1847123212/RK3588_hdk/README.md

# RK3588_hdk
RK3588_hdk quad A76 &amp; quad A53
