1847123212/RK3588_hdk/RK3588/01_Official Release/04_Product Line Branch_NVR/04_Demo Reference Design/RK_NVR_DEMO1_RK3588_LP4XD200P232SD8_V21_20211228_final_lint阻抗叠层.xls

Sheet: 1.6通孔
8层通孔1.6+/-0.16mm |  |  |  |  | Impedance | 40 ohm | 50 ohm | 80 ohm | 85 ohm | 90 ohm | 100 ohm
Layer | Mother Board | Typical layer thickness (mil) | Dielectric Constant | DF | Reference Layer | Design W(mil)
 | Solder Mask | 1.10
L1 | 1/3oz+plating | 1.20 |  |  | L1->L2 | 5 | 3.4 | 4->4 | 3.7->4.3 | 3.3->4.7 | 3->8
 | Prepreg (106) | 2.10 | 4.00 | 0.019 | L1->L3 |  | 22
L2 | copper | 1.20
 | Core | 10.00 | 4.2 | 0.015
L3 | copper | 1.20
 | Prepreg (1080 ) | 2.70 | 4.00 | 0.019
L4 | copper | 1.20 |  |  | L4->L3/L5 | 5.5 | 3.5 | 3.8->4.2 | 3.5->4.5 | 3.1->4.9 | 3->8
 | Core | 22.00 | 4.2 | 0.015
L5 | copper | 1.20
 | Prepreg (1080 ) | 2.70 | 4.00 | 0.019
L6 | copper | 1.20 |  |  | L6->L5/L7 | 5 | 3.2 | 3.8->4.2 | 3.4->4.6 | 3.0->5.0 | 3->10
 | Core | 10.00 | 4.2 | 0.015
L7 | copper | 1.20
 | Prepreg (106) | 2.10 | 4.00 | 0.019
L8 | 1/3oz+plating | 1.20 |  |  | L8->L7 | 5 | 3.4 | 4->4 | 3.7->4.3 | 3.3->4.7 | 3->8
 | Solder Mask | 1.10
 |  | 63.40
 |  | 1.61

Sheet: 阻抗计算
单端L1 /L8 40 Ohm | 单端L1 /L8 50 Ohm | L1 /L8 80 Ohm | L1 /L8 85 Ohm | L1 /L8 90 Ohm | L1 /L8 100 Ohm
单端L4 40 Ohm | 单端L4 50 Ohm | L4 80 Ohm | L4 85 Ohm | L4 90 Ohm | L4 100 Ohm
单端L6 40 Ohm | 单端L6 50 Ohm | L6 80 Ohm | L6 85 Ohm | L6 90 Ohm | L6 100 Ohm
 | 单端L1 50 Ohm
