1847123212/RK3588_hdk/RK3588/01_Official Release/02_DDR Template/02_H1R0_V10_20211230/RK3588_Template_LP4XD200P232SD8_41R0X41R0_2133MHz_H1R0_V10_20211230阻抗叠层.xls

Sheet: 1.0通孔
8层通孔1.0+/-0.1mm |  |  |  |  | Impedance | 40 ohm | 50 ohm | 80 ohm | 85 ohm | 90 ohm | 100 ohm
Layer | Mother Board | Typical layer thickness (mil) | Dielectric Constant | DF | Reference Layer | Design W(mil)
 | Solder Mask | 1.10
L1 | 1/3oz+plating | 1.20 |  |  | L1->L2 | 5 | 3.4 | 4->4 | 3.7->4.3 | 3.3->4.7 | 3->8
 | Prepreg (106) | 2.10 | 4.00 | 0.019 | L1->L3 |  | 13
L2 | copper | 1.20
 | Core | 5.00 | 4.2 | 0.015
L3 | copper | 1.20
 | Prepreg (2116 ) | 3.50 | 4.00 | 0.019
L4 | copper | 1.20 |  |  | L4->L3/L5 | 5.5 | 3.8 | 4.1->3.9 | 3.7->4.3 | 3.4->4.6 | 3.2->7.8
 | Core | 8.00 | 4.2 | 0.015
L5 | copper | 1.20
 | Prepreg (2116 ) | 3.50 | 4.00 | 0.019
L6 | copper | 1.20 |  |  | L6->L5/L7 | 5 | 3 | 3.9->4.1 | 3.5->4.5 | 3.2->4.8 | 3->10
 | Core | 5.00 | 4.2 | 0.015
L7 | copper | 1.20
 | Prepreg (106) | 2.10 | 4.00 | 0.019
L8 | 1/3oz+plating | 1.20 |  |  | L8->L7 | 5 | 3.4 | 4->4 | 3.7->4.3 | 3.3->4.7 | 3->8
 | Solder Mask | 1.10
 |  | 41.00
 |  | 1.04

Sheet: 阻抗计算
单端L1 /L8 40 Ohm | 单端L1 /L8 50 Ohm |  | L1 /L8 80 Ohm | L1 /L8 85 Ohm | L1 /L8 90 Ohm | L1 /L8 100 Ohm
单端L4 40 Ohm | 单端L4 50 Ohm |  | L4 80 Ohm | L4 85 Ohm | L4 90 Ohm | L4 100 Ohm
单端L6 40 Ohm | 单端L6 50 Ohm |  | L6 80 Ohm | L6 85 Ohm | L6 90 Ohm | L6 100 Ohm
 | 单端L1 50 Ohm | 参考第三层
