1847123212/RK3588_hdk/RK3588/01_Official Release/03_Product Line Branch_AIoT/03_Reference Design/01_RK3588_AIoT_REF_SCH/RK3588_AIOT_REF_SCH_V10_20211228.pdf

# Reference Schematics For RK3588

# RK3588_AIOT_REF_SCH_V10

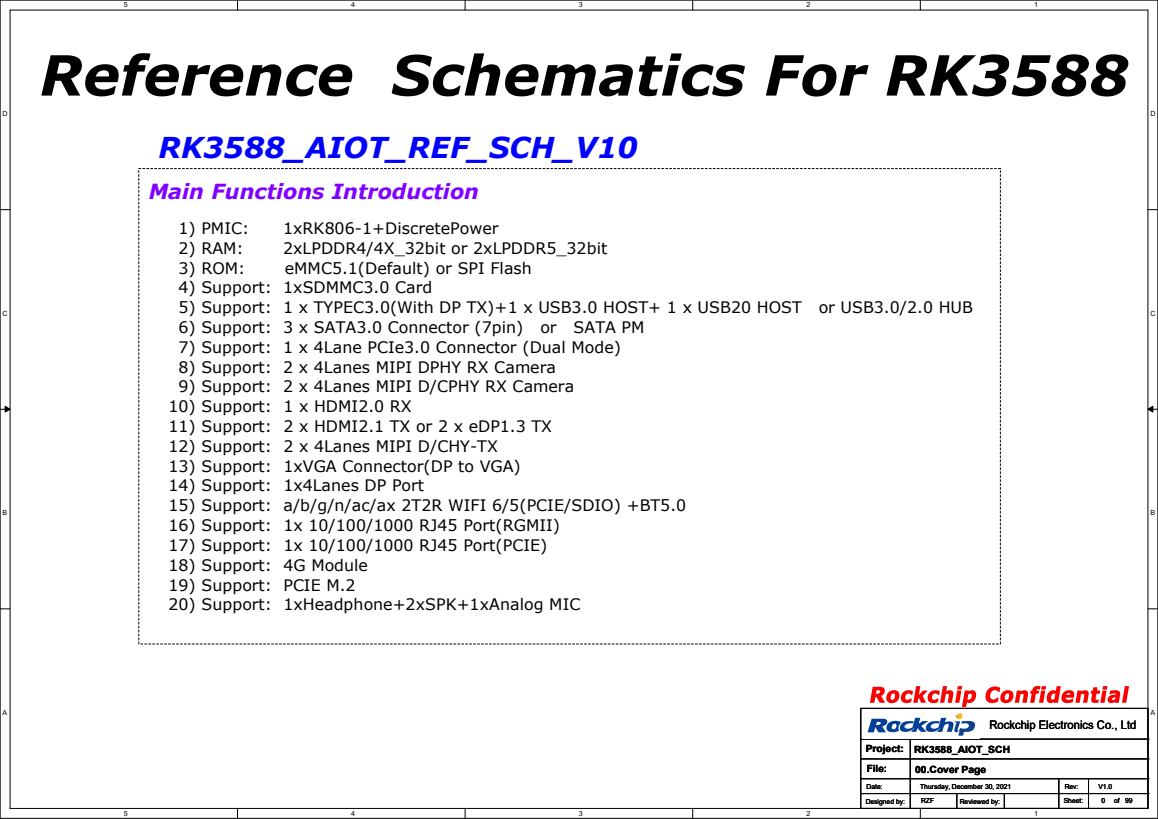
[picture p1: page 1]
1) PMIC:; 1xRK806-1+DiscretePower; 2) RAM:; 2xLPDDR4/4X_32bit or 2xLPDDR5_32bit; 3) ROM:; eMMC5.1(Default) or SPI Flash; Project:; File: Date:; Rockchip Electronics Co., Ltd; Designed by:; Rev: Reviewed by:; Sheet:; of Thursday, December 30, 2021; 00.Cover Page; RK3588_AIOT_SCH; RZF; 99 V1.0 Project:

Main Functions Introduction

4) Support: 1xSDMMC3.0 Card
5) Support: 1 x TYPEC3.0(With DP TX)+1 x USB3.0 HOST+ 1 x USB20 HOST or USB3.0/2.0 HUB
6) Support: 3 x SATA3.0 Connector (7pin) or SATA PM
7) Support: 1 x 4Lane PCIe3.0 Connector (Dual Mode)
8) Support: 2 x 4Lanes MIPI DPHY RX Camera
9) Support: 2 x 4Lanes MIPI D/CPHY RX Camera
10) Support: 1 x HDMI2.0 RX
11) Support: 2 x HDMI2.1 TX or 2 x eDP1.3 TX
12) Support: 2 x 4Lanes MIPI D/CHY-TX
13) Support: 1xVGA Connector(DP to VGA)
14) Support: 1x4Lanes DP Port
15) Support: a/b/g/n/ac/ax 2T2R WIFI 6/5(PCIE/SDIO) +BT5.0
16) Support: 1x 10/100/1000 RJ45 Port(RGMII)
17) Support: 1x 10/100/1000 RJ45 Port(PCIE)
18) Support: 4G Module
19) Support: PCIE M.2
20) Support: 1xHeadphone+2xSPK+1xAnalog MIC

# Table of Content

# Page 2

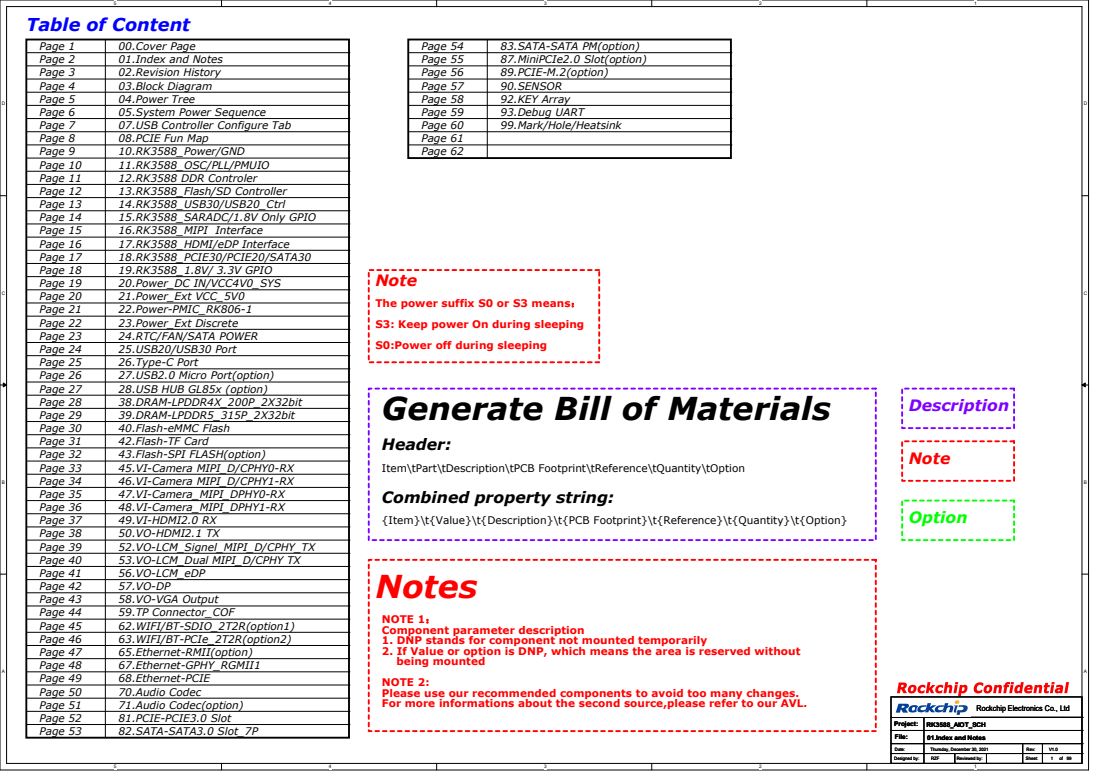
[picture p2: page 2]
Header:; Page 3 Page 4 Page 5 Page 6 Page 7 Page 8 Page 9 Page 10 Page 11 Page 12 Page 13 Page 14 Page 15 Page 16 Page 17 Page 18 Page 19 Page 20 Page 21 Page 22 Page 23 Page 24 Page 25 Page 26 Page 27 Page 28 Page 29 Page 30 Page 31 Page 32 Page 33 Page 34 Page 35 Page 36 Page 37 Page 38; Page 1; Page 39 Page 40 Page 41 Page 42 Page 43 Page 44; Note; Option; Description; Page 45 Page 46 Page 47 Page 48; Page 50 Page 51 Page 52 Page 53; Page 54; Page 56 Page 57 Page 58; Page 55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

00.Cover Page
01.Index and Notes
02.Revision History
03.Block Diagram
04.Power Tree
05.System Power Sequence
07.USB Controller Configure Tab
08.PCIE Fun Map
10.RK3588_Power/GND
11.RK3588_OSC/PLL/PMUIO
12.RK3588 DDR Controler
13.RK3588_Flash/SD Controller
14.RK3588_USB30/USB20_Ctrl
15.RK3588_SARADC/1.8V Only GPIO
16.RK3588_MIPI Interface
17.RK3588_HDMI/eDP Interface
18.RK3588_PCIE30/PCIE20/SATA30
19.RK3588_1.8V/ 3.3V GPIO
20.Power_DC IN/VCC4V0_SYS
21.Power_Ext VCC_5V0
22.Power-PMIC_RK806-1
23.Power_Ext Discrete
24.RTC/FAN/SATA POWER
25.USB20/USB30 Port
26.Type-C Port
27.USB2.0 Micro Port(option)
28.USB HUB GL85x (option)
38.DRAM-LPDDR4X_200P_2X32bit
39.DRAM-LPDDR5_315P_2X32bit
40.Flash-eMMC Flash
42.Flash-TF Card
43.Flash-SPI FLASH(option)
45.VI-Camera MIPI_D/CPHY0-RX
46.VI-Camera MIPI_D/CPHY1-RX
47.VI-Camera_MIPI_DPHY0-RX
48.VI-Camera_MIPI_DPHY1-RX
49.VI-HDMI2.0 RX
50.VO-HDMI2.1 TX
52.VO-LCM_Signel_MIPI_D/CPHY_TX
53.VO-LCM_Dual MIPI_D/CPHY TX
56.VO-LCM_eDP
58.VO-VGA Output
59.TP Connector_COF
62.WIFI/BT-SDIO_2T2R(option1)
63.WIFI/BT-PCIe_2T2R(option2)
65.Ethernet-RMII(option)
67.Ethernet-GPHY_RGMII1
68.Ethernet-PCIE
70.Audio Codec
71.Audio Codec(option)
81.PCIE-PCIE3.0 Slot
82.SATA-SATA3.0 Slot_7P

83.SATA-SATA PM(option)
87.MiniPCIe2.0 Slot(option)
89.PCIE-M.2(option)
90.SENSOR
92.KEY Array
93.Debug UART
99.Mark/Hole/Heatsink

The power suffix S0 or S3 means：
S3: Keep power On during sleeping
S0:Power off during sleeping
Generate Bill of Materials

Item\tPart\tDescription\tPCB Footprint\tReference\tQuantity\tOption
Combined property string:

{Item}\t{Value}\t{Description}\t{PCB Footprint}\t{Reference}\t{Quantity}\t{Option}
Notes

NOTE 1：
Component parameter description
1. DNP stands for component not mounted temporarily
2. If Value or option is DNP, which means the area is reserved without
being mounted
NOTE 2:
Please use our recommended components to avoid too many changes.
For more informations about the second source,please refer to our AVL.

01.Index and Notes RK3588_AIOT_SCH

# Revision History

# Version

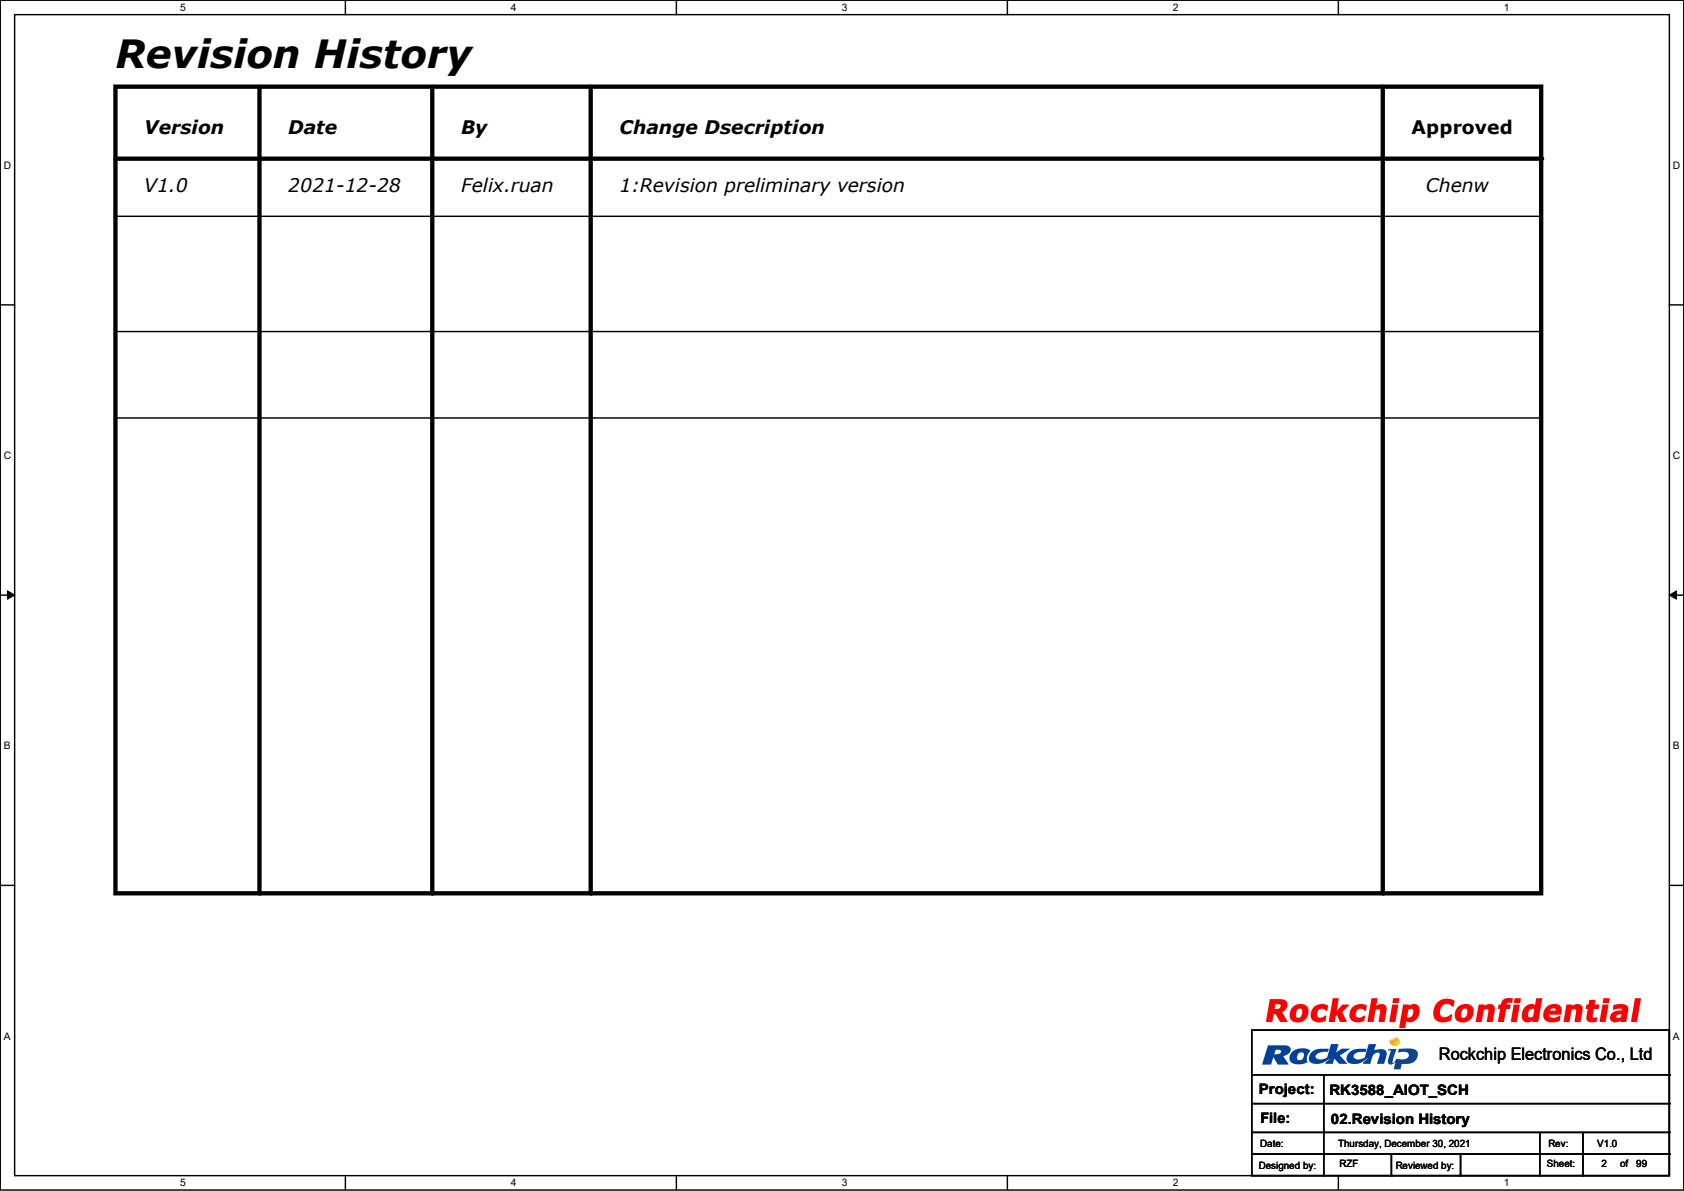
[picture p3: page 3]
Date; Change Dsecription; Approved; Felix.ruan; Chenw 1:Revision preliminary version; Project:; File: Date:; Rockchip Electronics Co., Ltd; 02.Revision History; RK3588_AIOT_SCH; RZF; 99 V1.0 Project:

# VGA Port USB2.0_HOST

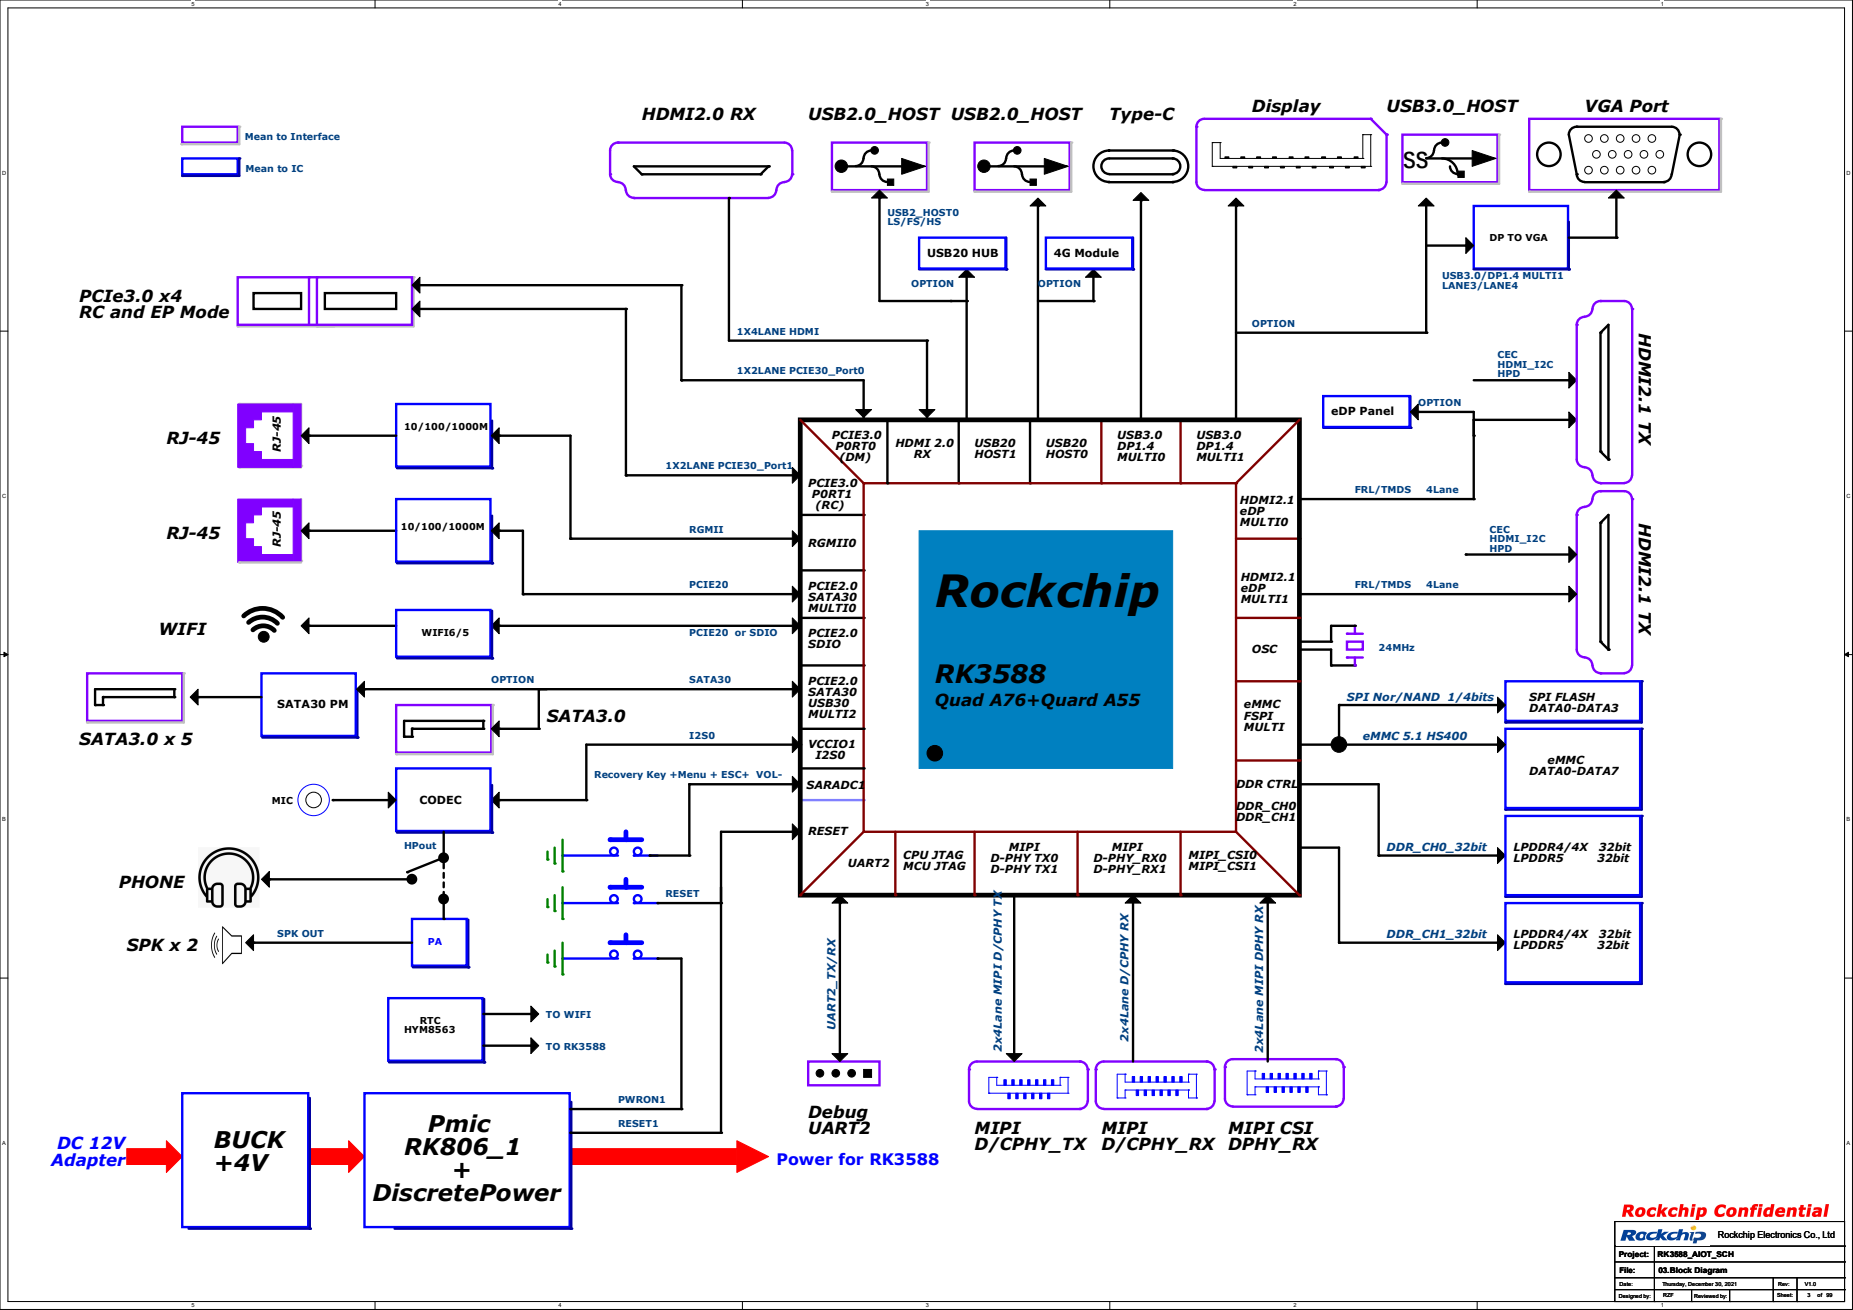
[picture p4: page 4]
RESET; Pmic RK806_1 + DiscretePower; Power for RK3588; SATA3.0 x 5; Rockchip; Quad A76+Quard A55; HDMI2.1 eDP MULTI0; USB20 HOST0; OSC; VCCIO1 I2S0; SARADC1; UART2; DDR CTRL; DDR_CH0 DDR_CH1; 24MHz; DC 12V Adapter; Recovery Key +Menu + ESC+ VOL-; 2x4Lane MIPI DPHY RX; HDMI2.1 eDP MULTI1; CEC HDMI_I2C; HPD; HDMI2.1 TX; eMMC FSPI; MULTI; HDMI2.1 TX CEC; HDMI_I2C HPD; USB3.0 DP1.4 MULTI0; USB3.0 DP1.4 MULTI1; USB3.0_HOST; USB3.0/DP1.4 MULTI1 LANE3/LANE4; FRL/TMDS; 4Lane; DDR_CH0_32bit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

Mean to Interface

Mean to IC

USB2_HOST0

DP TO VGA

PCIe3.0 x4
RC and EP Mode

SPI Nor/NAND 1/4bits

# Power Tree

# 3000mA or

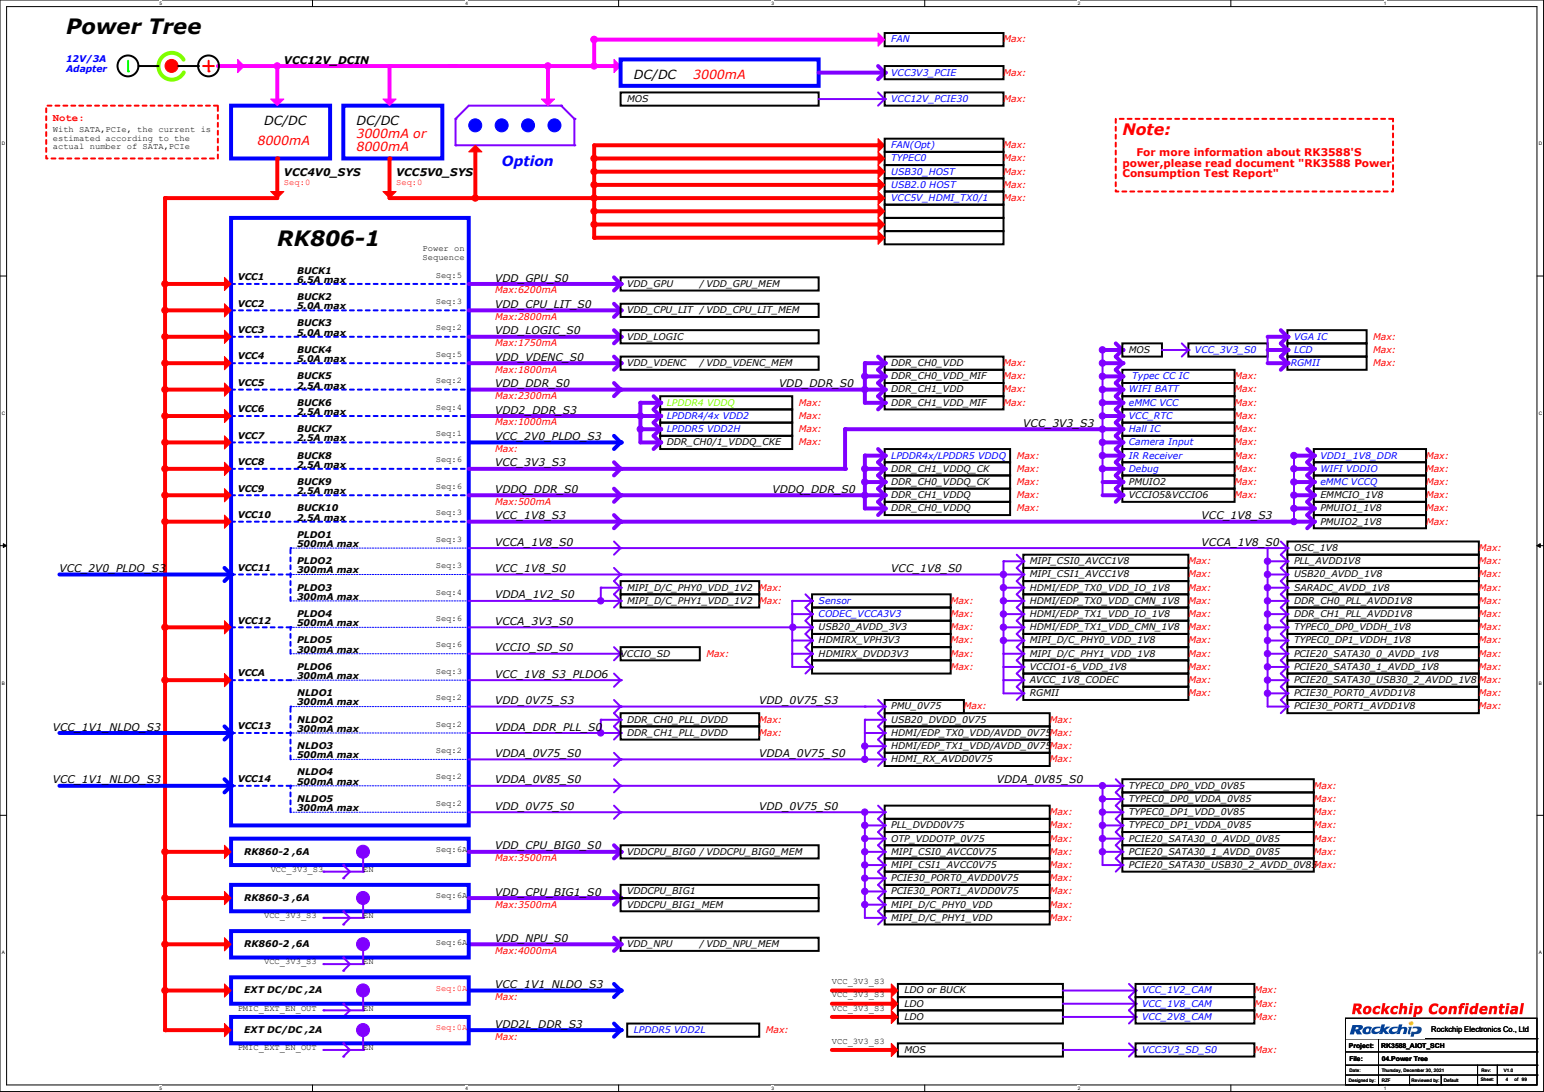
[picture p5: page 5]
12V/3A Adapter; VCC12V_DCIN; Seq:0; Option; USB2.0 HOST; VCC5V_HDMI_TX0/1; Max:; USB30_HOST; TYPEC0; VCC5V0_SYS; actual number of SATA,PCIe; VCC4V0_SYS; FAN(Opt); DDR_CH0_VDD_MIF; DDR_CH0_VDD; DDR_CH1_VDD_MIF; DDR_CH1_VDD; VCC_3V3_S3; Max: Max: Max: Max:; DDR_CH0/1_VDDQ_CKE; Power on Sequence; Seq:3; Seq:5; LPDDR4/4x VDD2; LPDDR4 VDDQ Seq:2; VCC1; BUCK3 5.0A max; BUCK4 5.0A max; BUCK1 6.5A max; VCC2; BUCK2; 5.0A max; VCC3; VCC4; Seq:4; Seq:2; Seq:1; VCC5; BUCK7 2.5A max; BUCK8; 2.5A max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

Note: With SATA,PCIe, the current is

DC/DC Seq:0

estimated according to the

For more information about RK3588'S
power,please read document "RK3588 Power
Consumption Test Report"

Typec CC IC
WIFI BATT
eMMC VCC
VCC_RTC
Hall IC
Camera Input
IR Receiver
Debug
PMUIO2

LDO or BUCK

# Power Sequence

Power Supply | PMIC Channel | Supply Limit | Power Name | Time Slot | Default Voltage | Default ON/OFF | Sleep ON/OFF | Peak Current | Sleep Current

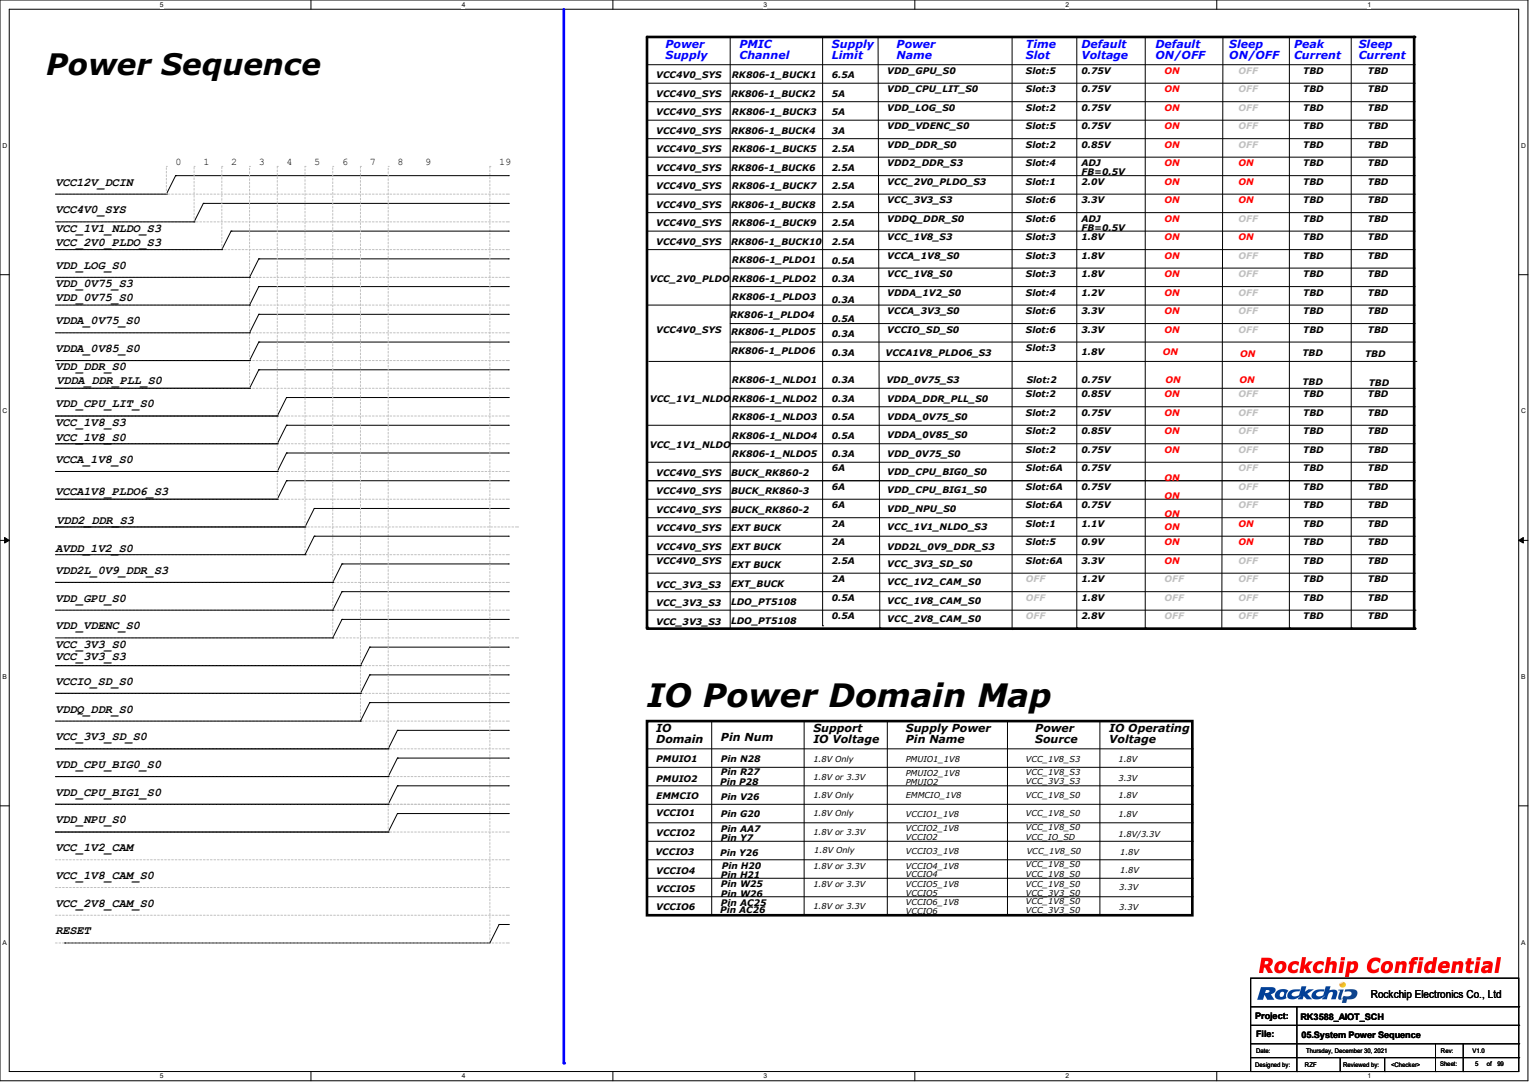
[picture p6: page 6]
VDDA_0V75_S0; VDD_DDR_S0; TBD TBD; TBD; RK806-1_BUCK5; RK806-1_NLDO3; VCC4V0_SYS; OFF; IO Domain; Supply Power; Pin Num; Pin Name; PMUIO1; IO Operating Voltage; Power Source; Support IO Voltage; Pin N28; PMUIO1_1V8; VCC_1V8_S3; PMUIO2; EMMCIO; VCCIO1; VCCIO2; VCCIO4; VCCIO5; VCCIO6; PMUIO2_1V8 PMUIO2 EMMCIO_1V8; VCCIO1_1V8 VCCIO2_1V8 VCCIO2; VCCIO4_1V8 VCCIO4 VCCIO5_1V8 VCCIO5; VCCIO6_1V8; VCC_1V8_S3 VCC_3V3_S3 VCC_1V8_S0; VCC_1V8_S0 VCC_1V8_S0; Pin P28; Pin R27; Pin V26; Pin Y7; Pin AA7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

VCC4V0_SYS | RK806-1_BUCK1 | 6.5A | VDD_GPU_S0 | Slot:5 | 0.75V | ON | OFF | TBD | TBD
VCC4V0_SYS | RK806-1_BUCK2 | 5A | VDD_CPU_LIT_S0 | Slot:3 | 0.75V | ON | OFF | TBD | TBD
VCC4V0_SYS | RK806-1_BUCK3 | 5A | VDD_LOG_S0 | Slot:2 | 0.75V | ON | OFF | TBD | TBD
VCC4V0_SYS | RK806-1_BUCK4 | 3A | VDD_VDENC_S0 | Slot:5 | 0.75V | ON | OFF | | TBD

VCC4V0_SYS | RK806-1_BUCK6 | 2.5A | VDD2_DDR_S3 | Slot:4 | ADJ FB=0.5V | ON | ON | TBD | TBD
VCC4V0_SYS | RK806-1_BUCK7 | 2.5A | VCC_2V0_PLDO_S3 | Slot:1 | 2.0V | ON | ON | TBD | TBD
VCC4V0_SYS | RK806-1_BUCK8 | 2.5A | VCC_3V3_S3 | Slot:6 | 3.3V | ON | ON | | TBD
VCC4V0_SYS | RK806-1_BUCK9 | 2.5A | VDDQ_DDR_S0 | Slot:6 | ADJ FB=0.5V | ON | OFF | | TBD
VCC4V0_SYS | RK806-1_BUCK10 | 2.5A | VCC_1V8_S3 | Slot:3 | 1.8V | ON | ON | TBD | TBD
VCC_2V0_PLDO | RK806-1_PLDO1 | 0.5A | VCCA_1V8_S0 | Slot:3 | 1.8V | ON | OFF | | TBD

RK806-1_PLDO2 | 0.3A | VCC_1V8_S0 | Slot:3 | 1.8V | ON | OFF | | TBD
RK806-1_PLDO3 | 0.3A | VDDA_1V2_S0 | Slot:4 | 1.2V | ON | OFF | TBD | TBD

VCC4V0_SYS | RK806-1_PLDO4 | 0.5A | VCCA_3V3_S0 | Slot:6 | 3.3V | ON | OFF | TBD | TBD

RK806-1_PLDO5 | 0.3A | VCCIO_SD_S0 | Slot:6 | 3.3V | ON | OFF | TBD | TBD
RK806-1_PLDO6 | 0.3A | VCCA1V8_PLDO6_S3 | Slot:3 | 1.8V | ON | ON | TBD | TBD

VCC_1V1_NLDO | RK806-1_NLDO1 | 0.3A | VDD_0V75_S3 | Slot:2 | 0.75V | ON | ON | TBD | TBD

RK806-1_NLDO2 | 0.3A | VDDA_DDR_PLL_S0 | Slot:2 | 0.85V | ON | OFF | TBD | TBD

VCC_1V1_NLDO | RK806-1_NLDO4 | 0.5A | VDDA_0V85_S0 | Slot:2 | 0.85V | ON | OFF | TBD | TBD

RK806-1_NLDO5 | 0.3A | VDD_0V75_S0 | Slot:2 | 0.75V | ON | OFF | TBD | TBD

VCC4V0_SYS | BUCK_RK860-2 | 6A | VDD_CPU_BIG0_S0 | Slot:6A | 0.75V | ON | OFF | TBD | TBD
VCC4V0_SYS | BUCK_RK860-3 | 6A | VDD_CPU_BIG1_S0 | Slot:6A | 0.75V | ON | OFF | TBD | TBD
VCC4V0_SYS | BUCK_RK860-2 | 6A | VDD_NPU_S0 | Slot:6A | 0.75V | ON | OFF | TBD | TBD
VCC4V0_SYS | EXT BUCK | 2A | VCC_1V1_NLDO_S3 | Slot:1 | 1.1V | ON | ON | TBD | TBD
EXT BUCK | 2A VCC4V0_SYS | VDD2L_0V9_DDR_S3 | Slot:5 | 0.9V | ON | ON | TBD | TBD
2.5A | VCC_3V3_SD_S0 | Slot:6A | 3.3V EXT BUCK VCC4V0_SYS | ON | OFF | TBD | TBD
VCC_3V3_S3 | EXT_BUCK | 2A | VCC_1V2_CAM_S0 | OFF | 1.2V | OFF | OFF | TBD | TBD
VCC_3V3_S3 | LDO_PT5108 | 0.5A | VCC_1V8_CAM_S0 | OFF | 1.8V | OFF | OFF | TBD | TBD
VCC_3V3_S3 | LDO_PT5108 | 0.5A | VCC_2V8_CAM_S0 | OFF | 2.8V | OFF | OFF | TBD | TBD

IO Power Domain Map

RK3588_AIOT_SCH
05.System Power Sequence

USB Controller Configure Table | Controller

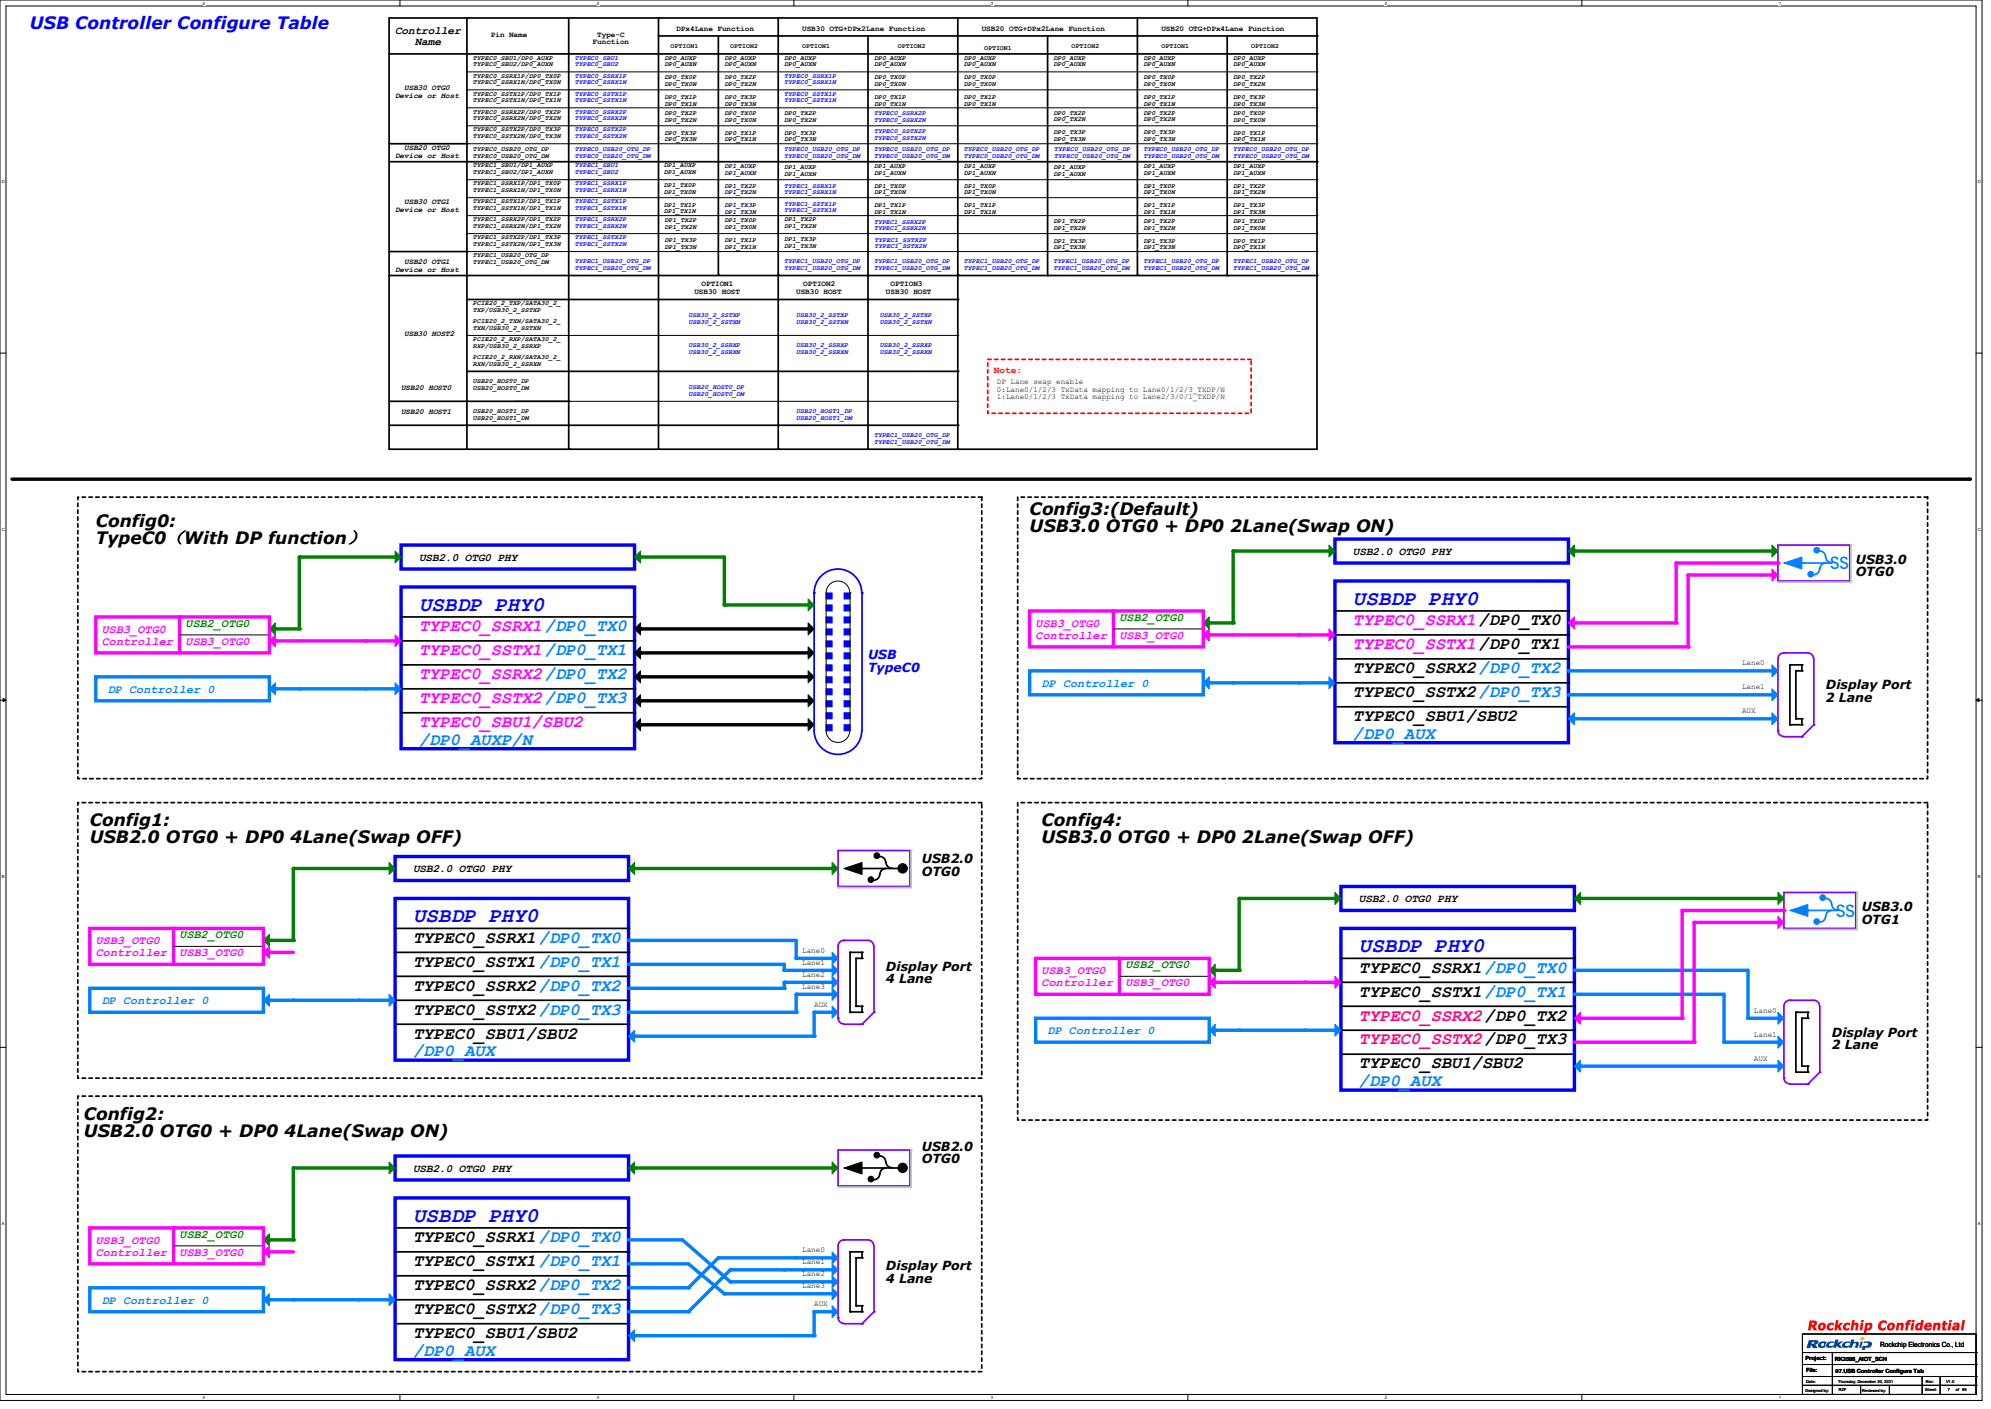
[picture p7: page 7]
Name; Type-C Function; USB30 OTG+DPx2Lane Function; DPx4Lane Function; Pin Name; USB30 HOST2; USB20 HOST0; USB20 HOST1; USB20_HOST0_DP USB20_HOST0_DM; USB20_HOST1_DP USB20_HOST1_DM; DP0_AUXP DP0_AUXN; OPTION1; OPTION2; USB20 OTG+DPx2Lane Function; TYPEC0_USB20_OTG_DP TYPEC0_USB20_OTG_DM; TYPEC0_SBU1/DP0_AUXP TYPEC0_SBU2/DP0_AUXN; TYPEC0_SSRX1P/DP0_TX0P TYPEC0_SSRX1N/DP0_TX0N; TYPEC0_SSTX1P/DP0_TX1P TYPEC0_SSTX1N/DP0_TX1N; TYPEC0_SSRX2P/DP0_TX2P TYPEC0_SSRX2N/DP0_TX2N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

USB30 OTG0
Device or Host

USB20 OTG0

USB30 OTG1

USB20 OTG1

PCIE20_2_TXP/SATA30_2_ TXP/USB30_2_SSTXP PCIE20_2_TXN/SATA30_2_ TXN/USB30_2_SSTXN | USB30_2_SSTXP USB30_2_SSTXN | USB30_2_SSTXP USB30_2_SSTXN | USB30_2_SSTXP USB30_2_SSTXN

PCIE20_2_RXP/SATA30_2_ RXP/USB30_2_SSRXP PCIE20_2_RXN/SATA30_2_ RXN/USB30_2_SSRXN | USB30_2_SSRXP USB30_2_SSRXN | USB30_2_SSRXP USB30_2_SSRXN | USB30_2_SSRXP USB30_2_SSRXN

Note: DP Lane swap enable

0:Lane0/1/2/3 TxData mapping to Lane0/1/2/3_TXDP/N
1:Lane0/1/2/3 TxData mapping to Lane2/3/0/1_TXDP/N

Config0:
TypeC0（With DP function）

07.USB Controller Configure Tab RK3588_AIOT_SCH

PCIe/SATA Connecter Diagram | PCIe Controller Configure Table Controller

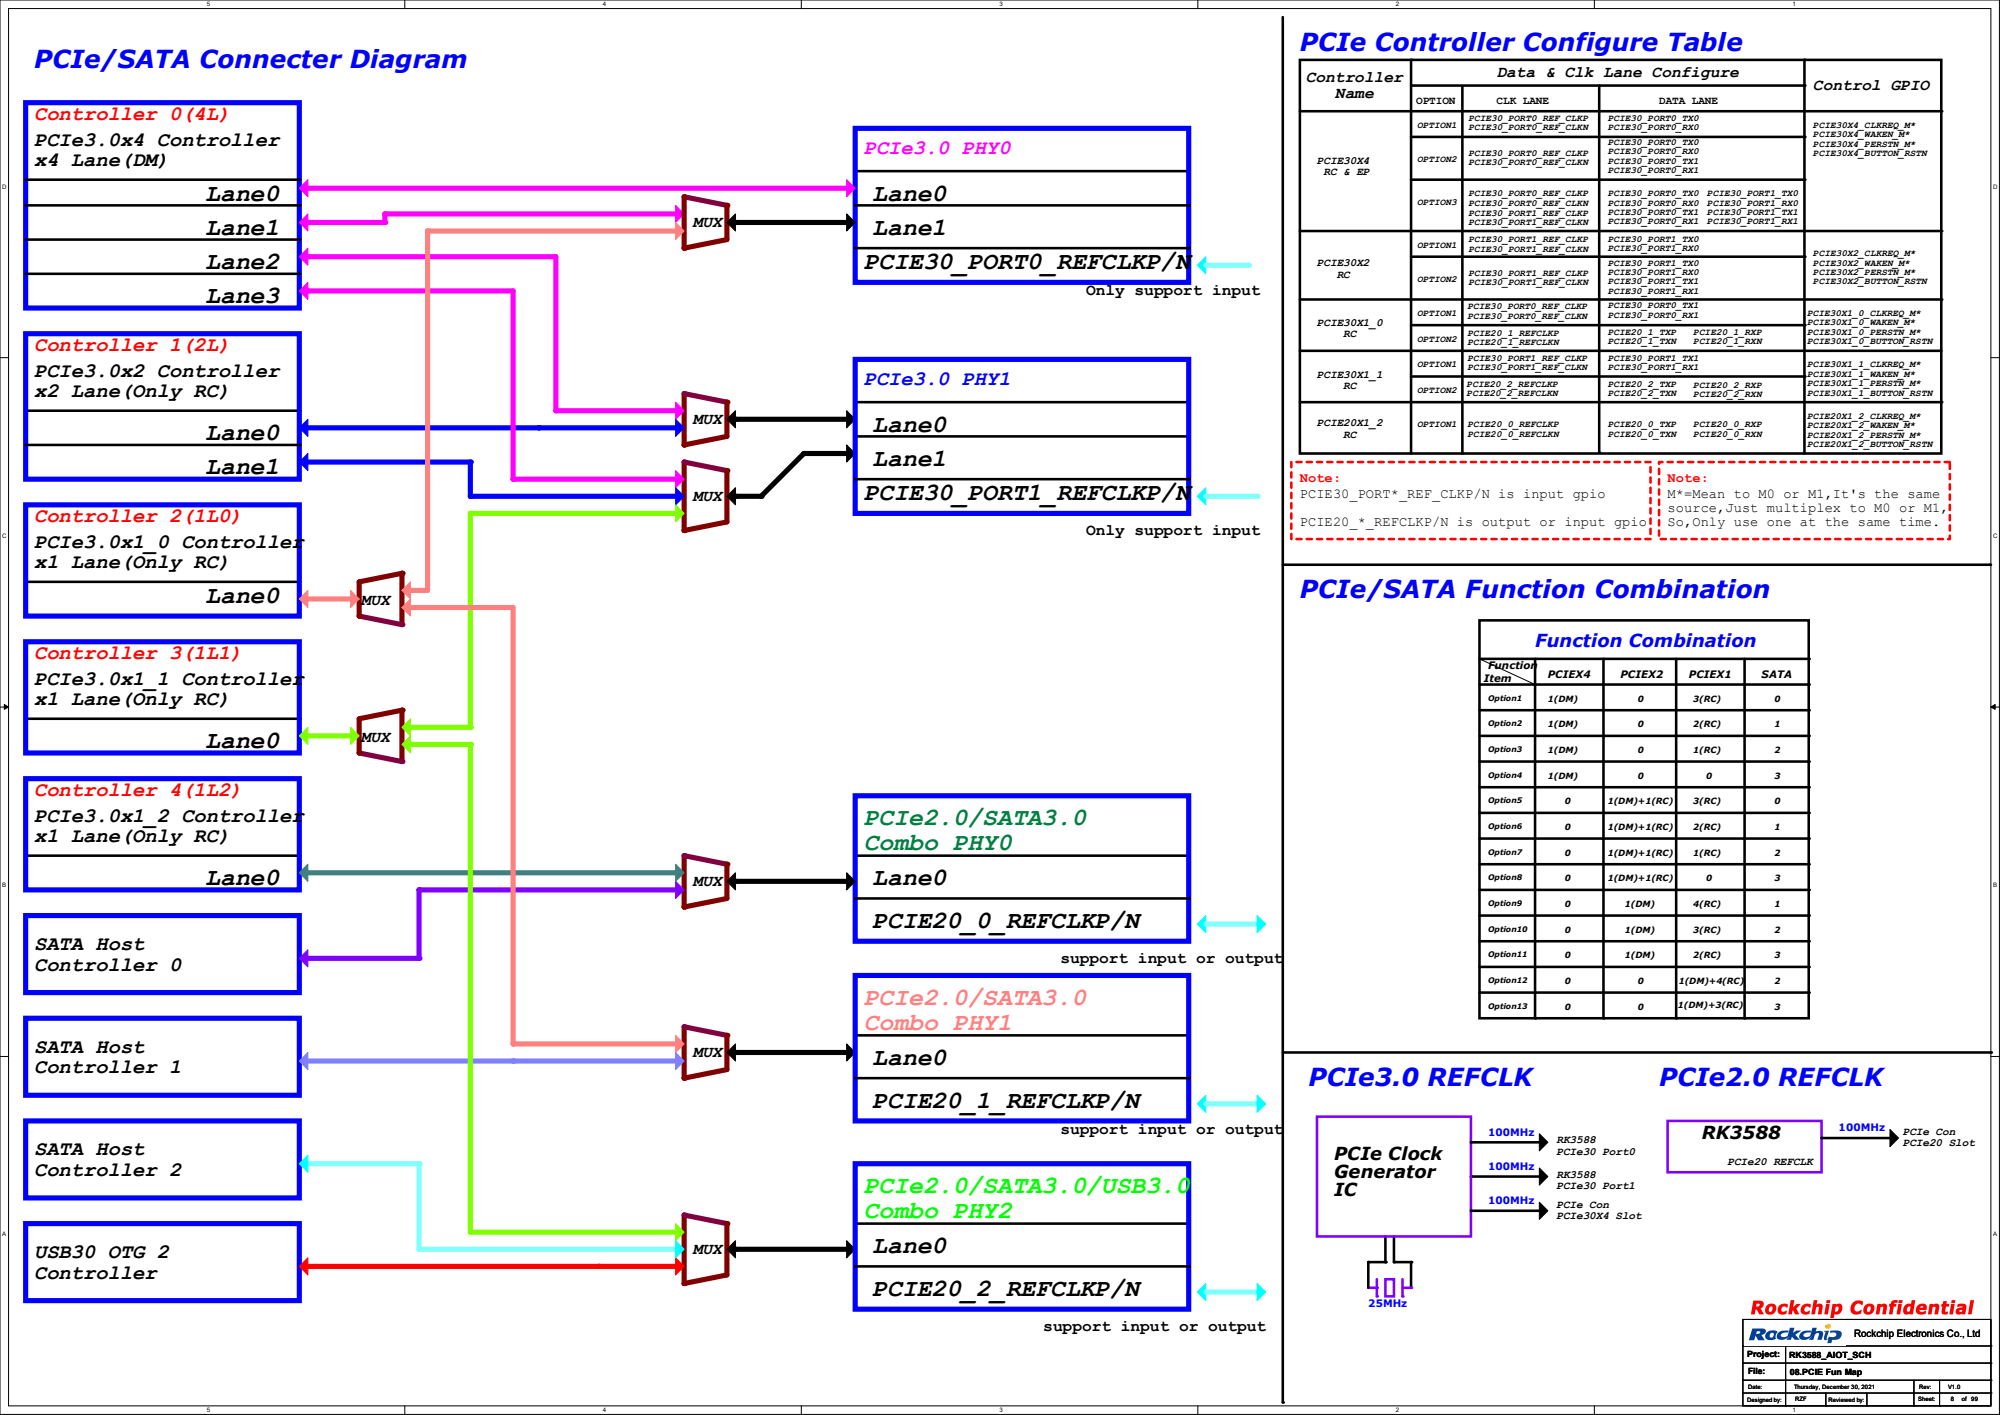
[picture p8: page 8]
PCIe2.0 REFCLK; 100MHz; PCIe Con; PCIe20 Slot RK3588; Function Combination; Option1; Item; Function; PCIEX4; PCIEX2; PCIEX1; SATA; Option2; Option3; Option4; Option5; Option6; Option7; Option8; Option9; Option10; Option11; Option12; Option13; PCIE30X4 RC & EP; PCIE30_PORT0_RX0; PCIE30X4_CLKREQ_M*; PCIE30X4_WAKEN_M* PCIE30X4_PERSTN_M* PCIE30X4_BUTTON_RSTN; PCIE30X2 RC; Name; Control GPIO; PCIE30X2_CLKREQ_M* PCIE30X2_WAKEN_M* PCIE30X2_PERSTN_M* PCIE30X2_BUTTON_RSTN; PCIE30X1_0 RC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

Data & Clk Lane Configure

OPTION OPTION1 | CLK LANE PCIE30_PORT0_REF_CLKP PCIE30_PORT0_REF_CLKN | DATA LANE PCIE30_PORT0_TX0

OPTION2 | PCIE30_PORT0_REF_CLKP PCIE30_PORT0_REF_CLKN | PCIE30_PORT0_TX0 PCIE30_PORT0_RX0 PCIE30_PORT0_TX1 PCIE30_PORT0_RX1

OPTION3 OPTION1 | PCIE30_PORT0_REF_CLKP PCIE30_PORT0_REF_CLKN PCIE30_PORT1_REF_CLKP PCIE30_PORT1_REF_CLKN PCIE30_PORT1_REF_CLKP PCIE30_PORT1_REF_CLKN | PCIE30_PORT0_TX0 PCIE30_PORT1_TX0 PCIE30_PORT0_RX0 PCIE30_PORT1_RX0 PCIE30_PORT0_TX1 PCIE30_PORT1_TX1 PCIE30_PORT0_RX1 PCIE30_PORT1_RX1 PCIE30_PORT1_TX0 PCIE30_PORT1_RX0

OPTION2 OPTION1 | PCIE30_PORT1_REF_CLKP PCIE30_PORT1_REF_CLKN PCIE30_PORT0_REF_CLKP PCIE30_PORT0_REF_CLKN | PCIE30_PORT1_TX0 PCIE30_PORT1_RX0 PCIE30_PORT1_TX1 PCIE30_PORT1_RX1 PCIE30_PORT0_TX1 PCIE30_PORT0_RX1

Only support input

OPTION2 OPTION1 | PCIE20_1_REFCLKP PCIE20_1_REFCLKN PCIE30_PORT1_REF_CLKP PCIE30_PORT1_REF_CLKN | PCIE20_1_TXP PCIE20_1_RXP PCIE20_1_TXN PCIE20_1_RXN PCIE30_PORT1_TX1 PCIE30_PORT1_RX1

Controller 1(2L)
PCIe3.0x2 Controller
x2 Lane(Only RC)

Note:
PCIE30_PORT*_REF_CLKP/N is input gpio
PCIE20_*_REFCLKP/N is output or input gpio

M*=Mean to M0 or M1,It's the same
source,Just multiplex to M0 or M1,
So,Only use one at the same time.

Controller 2(1L0)
PCIe3.0x1_0 Controller
x1 Lane(Only RC)

PCIe/SATA Function Combination

Controller 3(1L1)
PCIe3.0x1_1 Controller

Controller 4(1L2)
PCIe3.0x1_2 Controller

support input or output

08.PCIE Fun Map RK3588_AIOT_SCH

# RK3588_V(POWER)

## LOGIC

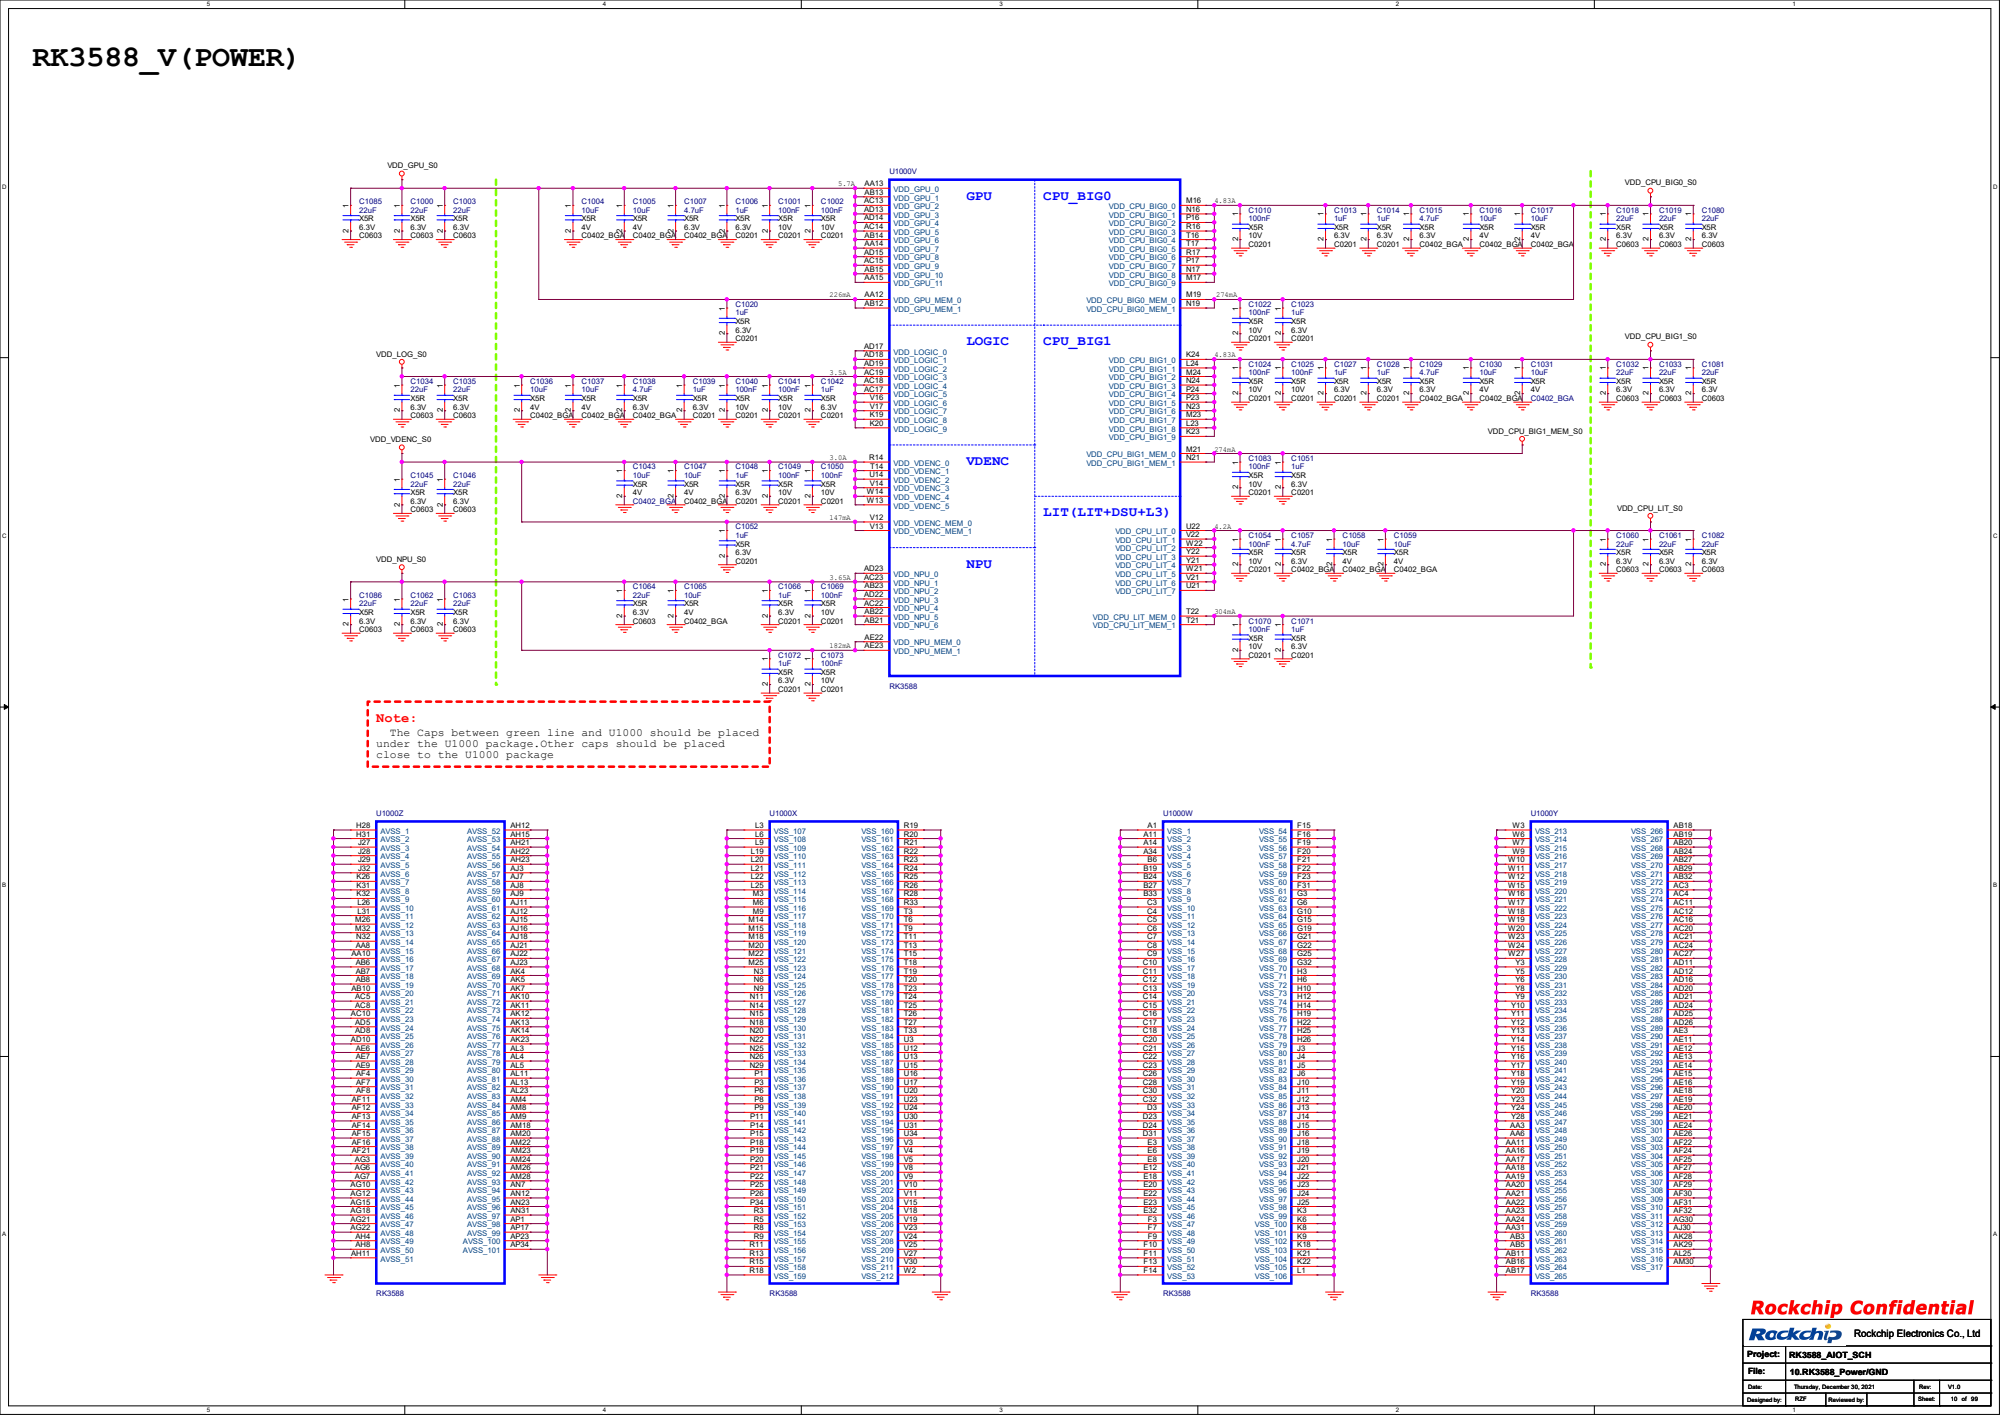
[picture p9: page 9]

close to the U1000 package VDD_NPU_S0 VDD_VDENC_S0

Note: The Caps between green line and U1000 should be placed

under the U1000 package.Other caps should be placed

# RK3588_E(OSC/PLL/PMUIO1/2)

## Adjusted the load capacitance

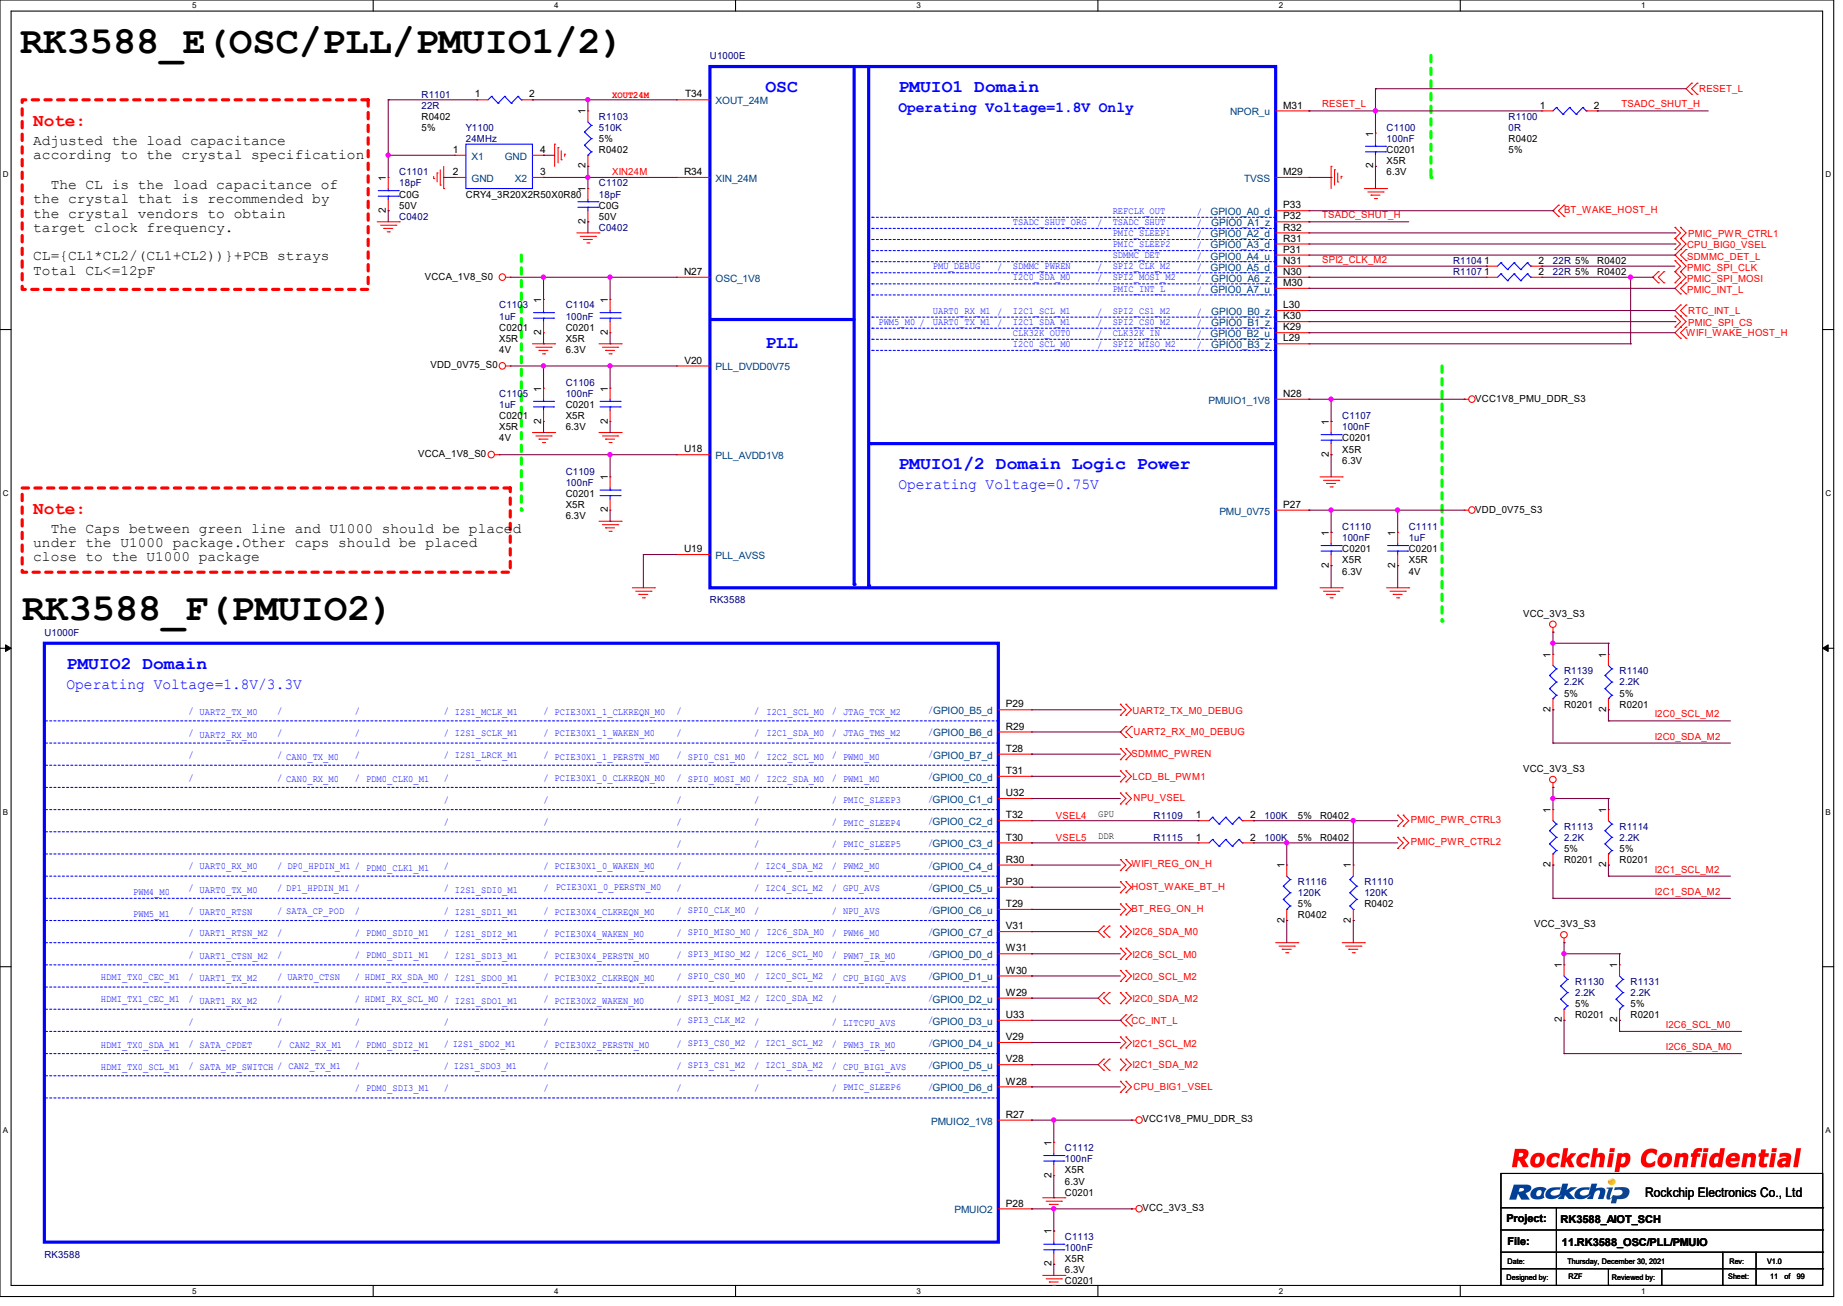
[picture p10: page 10]

according to the crystal specification
The CL is the load capacitance of
the crystal that is recommended by
the crystal vendors to obtain
target clock frequency.
CL={CL1*CL2/(CL1+CL2))}+PCB strays
Total CL<=12pF

Note:
The Caps between green line and U1000 should be placed
under the U1000 package.Other caps should be placed
close to the U1000 package

DDR_CH0_DQ0_A U1 DDR_CH0_DQ7_A U2 DDR_CH0_DQS0N_A U4 DDR_CH0_DQS0P_A U5 DDR_CH0_DQ6_A V1 DDR_CH0_DQ5_A V2 DDR_CH0_WCK0N_A V6 DDR_CH0_WCK0P_A V7 DDR_CH0_DQ4_A W1 DDR_CH0_WCK1P_A W4 DDR_CH0_WCK1N_A W5 DDR_CH0_ZQ_A W8

# DDR_CH0_DQ2_B J1 DDR_CH0_DQ1_B J2 DDR_CH0_DQS0N_B J7 DDR_CH0_DQS0P_B J8 DDR_CH0_A4_B K1

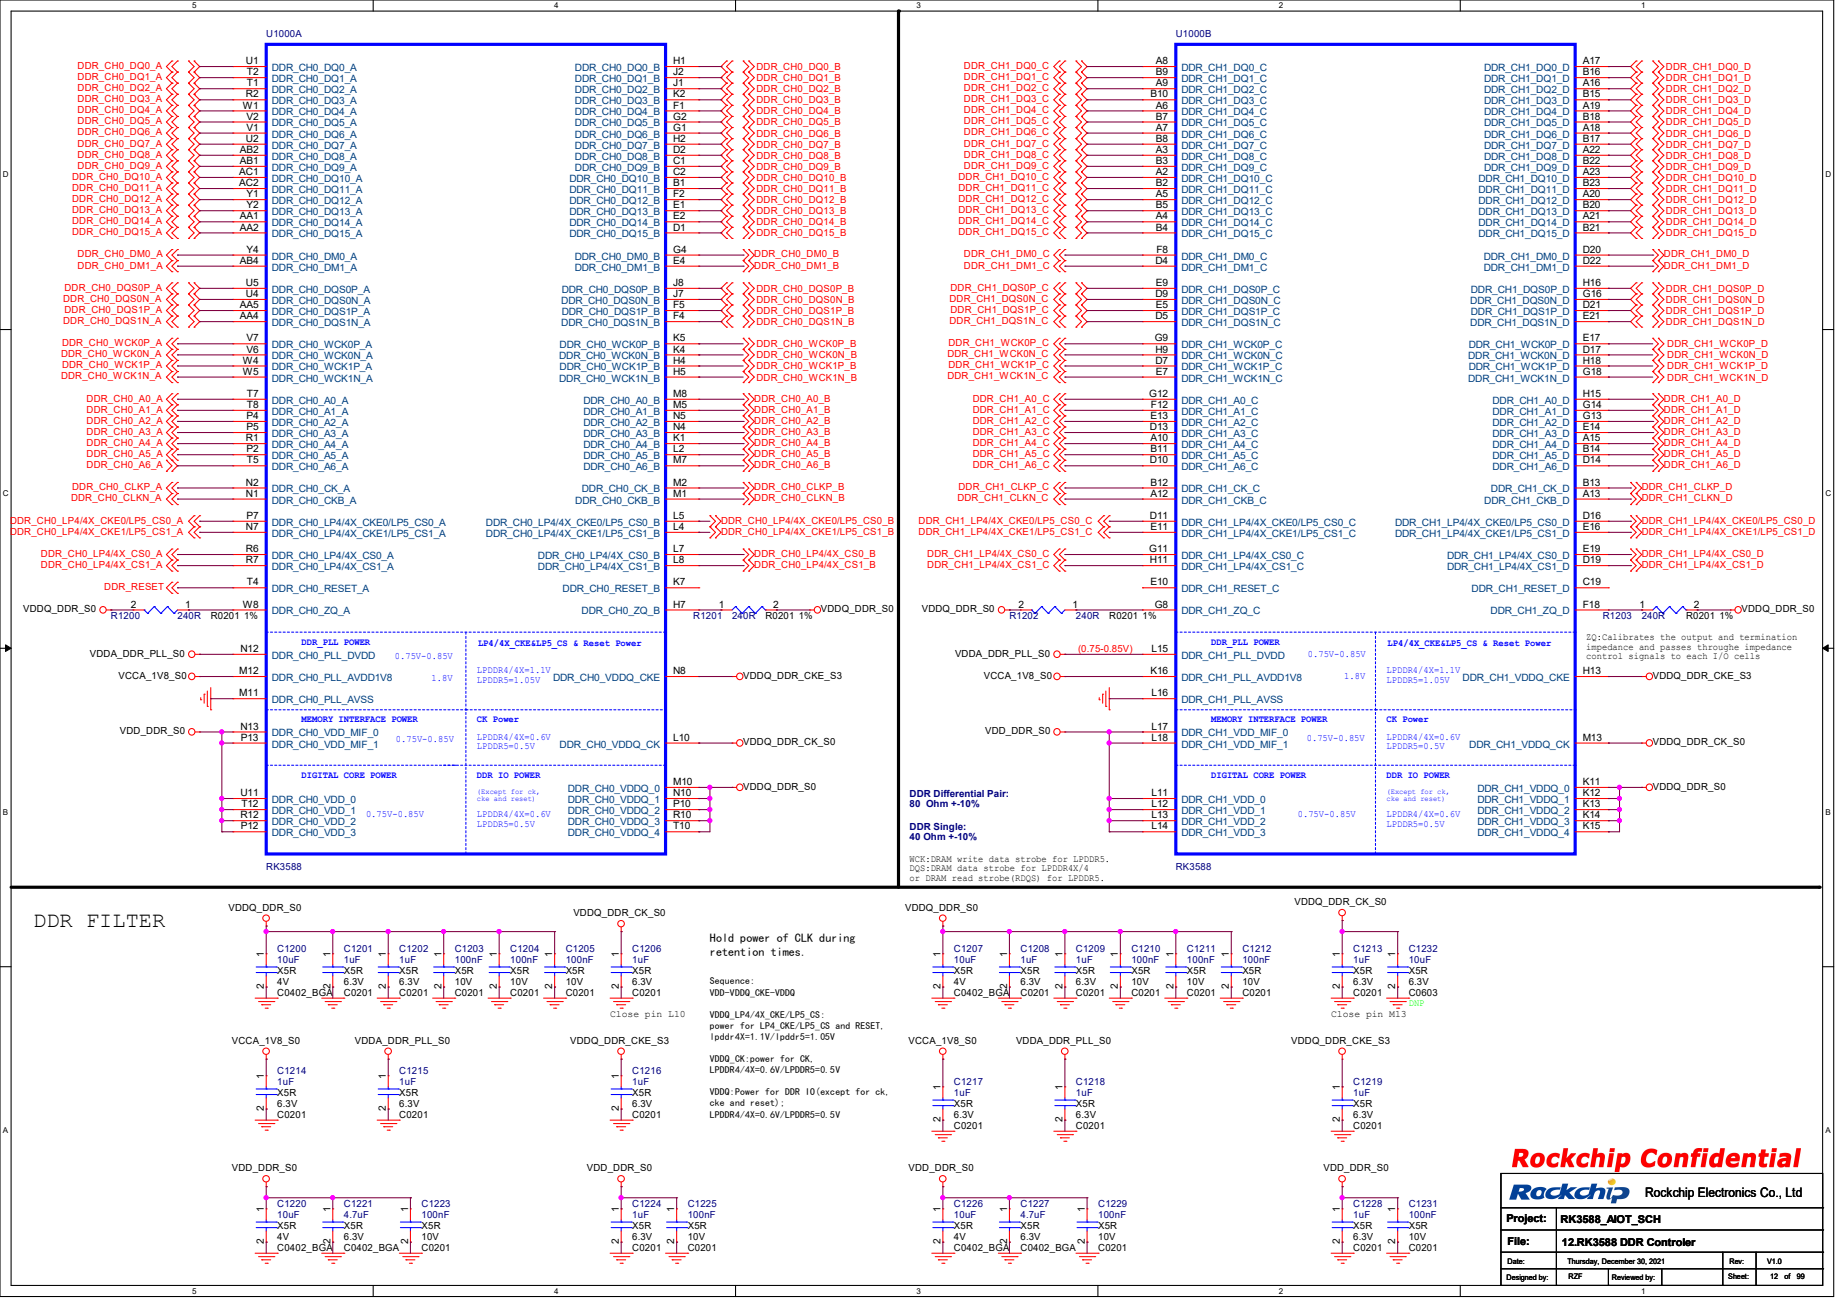
[picture p11: page 11]

ZQ:Calibrates the output and termination
impedance and passes throughe impedance
control signals to each I/O cells

DQS:DRAM data strobe for LPDDR4X/4
or DRAM read strobe(RDQS) for LPDDR5.

Hold power of CLK during
retention times.

power for LP4_CKE/LP5_CS and RESET,
lpddr4X=1.1V/lpddr5=1.05V

VDDQ:Power for DDR IO(except for ck,
cke and reset);
LPDDR4/4X=0.6V/LPDDR5=0.5V

# RK3588_C(EMMCIO Domain)

# Option:SPI Flash

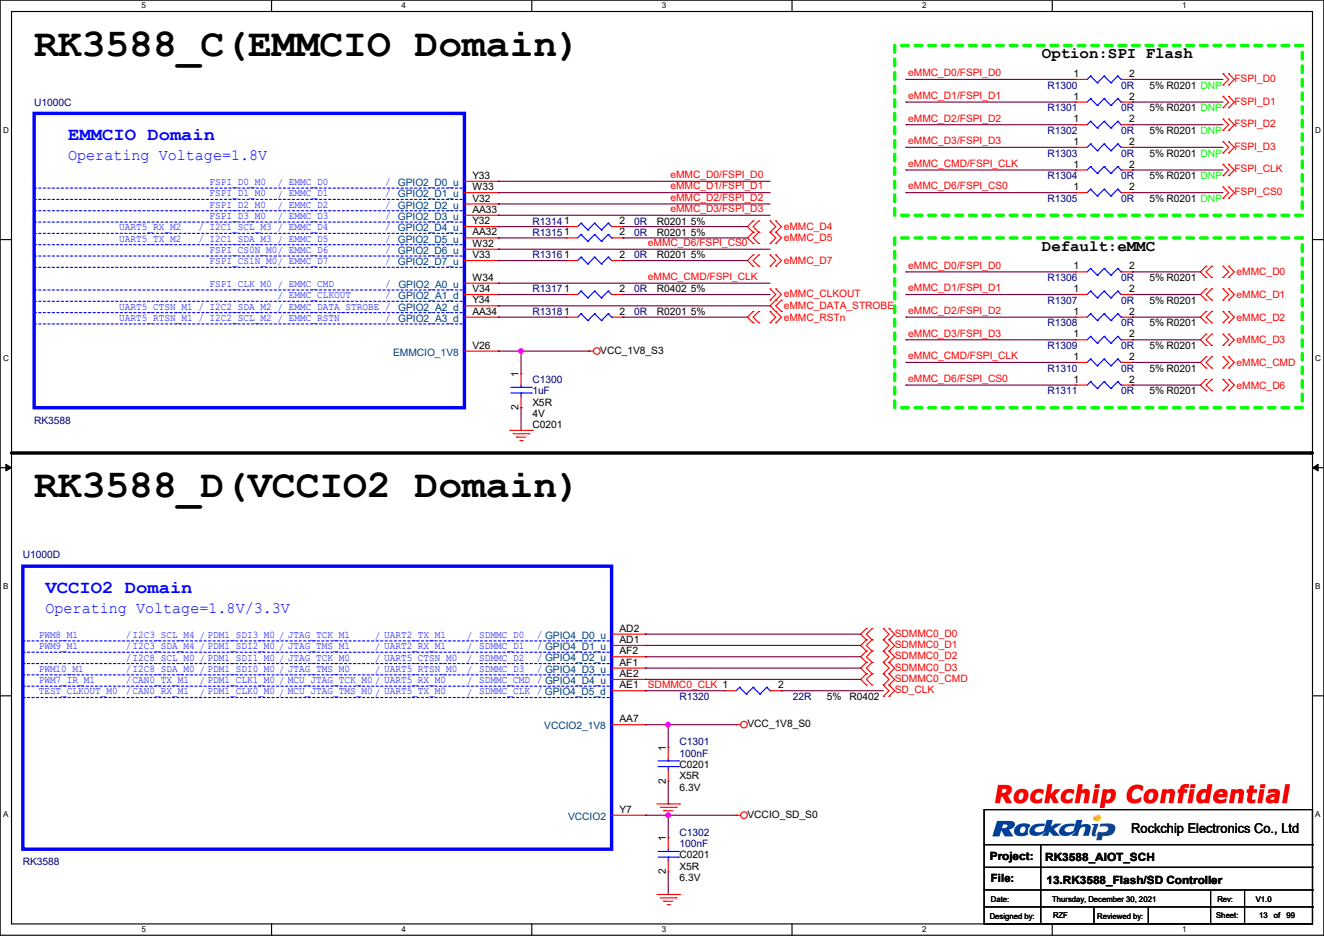
[picture p12: page 12]

RK3588_M(TYPEC/DP) | RK3588_L(USB2.0 HOST/OTG)

## =1.8V For Typec

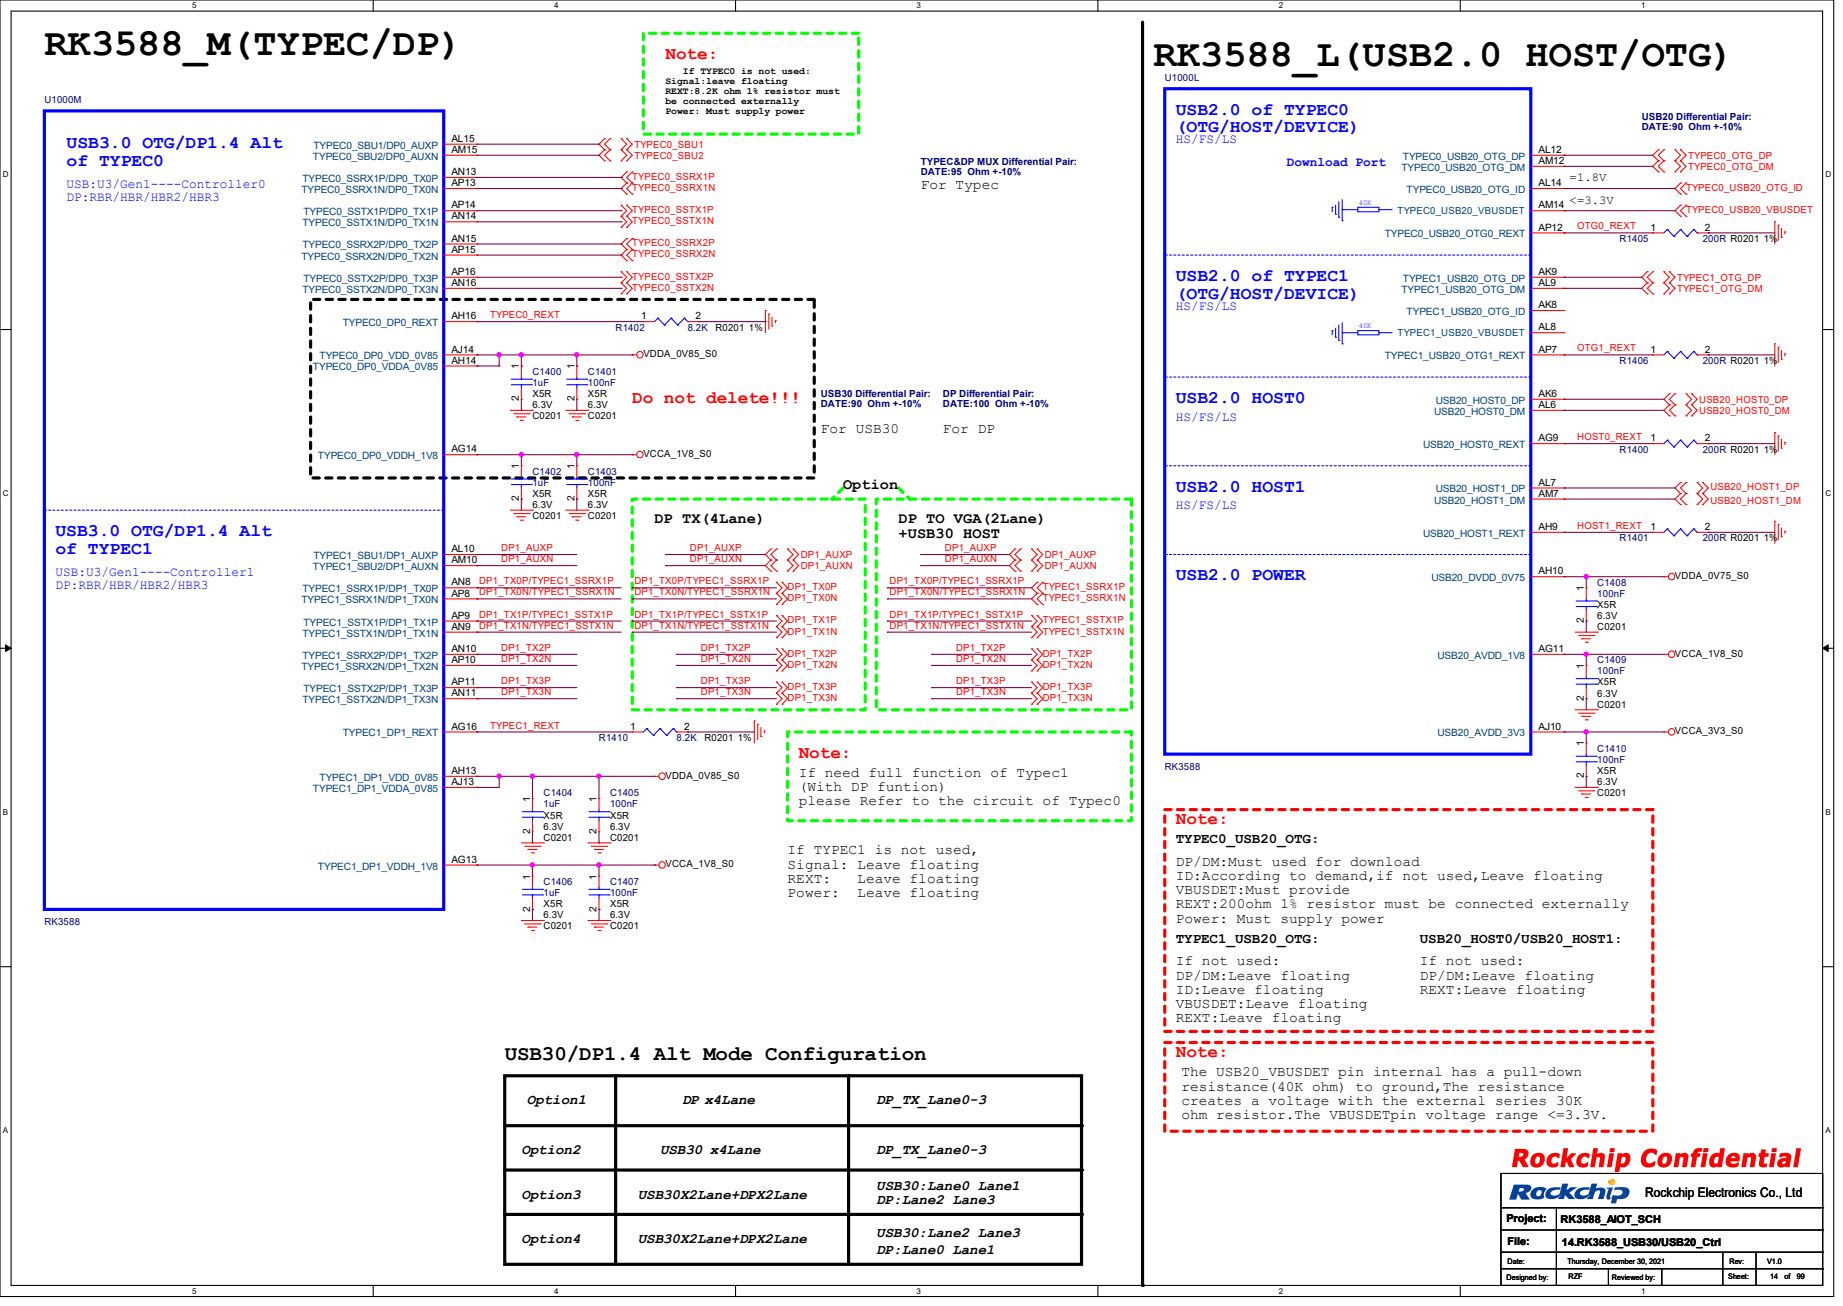
[picture p13: page 13]

If TYPEC0 is not used:
Signal:leave floating
REXT:8.2K ohm 1% resistor must
be connected externally
Power: Must supply power

TYPEC&DP MUX Differential Pair:
DATE:95 Ohm +-10%

DP Differential Pair:
DATE:100 Ohm +-10% For DP

Note:
If need full function of Typec1
(With DP funtion)
please Refer to the circuit of Typec0

TYPEC0_USB20_OTG:
DP/DM:Must used for download
ID:According to demand,if not used,Leave floating
VBUSDET:Must provide
REXT:200ohm 1% resistor must be connected externally
TYPEC1_USB20_OTG: If not used:

If TYPEC1 is not used,
Signal: Leave floating
Power: Leave floating

DP/DM:Leave floating
ID:Leave floating
VBUSDET:Leave floating
REXT:Leave floating
The USB20_VBUSDET pin internal has a pull-down
resistance(40K ohm) to ground,The resistance
creates a voltage with the external series 30K
ohm resistor.The VBUSDETpin voltage range <=3.3V.

RK3588_G(VCCIO1 Domain) | RK3588_U(SARADC/OTP)

## Must floating

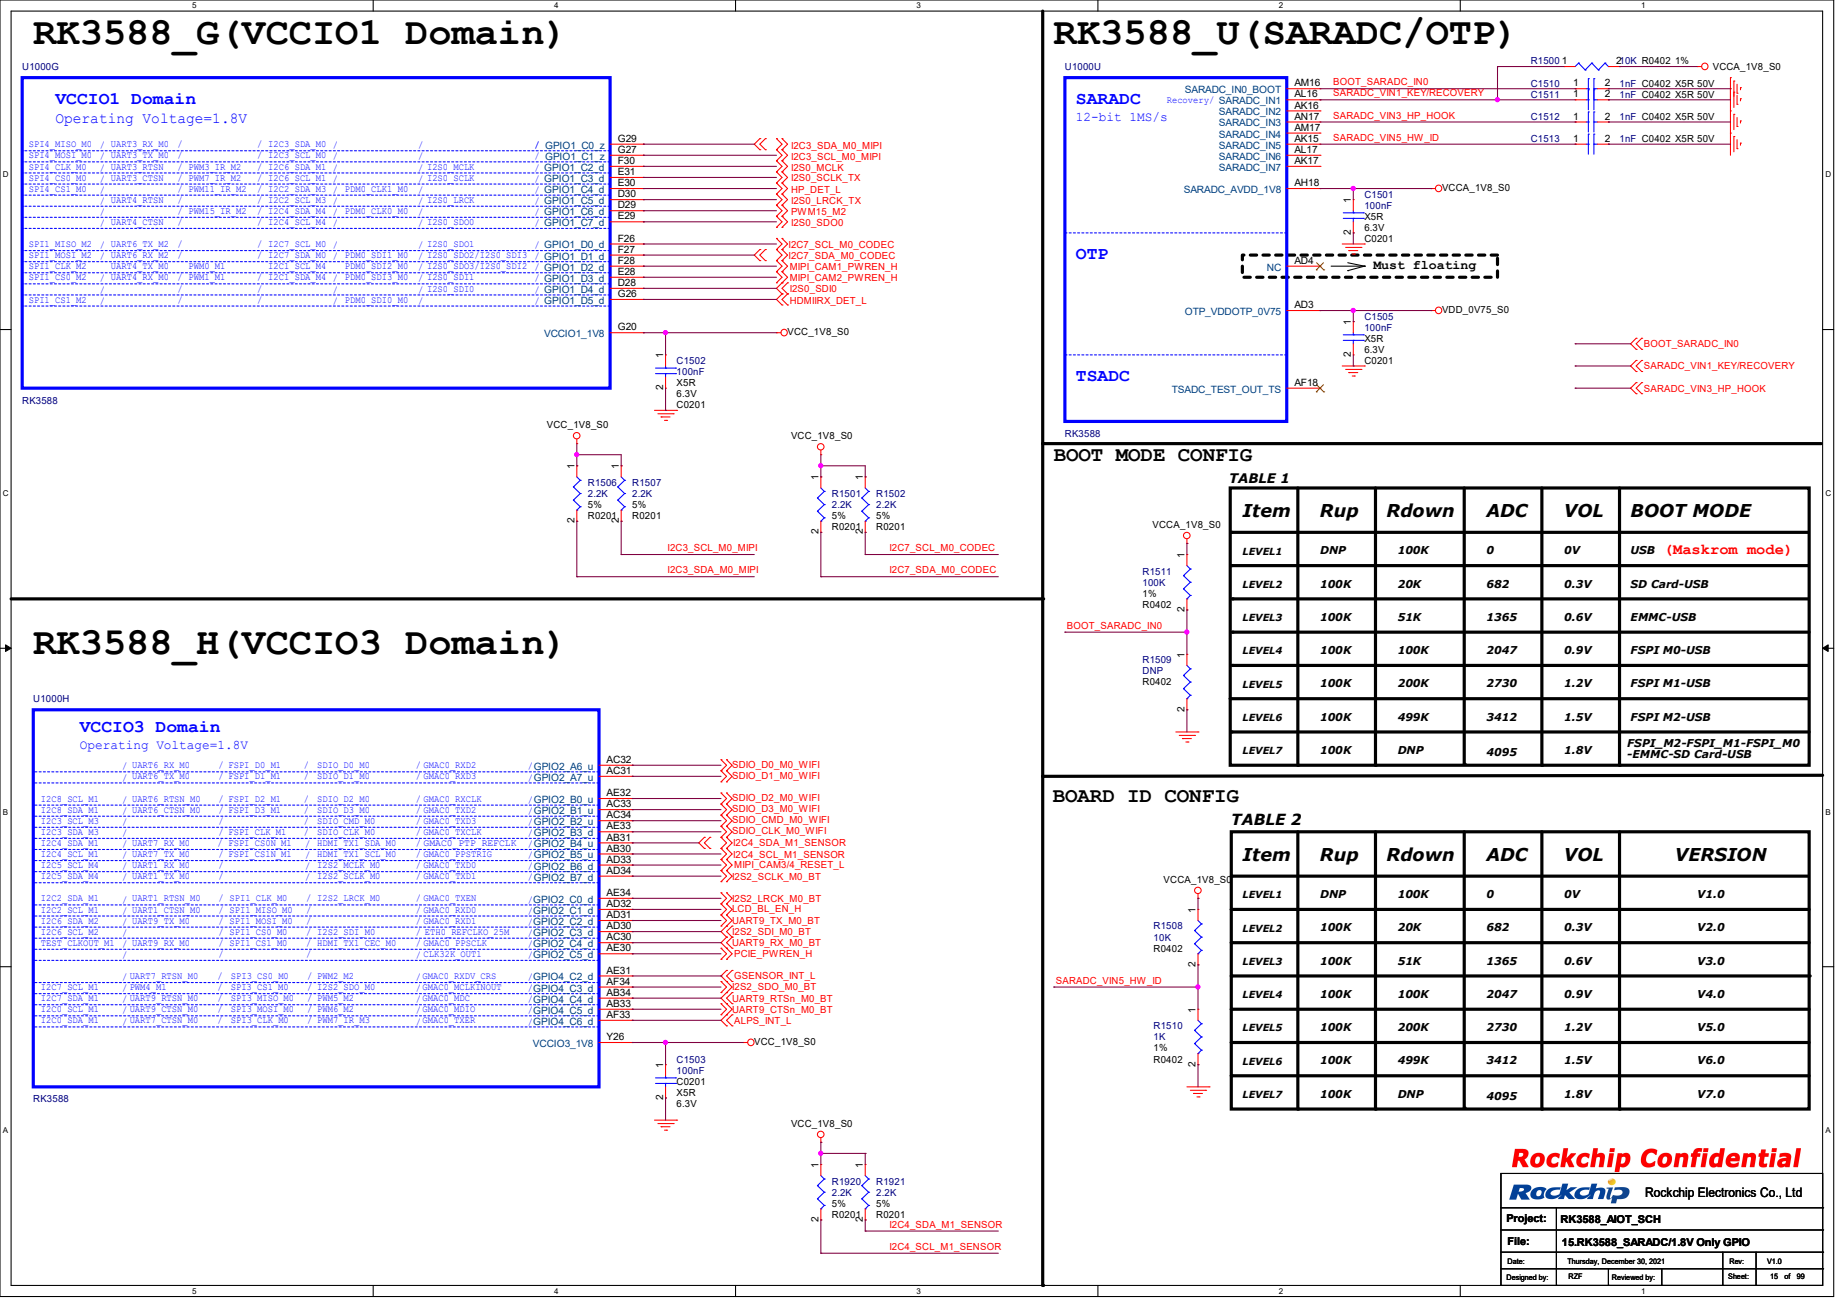
[picture p14: page 14]

FSPI_M2-FSPI_M1-FSPI_M0
-EMMC-SD Card-USB

# RK3588_Q/R(MIPI_D/C_PHY0/1)

## TX and RX port must

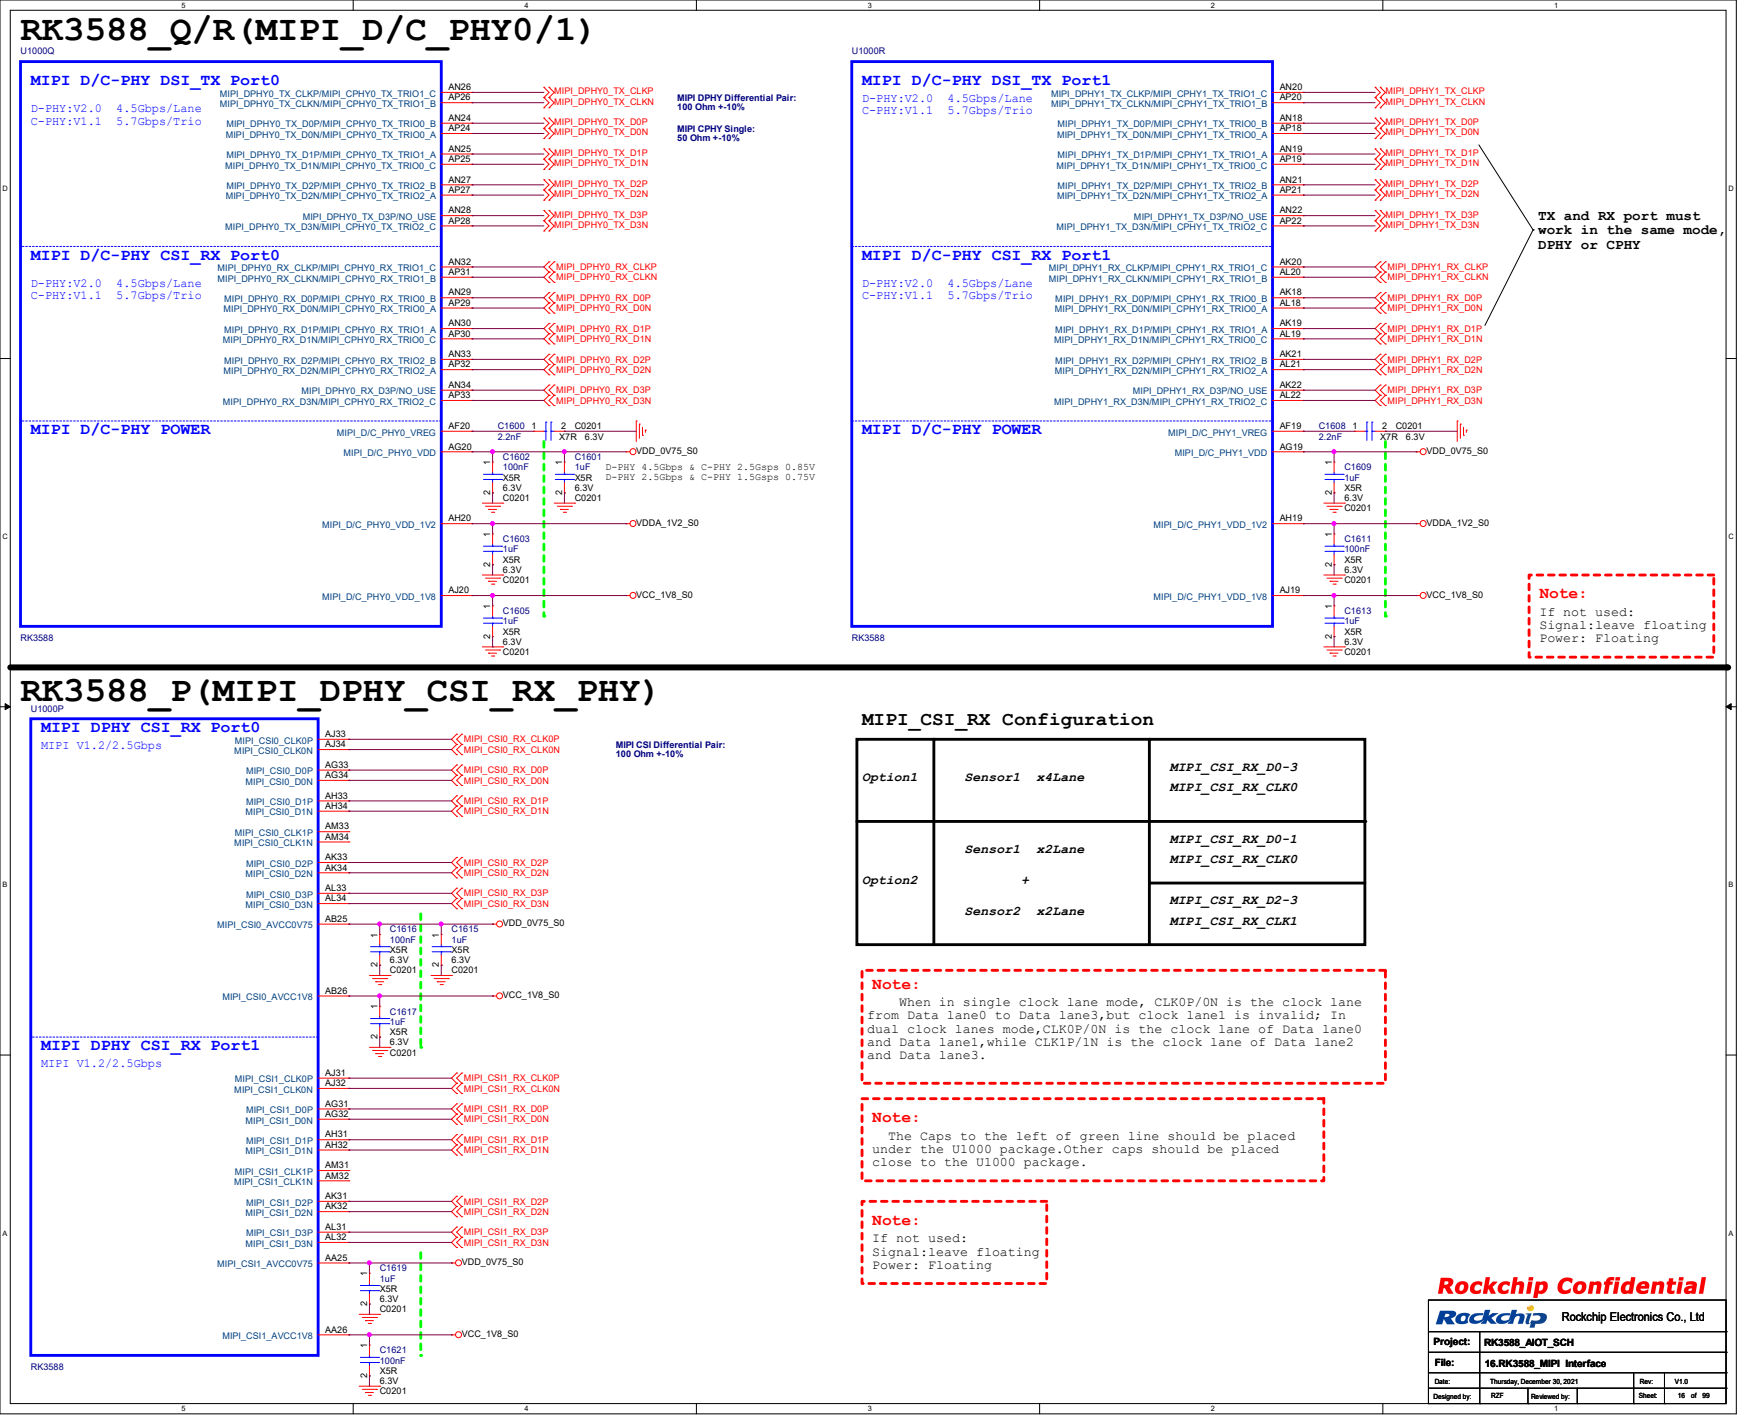
[picture p15: page 15]

MIPI DPHY Differential Pair:
100 Ohm +-10%

work in the same mode,

MIPI CSI Differential Pair:

Note:
When in single clock lane mode, CLK0P/0N is the clock lane
from Data lane0 to Data lane3,but clock lane1 is invalid; In
dual clock lanes mode,CLK0P/0N is the clock lane of Data lane0
and Data lane1,while CLK1P/1N is the clock lane of Data lane2
and Data lane3.

The Caps to the left of green line should be placed
under the U1000 package.Other caps should be placed
close to the U1000 package.

RK3588_S(HDMI2.1 TX) | RK3588_T(HDMI20 RX)

# HDMI20_RX

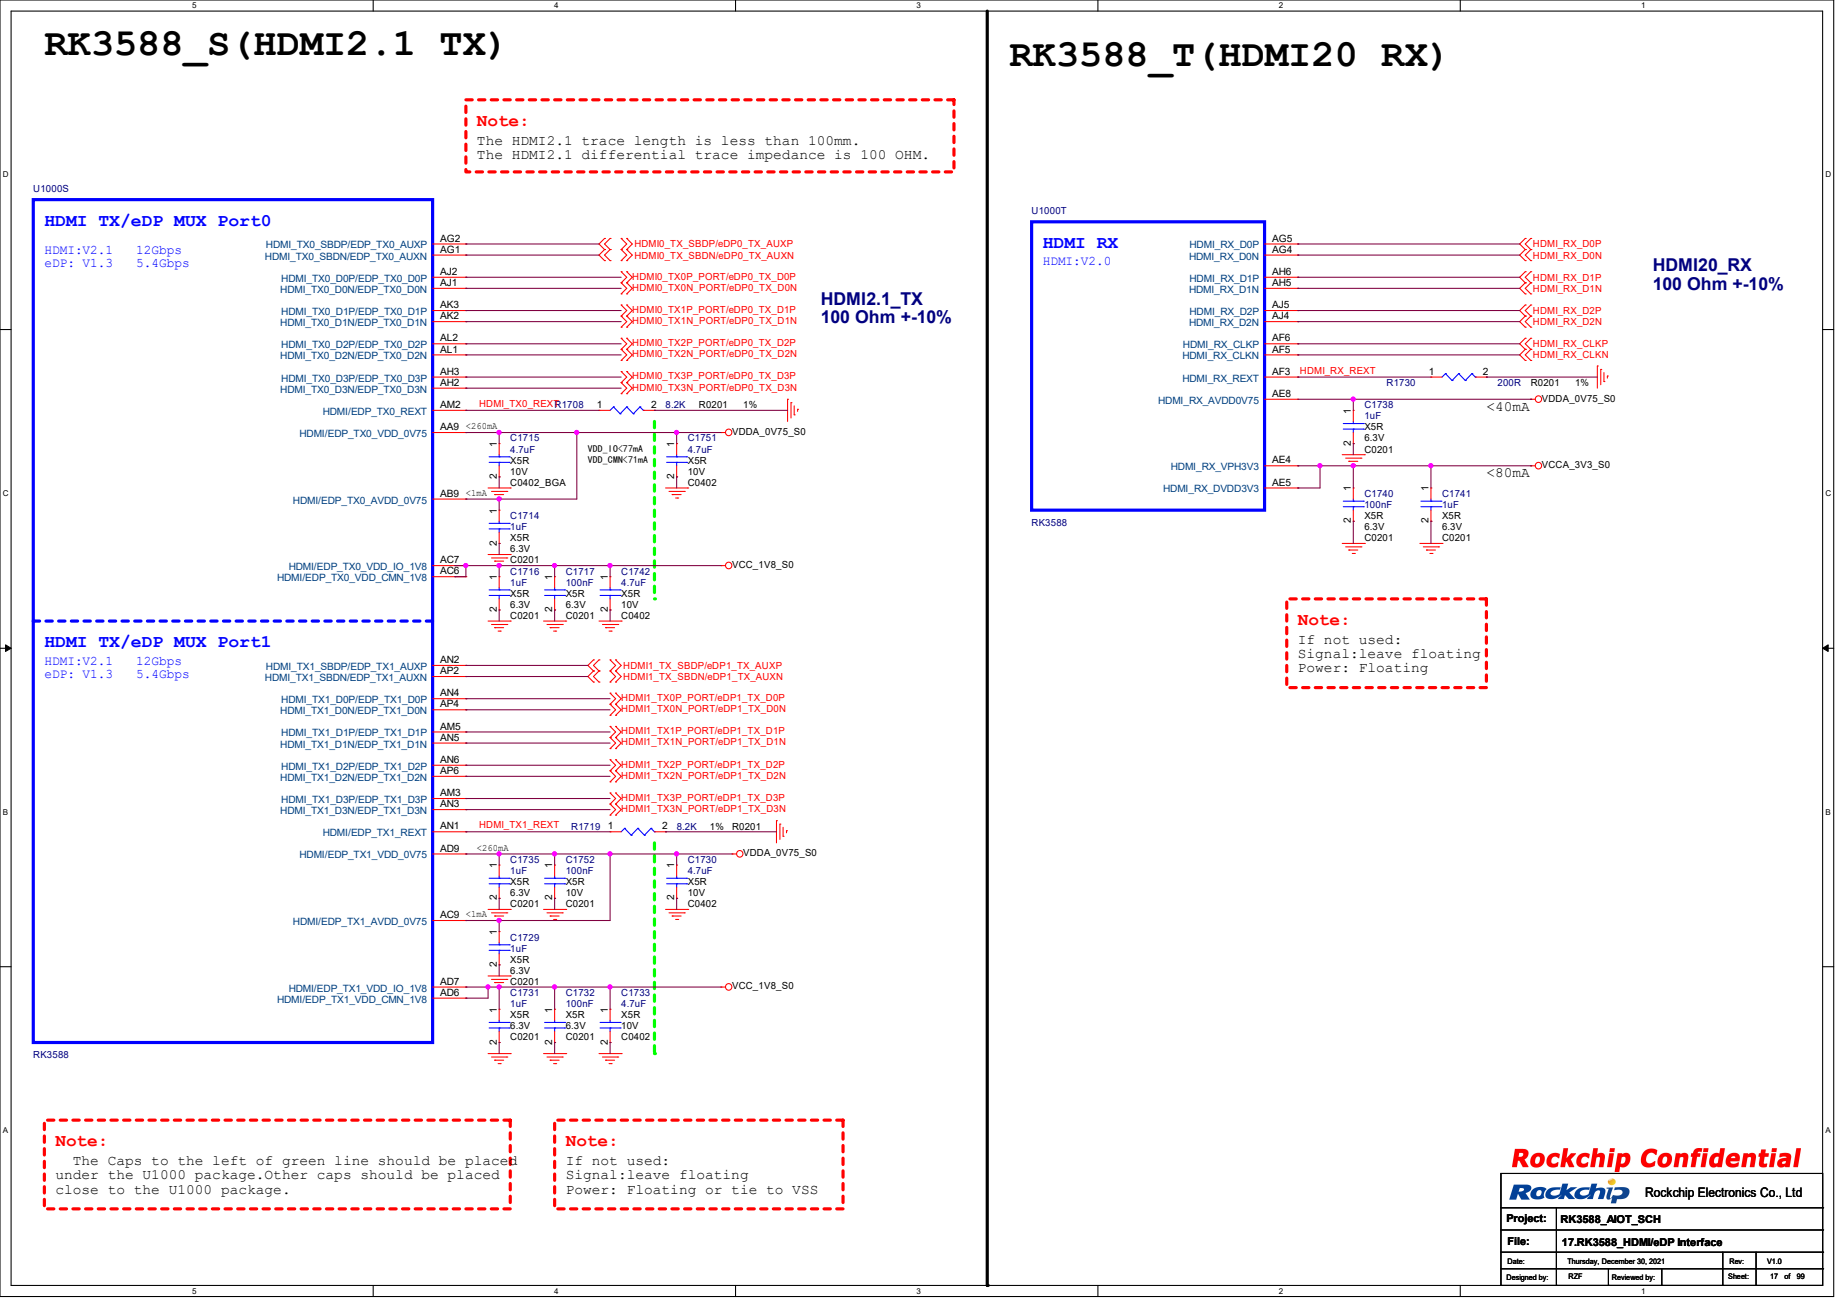
[picture p16: page 16]

The HDMI2.1 trace length is less than 100mm.
The HDMI2.1 differential trace impedance is 100 OHM.

HDMI TX/eDP MUX Port0

HDMI TX/eDP MUX Port1

Note:
The Caps to the left of green line should be placed
under the U1000 package.Other caps should be placed
close to the U1000 package.

If not used:
Signal:leave floating
Power: Floating or tie to VSS

# RK3588_N(PCIE20)

# RK3588_O(PCIE30)

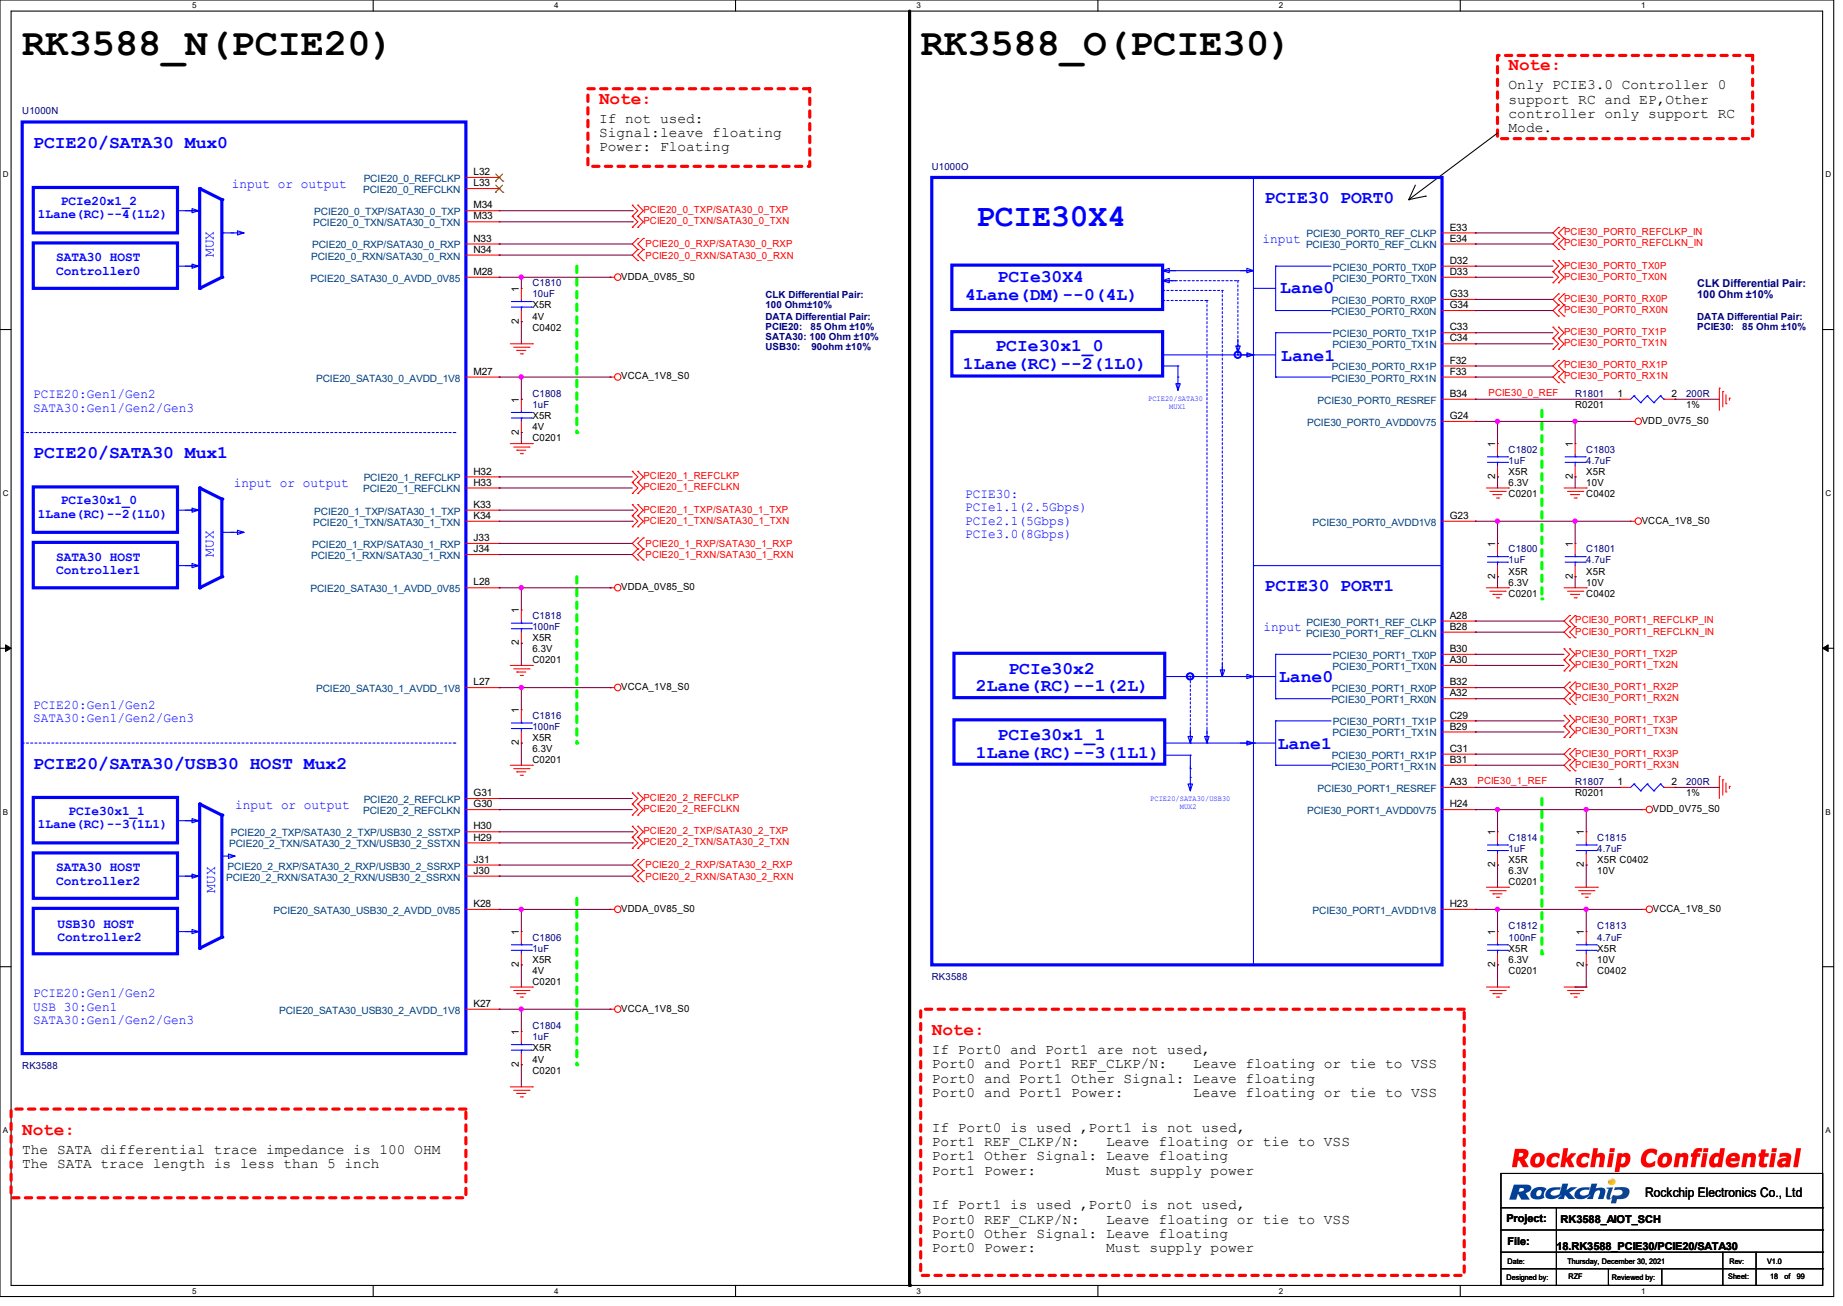
[picture p17: page 17]

Note:
Only PCIE3.0 Controller 0
support RC and EP,Other
controller only support RC
Mode.
PCIE30_PORT0_RESREF B34 PCIE30_PORT1_TX1P C29 PCIE30_PORT1_RX1P C31

If Port0 and Port1 are not used,
Port0 and Port1 Other Signal: Leave floating

The SATA differential trace impedance is 100 OHM
The SATA trace length is less than 5 inch

If Port0 is used ,Port1 is not used,
Port1 Other Signal: Leave floating

If Port1 is used ,Port0 is not used,
Port0 Other Signal: Leave floating

RK3588_J(VCCIO5 Domain) | RK3588_K(VCCIO6 Domain)
GMAC1_TXD0 GMAC1_TXD1 GMAC1_RXD2 GMAC1_RXD3 GMAC1_RXCLK GMAC1_TXCLK GMAC1_TXD2 GMAC1_TXD3 ETH1_REFCLKO_25M

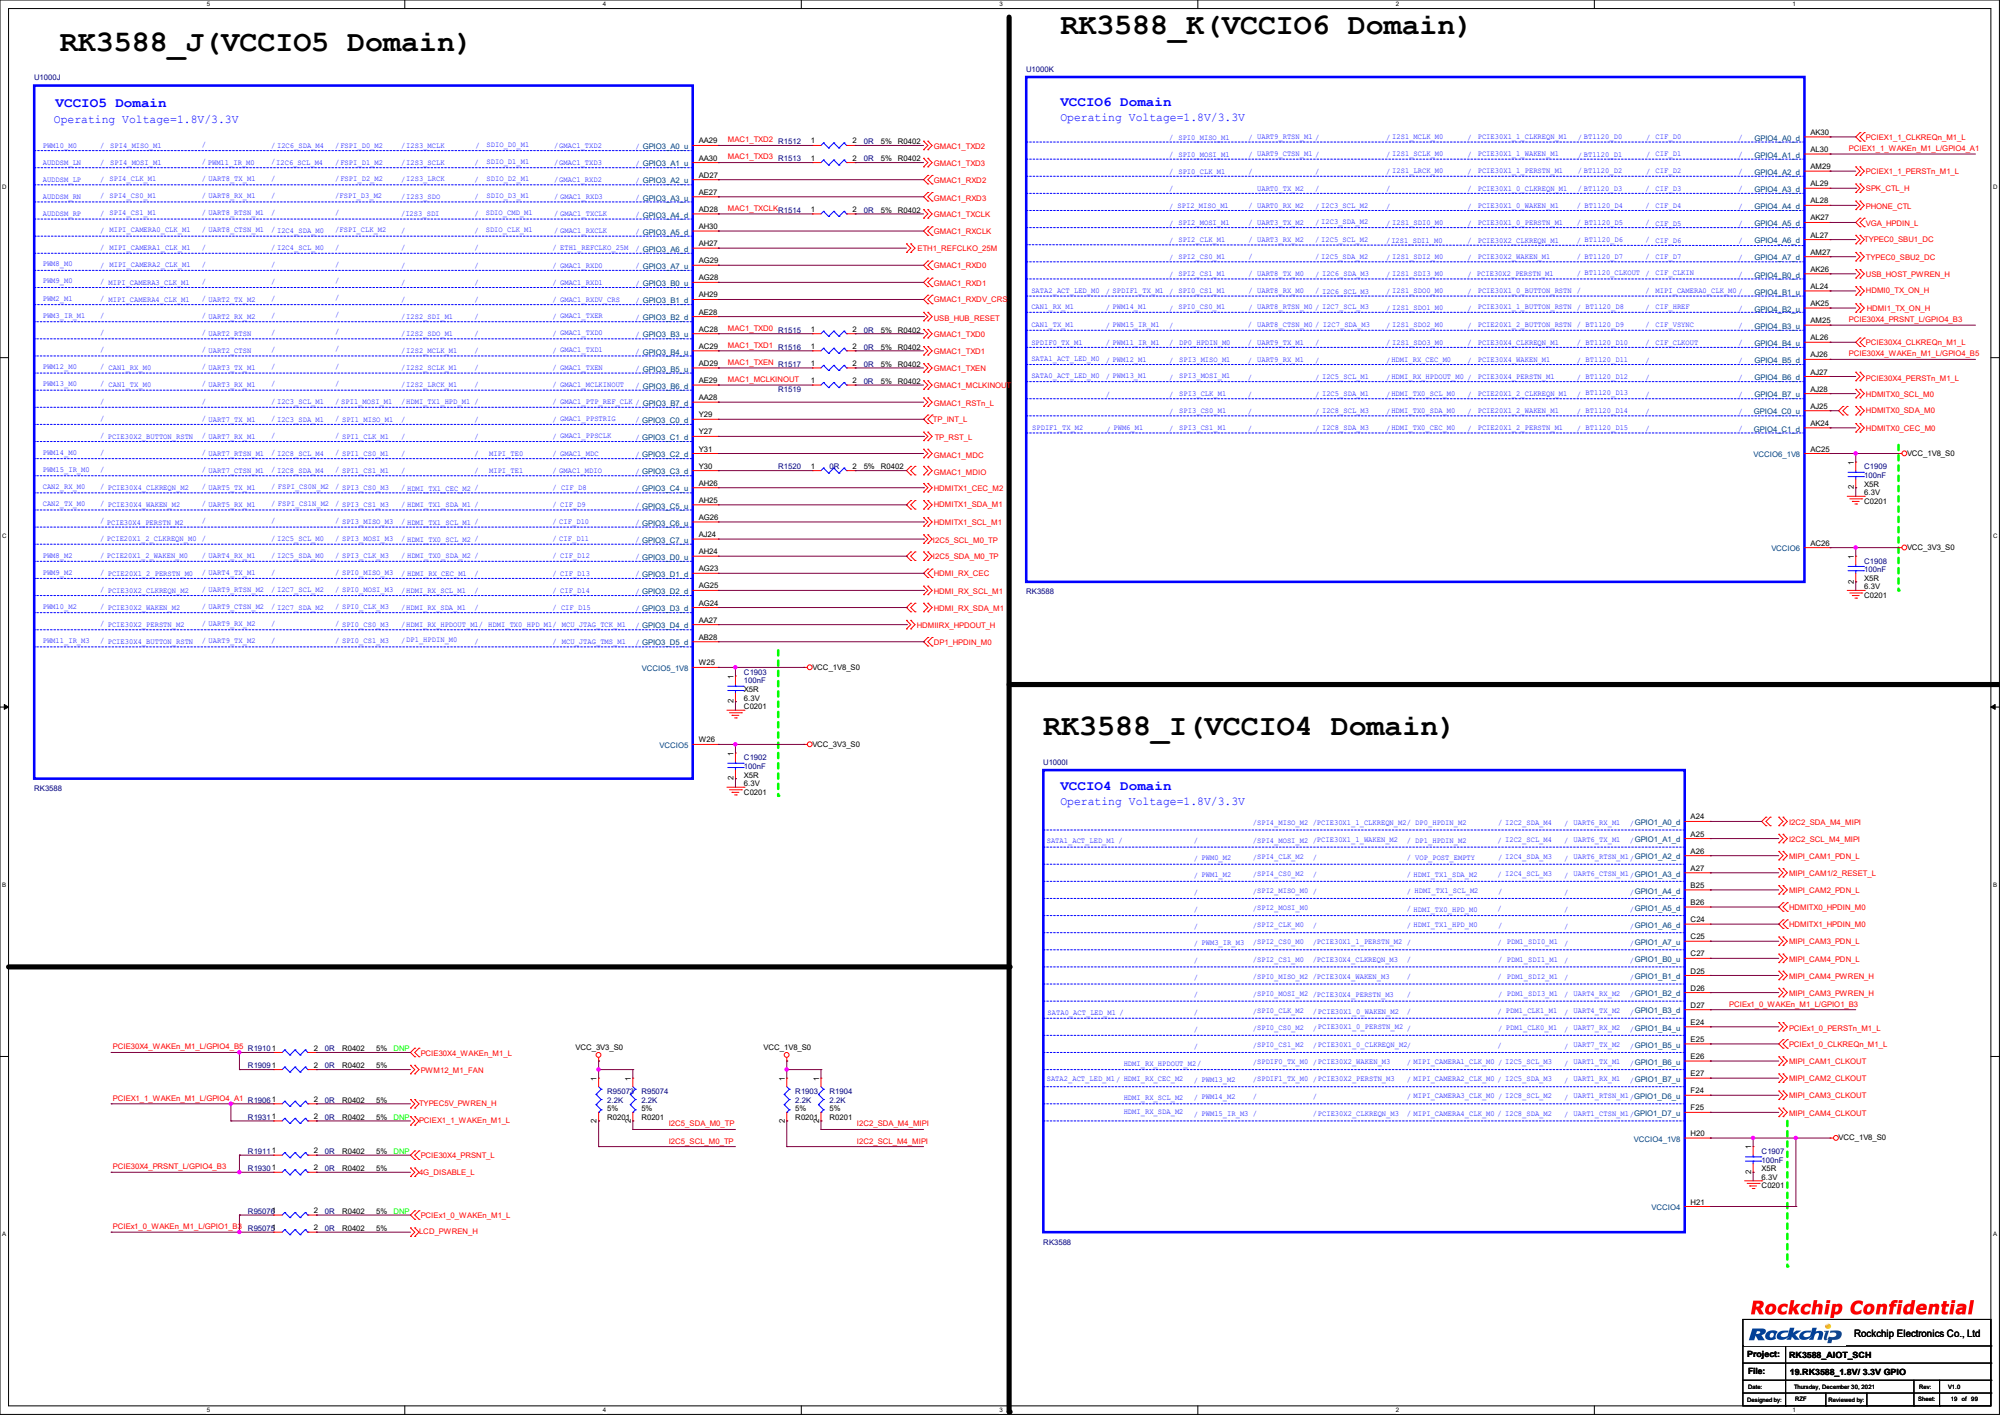
[picture p18: page 18]

# 12V DCIN

## VCC12VDC

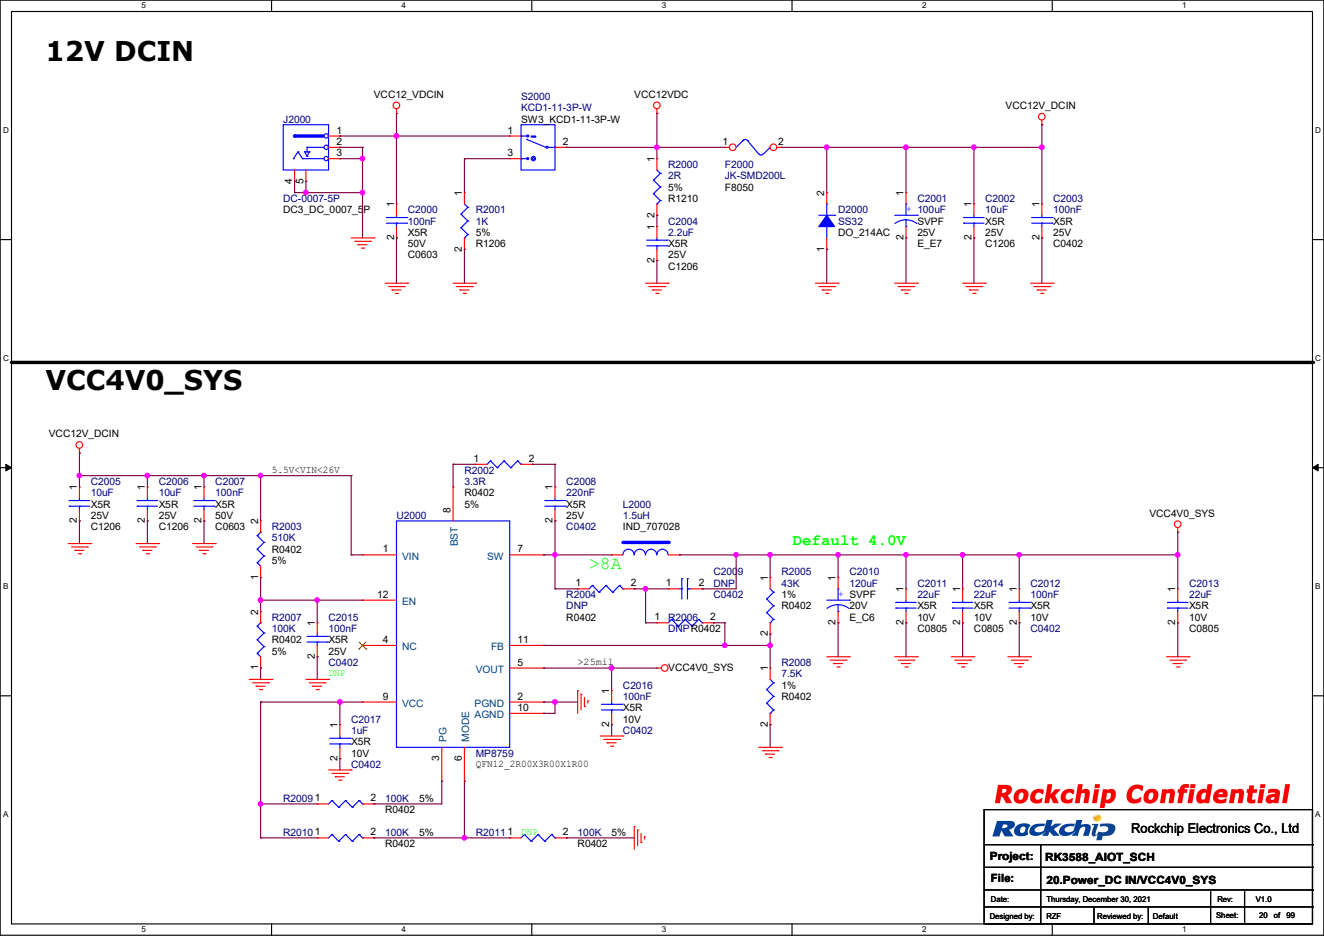
[picture p19: page 19]

# Default 5.2V

# VCC5V0_SYS

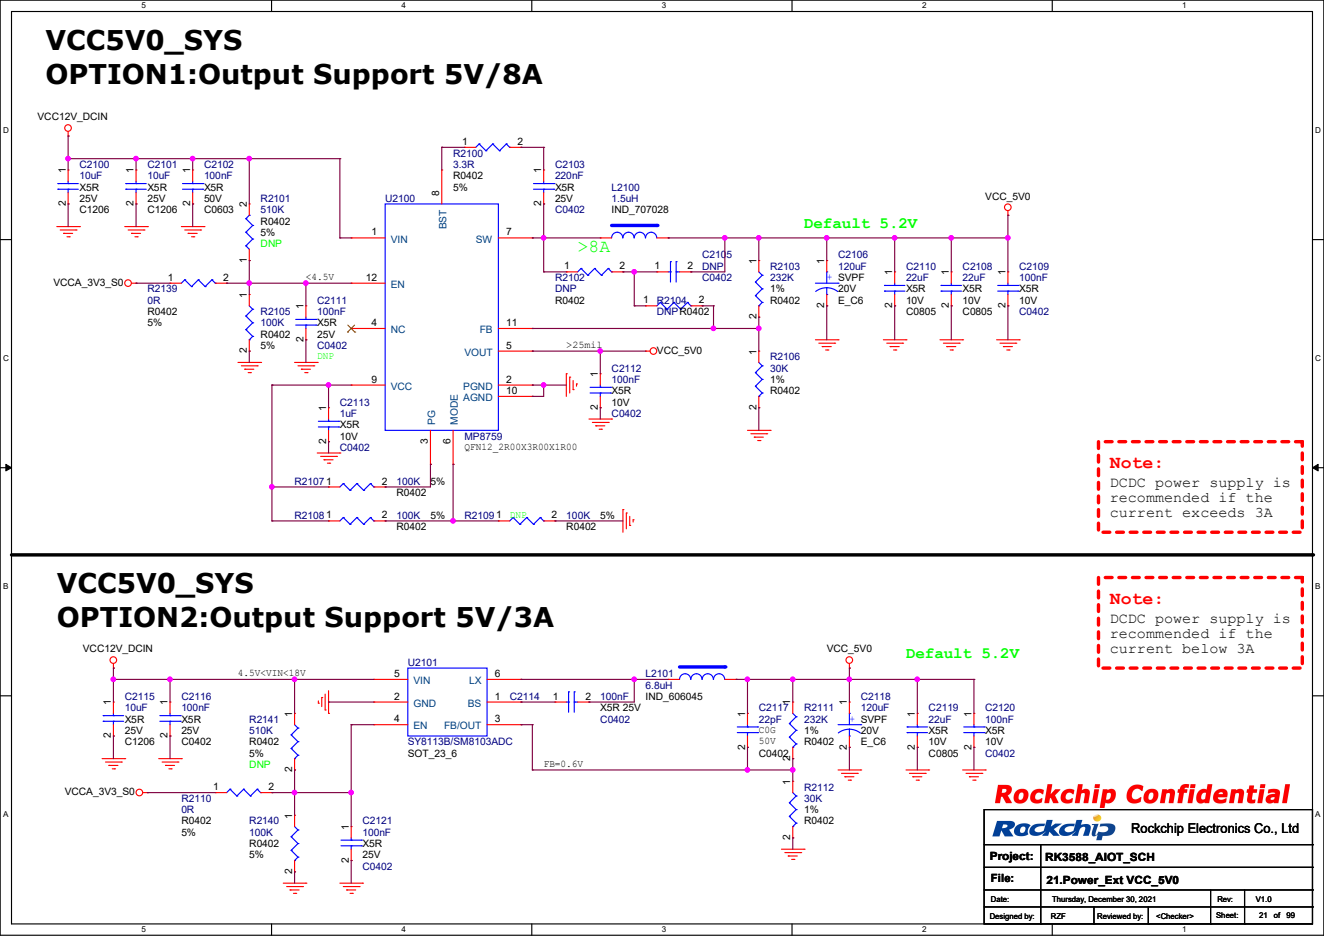
[picture p20: page 20]

Note:
DCDC power supply is
recommended if the
current exceeds 3A

current below 3A

# PMIC RK806-1 BUCK

# Low frequency:0.85V-->0.75V ¹⁰⁰R RK3588

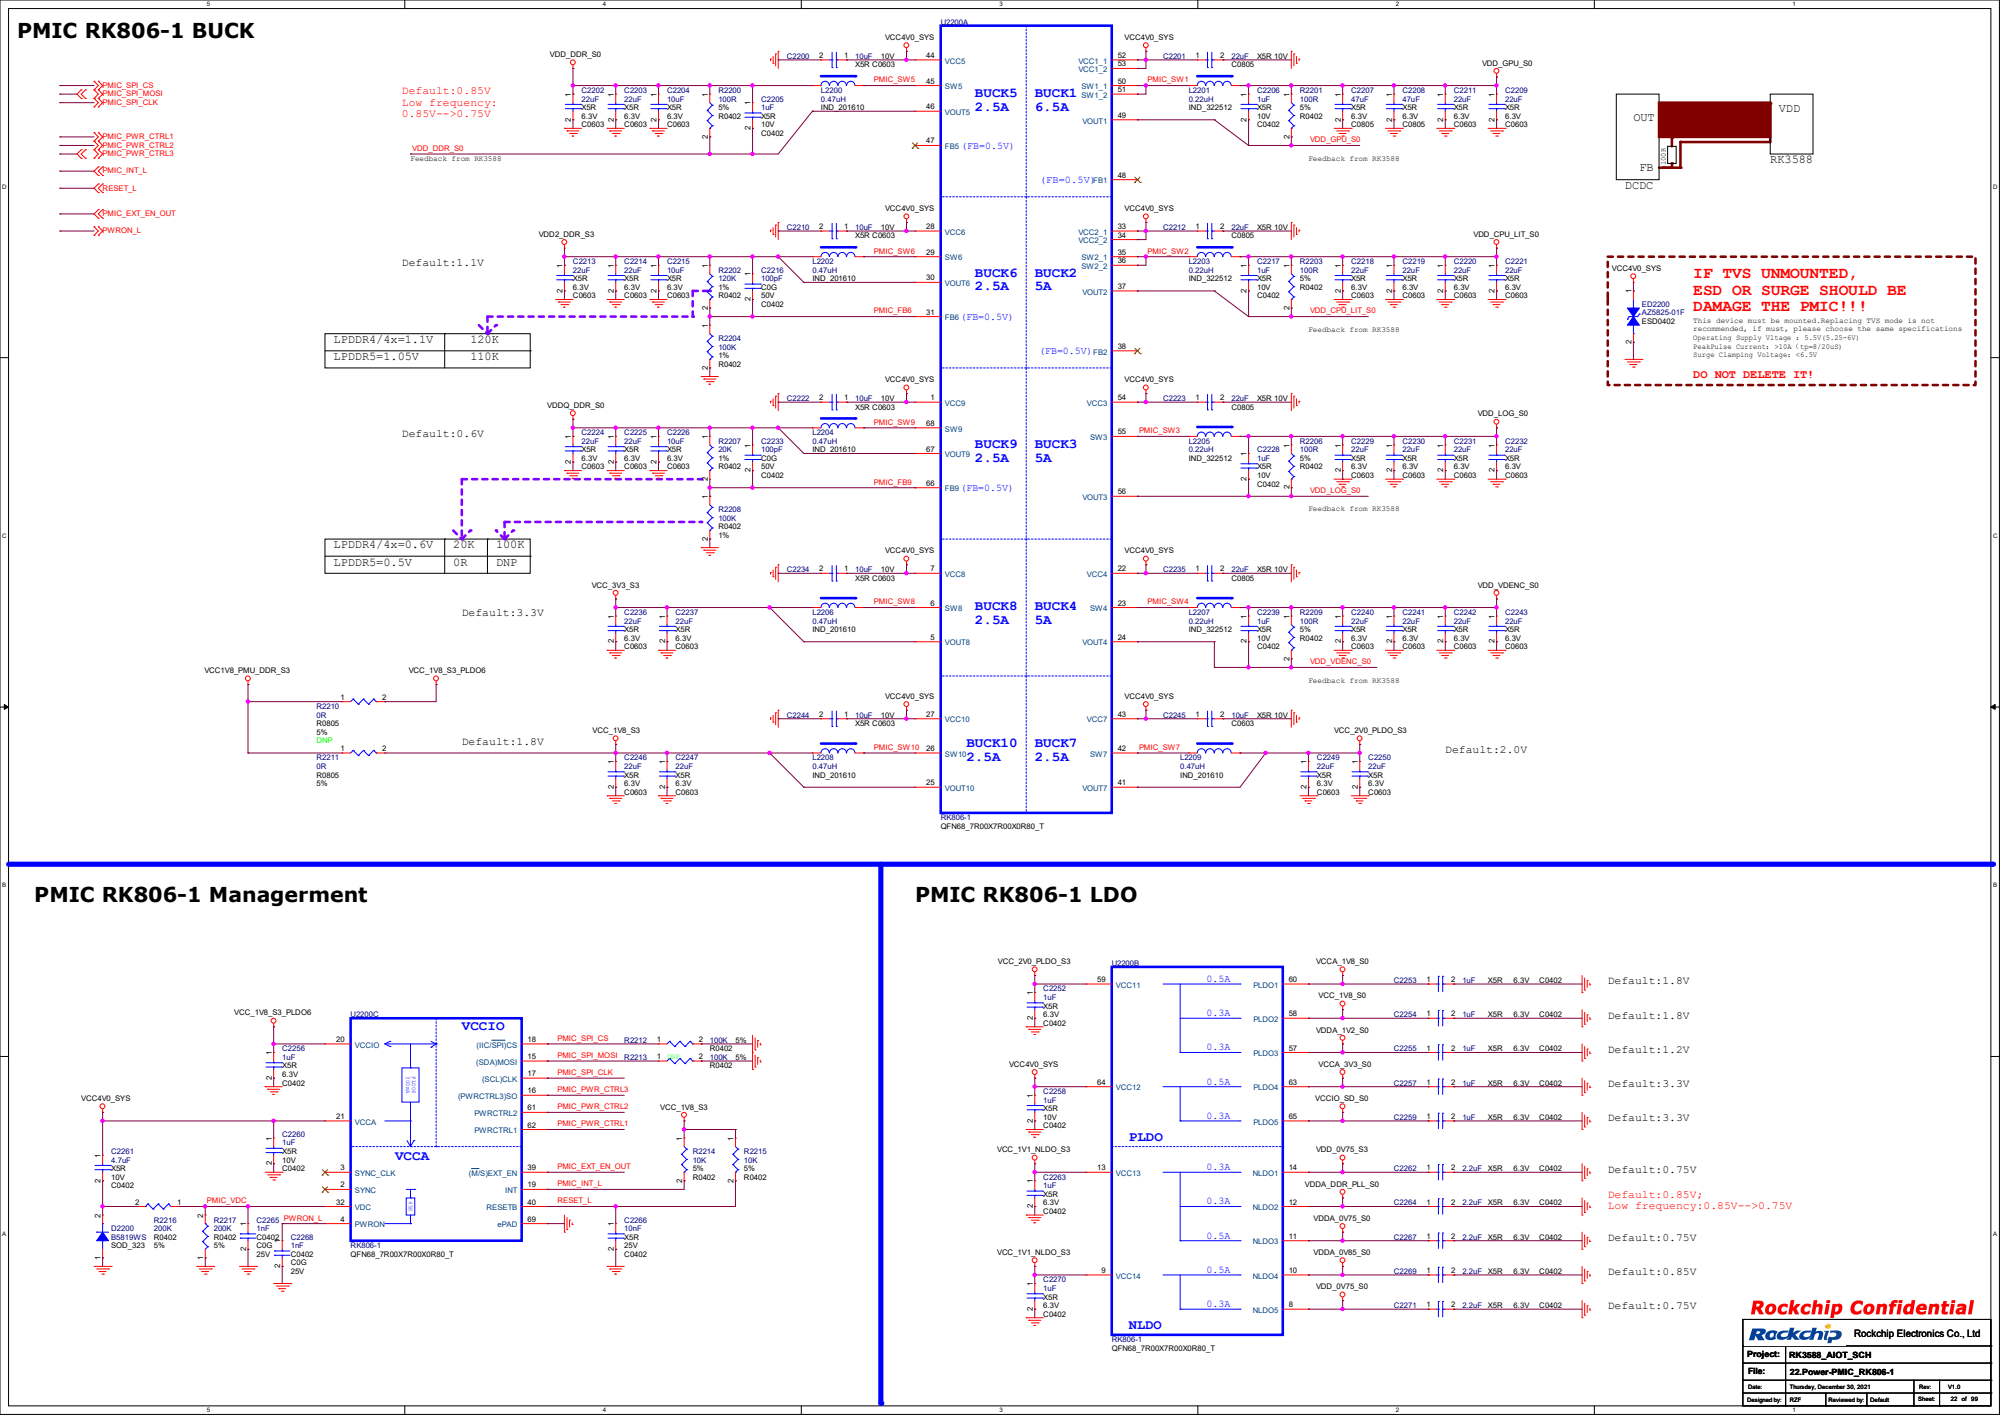
[picture p21: page 21]

IF TVS UNMOUNTED,
ESD OR SURGE SHOULD BE
DAMAGE THE PMIC!!!

This device must be mounted.Replacing TVS mode is not
recommended, if must, please choose the same specifications

DO NOT DELETE IT! VCC_3V3_S3

## Feedback from RK3588

VDD_CPU_BIG1 100R | RK3588

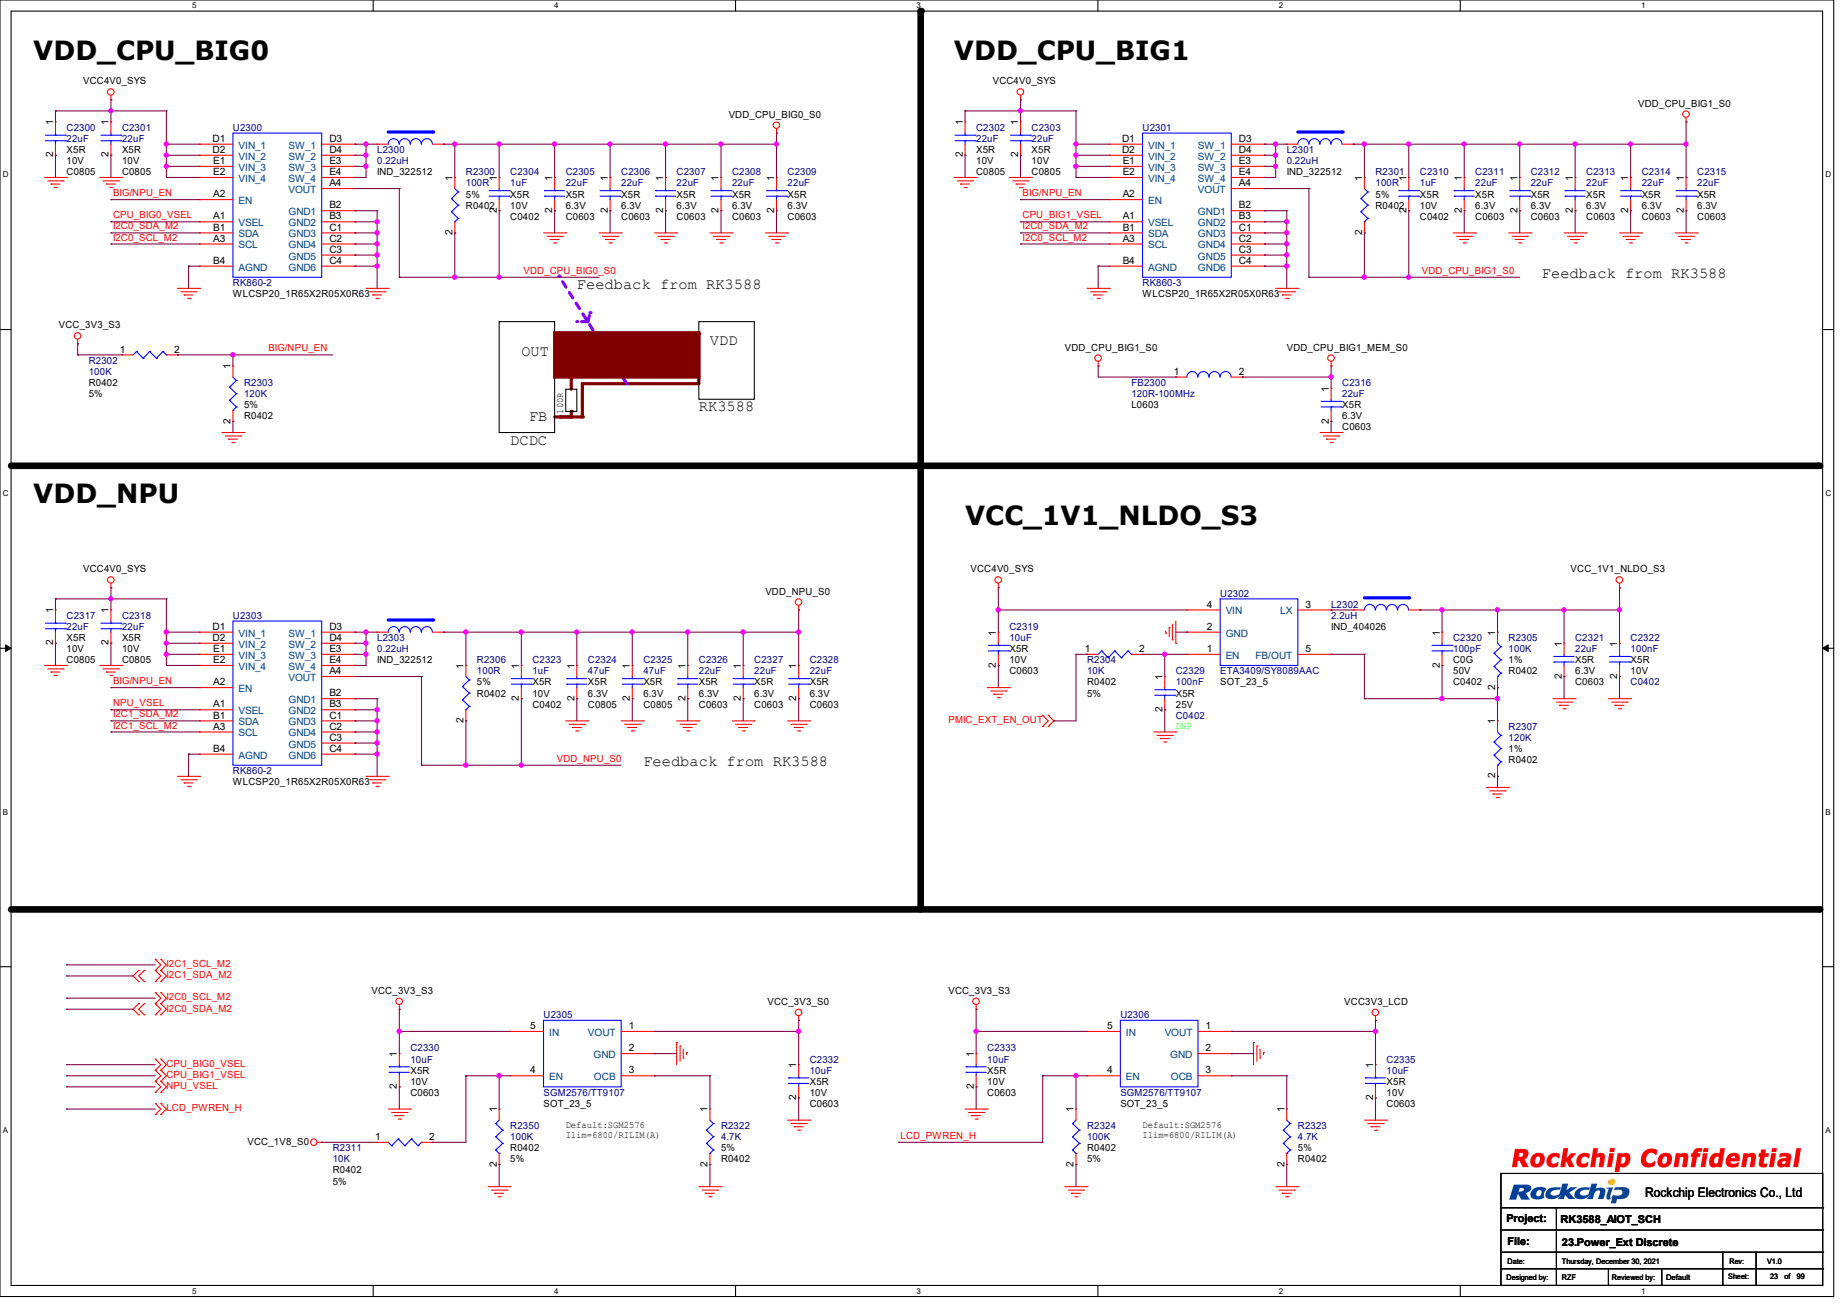
[picture p22: page 22]

1 2 U2300 RK860-2 WLCSP20_1R65X2R05X0R63 VIN_1 D1 VIN_2 D2 VIN_3 E1 VIN_4 E2 SW_1 D3 SW_2 D4 SW_3 E3 SW_4 E4 GND1 B2 GND2 B3 GND3 C1 GND4 C2 GND5 C3 GND6 C4 VSEL A1 EN A2 SDA B1 AGND B4 SCL A3 VOUT A4

U2305 SGM2576/TT9107 SOT_23_5 OCB 3 GND 2 VOUT 1 EN 4

U2306 SGM2576/TT9107 SOT_23_5 OCB 3 GND 2 VOUT 1 EN 4

# RTC IC

## VCC_RTC

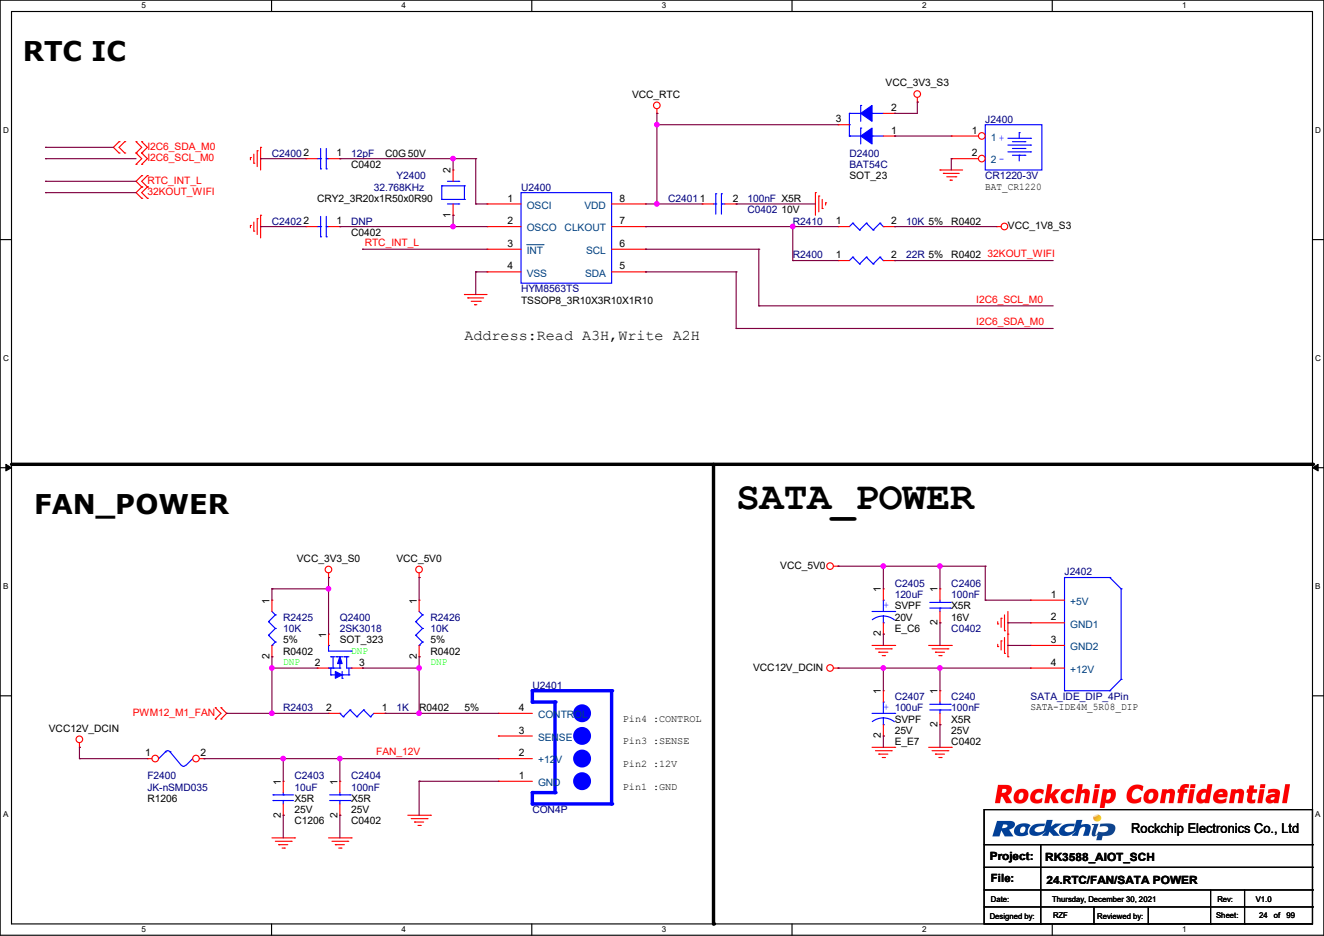
[picture p23: page 23]

RK3588_AIOT_SCH
24.RTC/FAN/SATA POWER

# USB2.0 HOST PORT

# VCC5V0_USB20_HOST VCC5V0_USB20_HOST

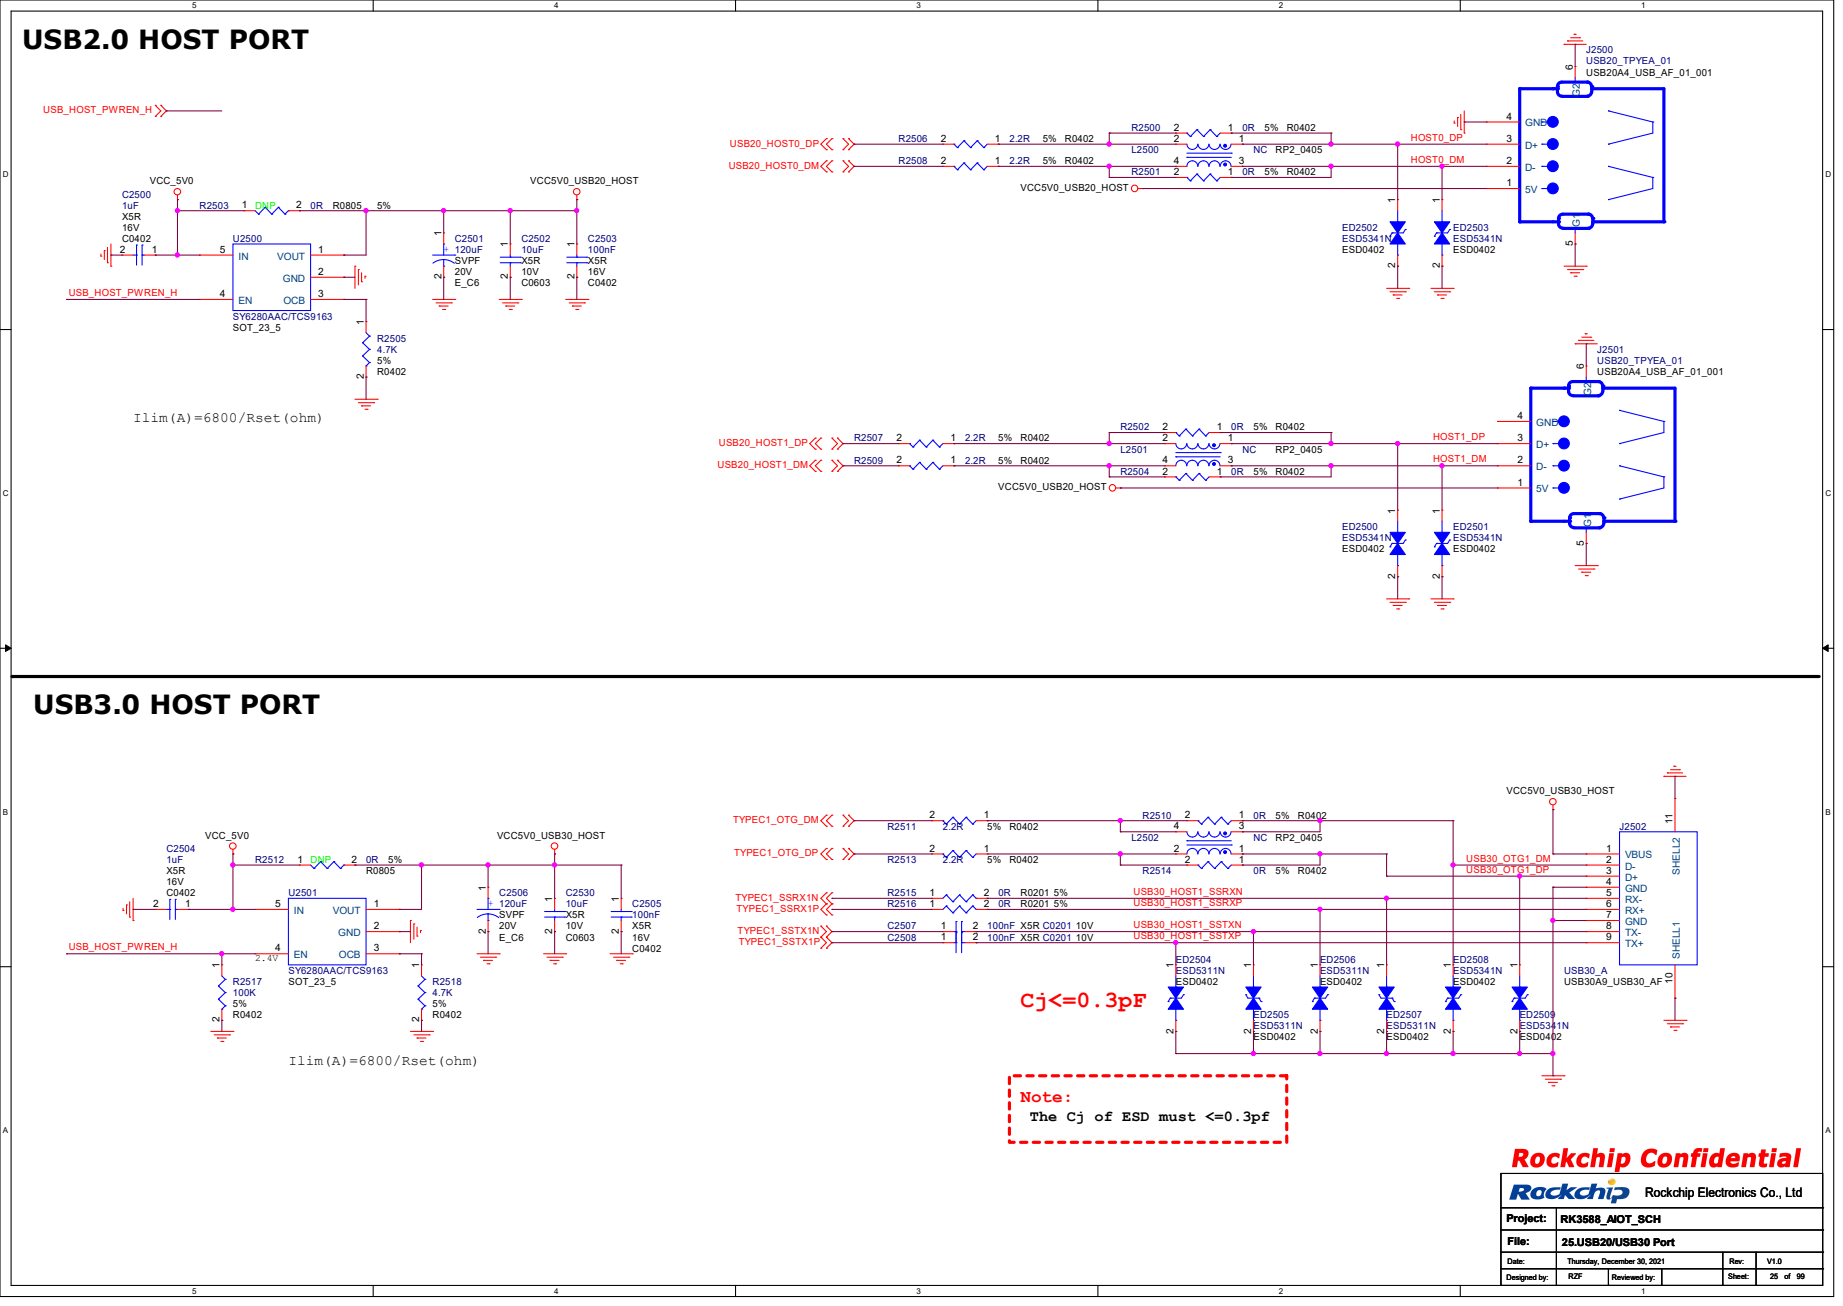
[picture p24: page 24]

U2500 SY6280AAC/TCS9163 SOT_23_5 OCB 3 GND 2 VOUT 1 EN 4

2 1 U2501 SY6280AAC/TCS9163 SOT_23_5 OCB 3 GND 2 VOUT 1 EN 4

Note:
The Cj of ESD must <=0.3pf

# Type-C PORT

## VBUS5V0_TYPEC

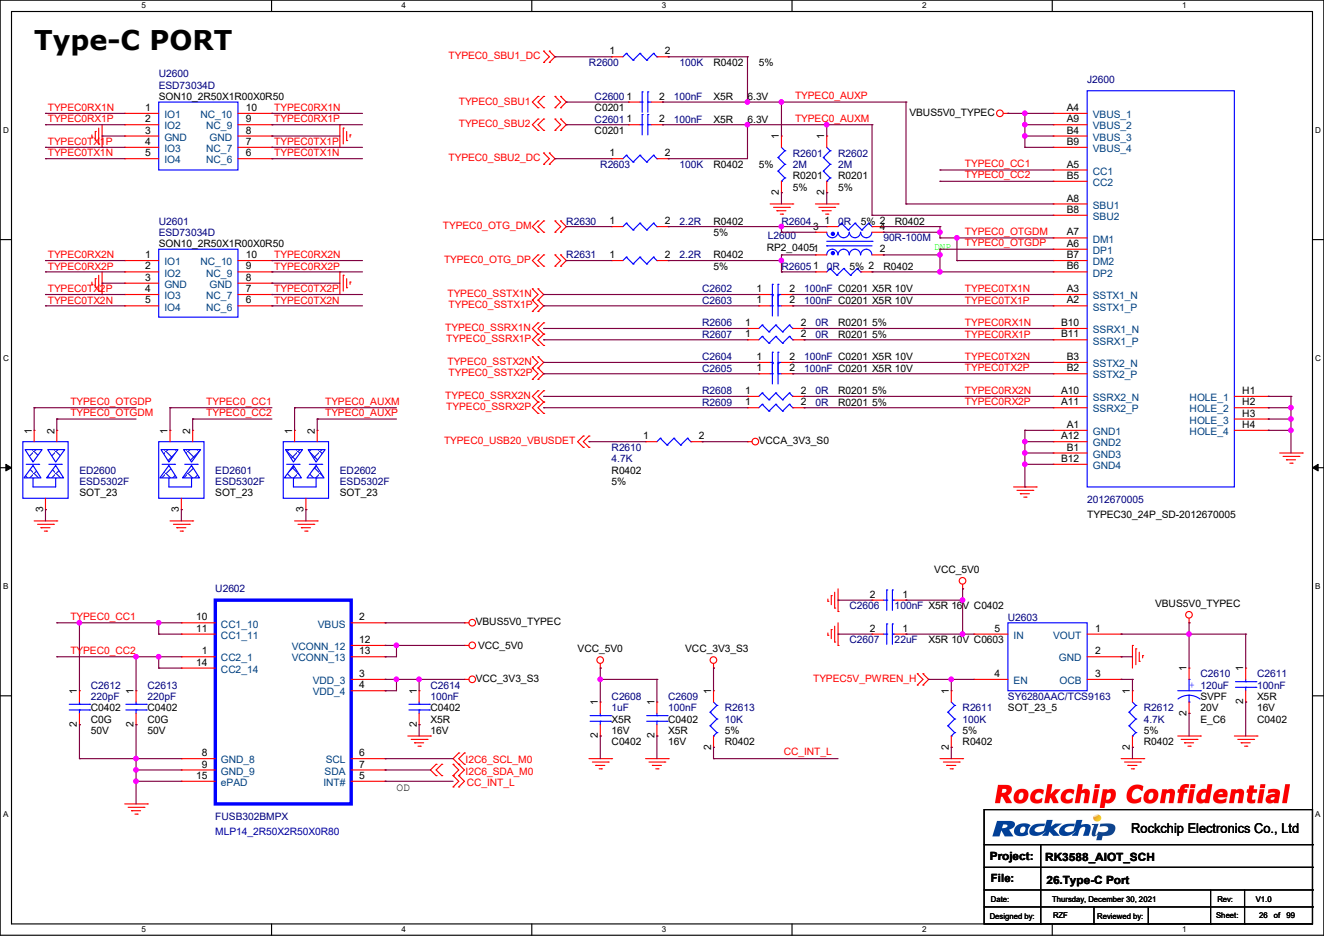
[picture p25: page 25]

USB2.0 Micro Port | USB Detection

## VBUS5V0_USB20OTG

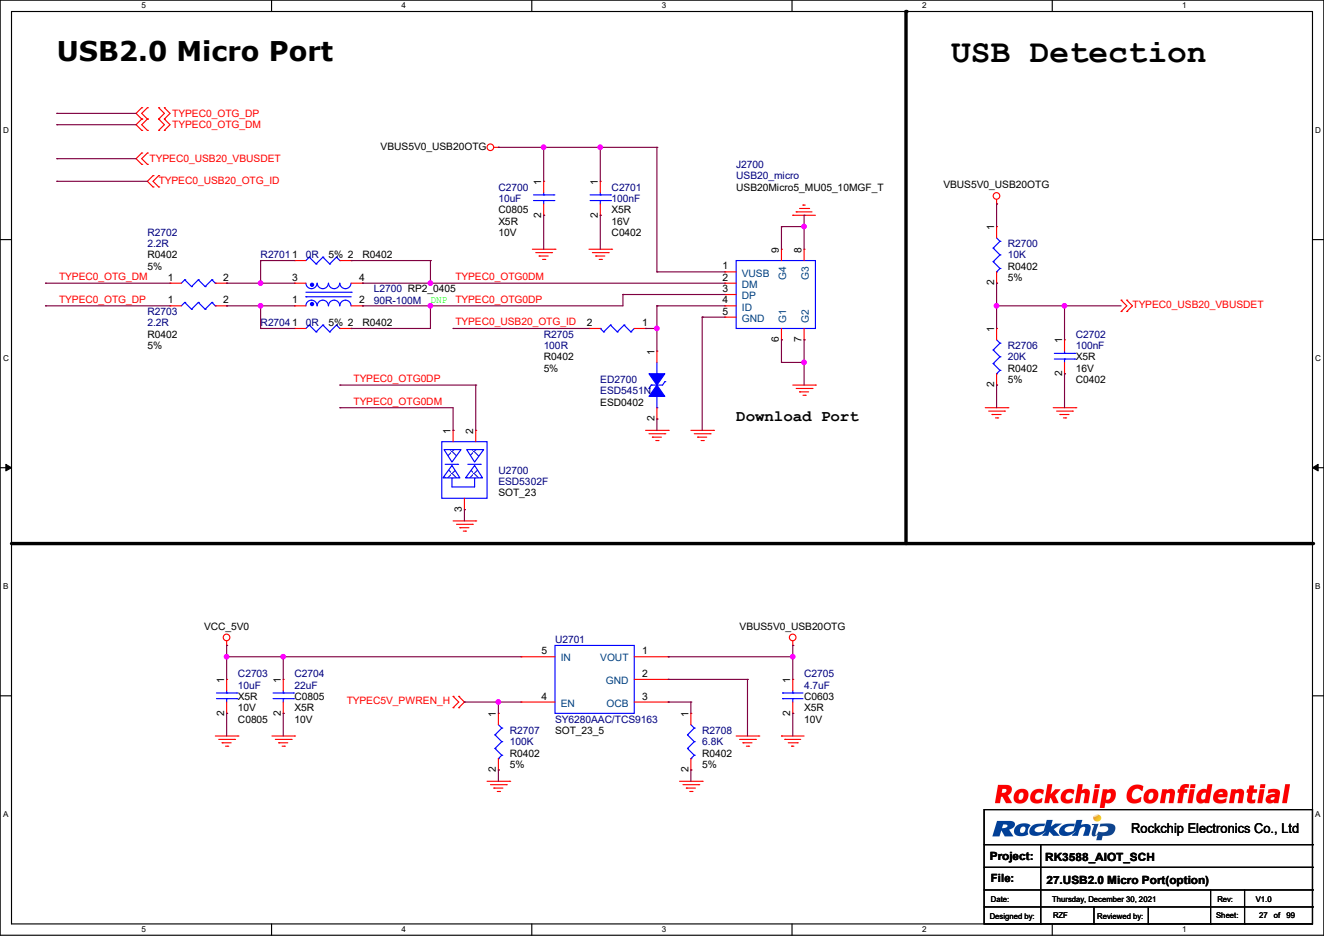
[picture p26: page 26]

## PSELF:BUS-Powered

## PGANG:Gang Mode

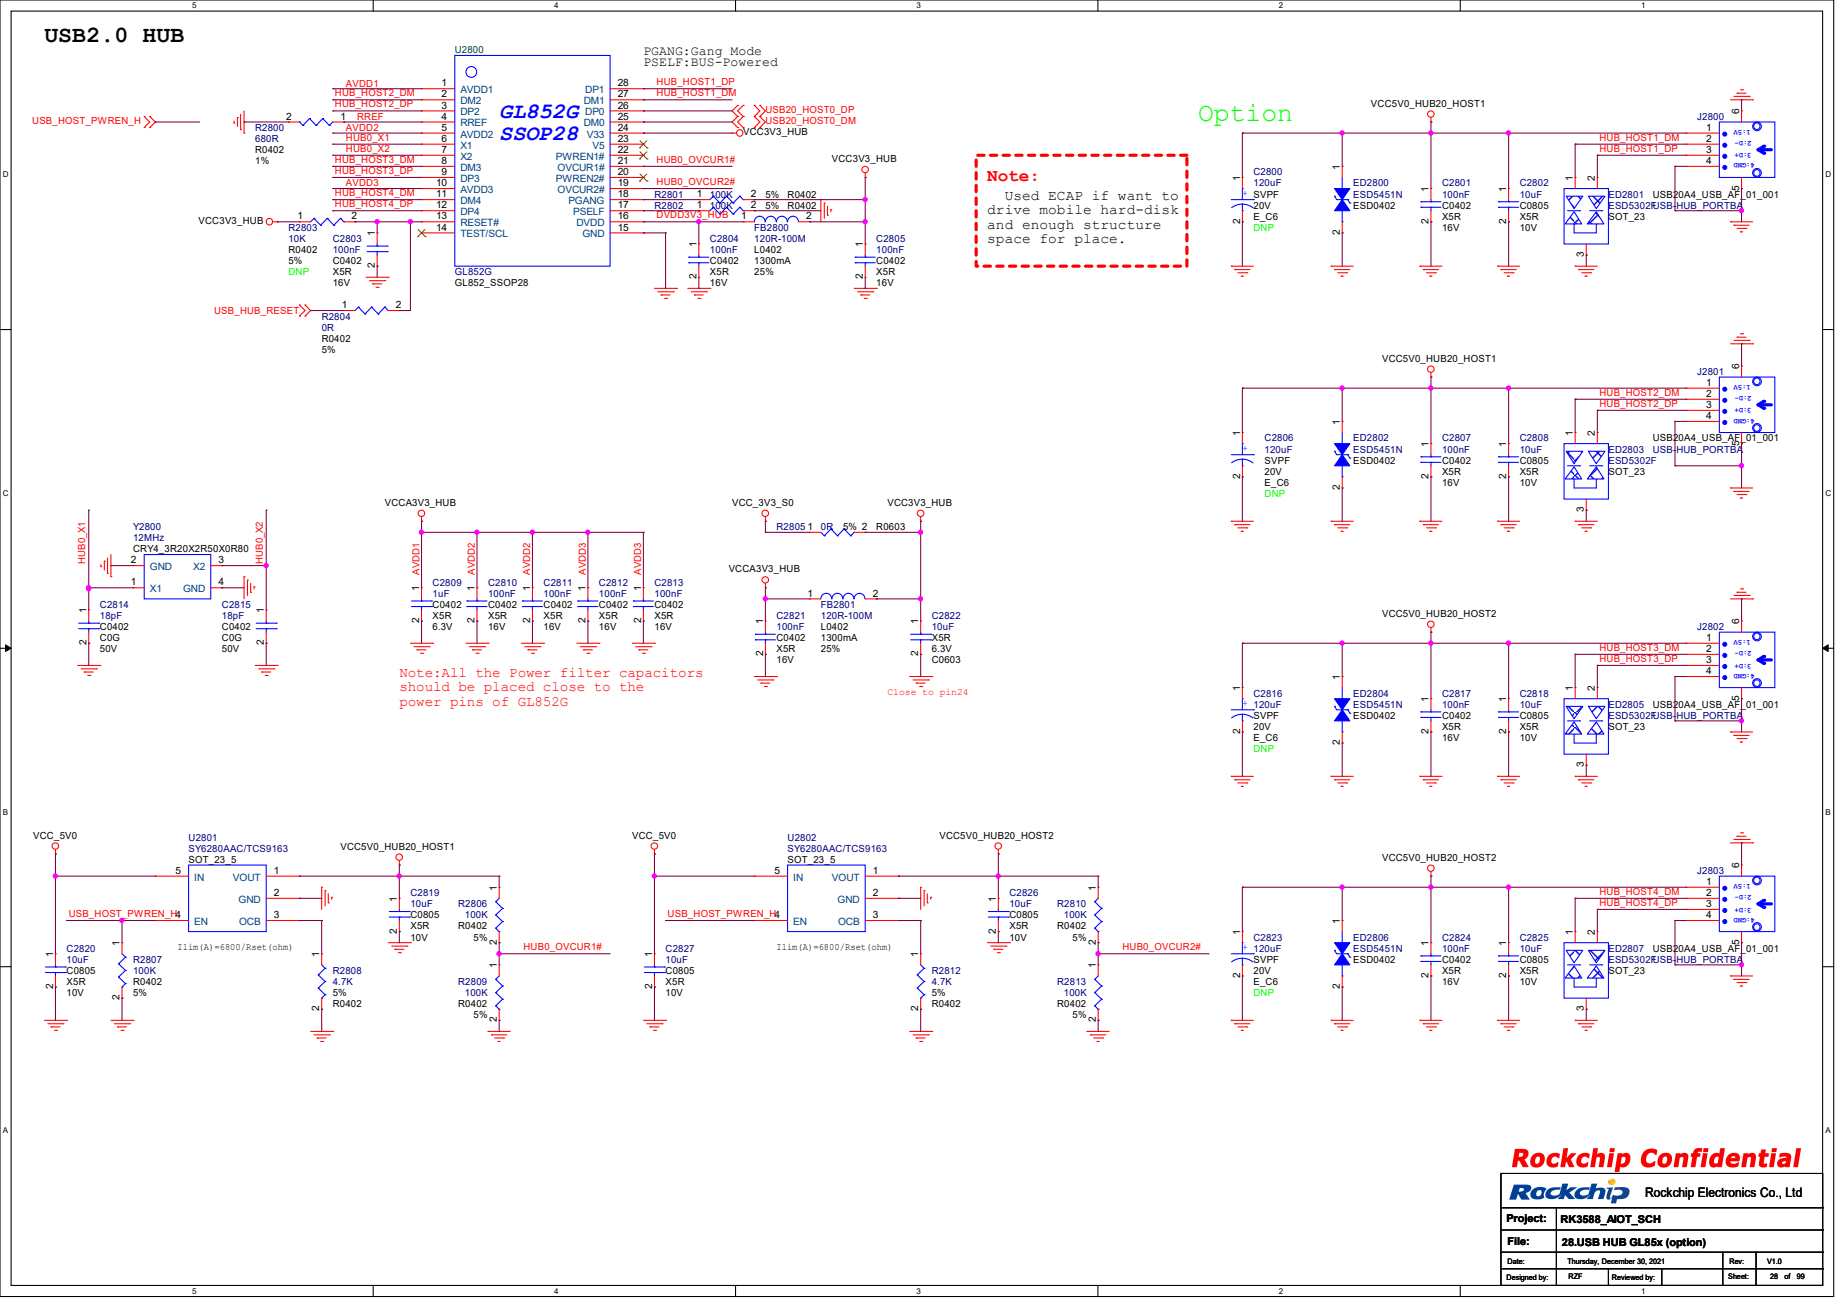
[picture p27: page 27]

drive mobile hard-disk
and enough structure
space for place.

Note:All the Power filter capacitors
should be placed close to the

power pins of GL852G Ilim(A)=6800/Rset(ohm)

IN 5 U2801 SY6280AAC/TCS9163 SOT_23_5 OCB 3 GND 2 VOUT 1 EN 4

1 2 U2802 SY6280AAC/TCS9163 SOT_23_5 OCB 3 GND 2 VOUT 1 EN 4

# LPDDR4/4X

VSS_2 | A10 VDD1_2 F12 | VDDQ_5 D1 | VDDQ_6 D5 | VDD2_3 F5 | VDD2_4 F8 | VDDQ_7 D8 | VDDQ_8 D12

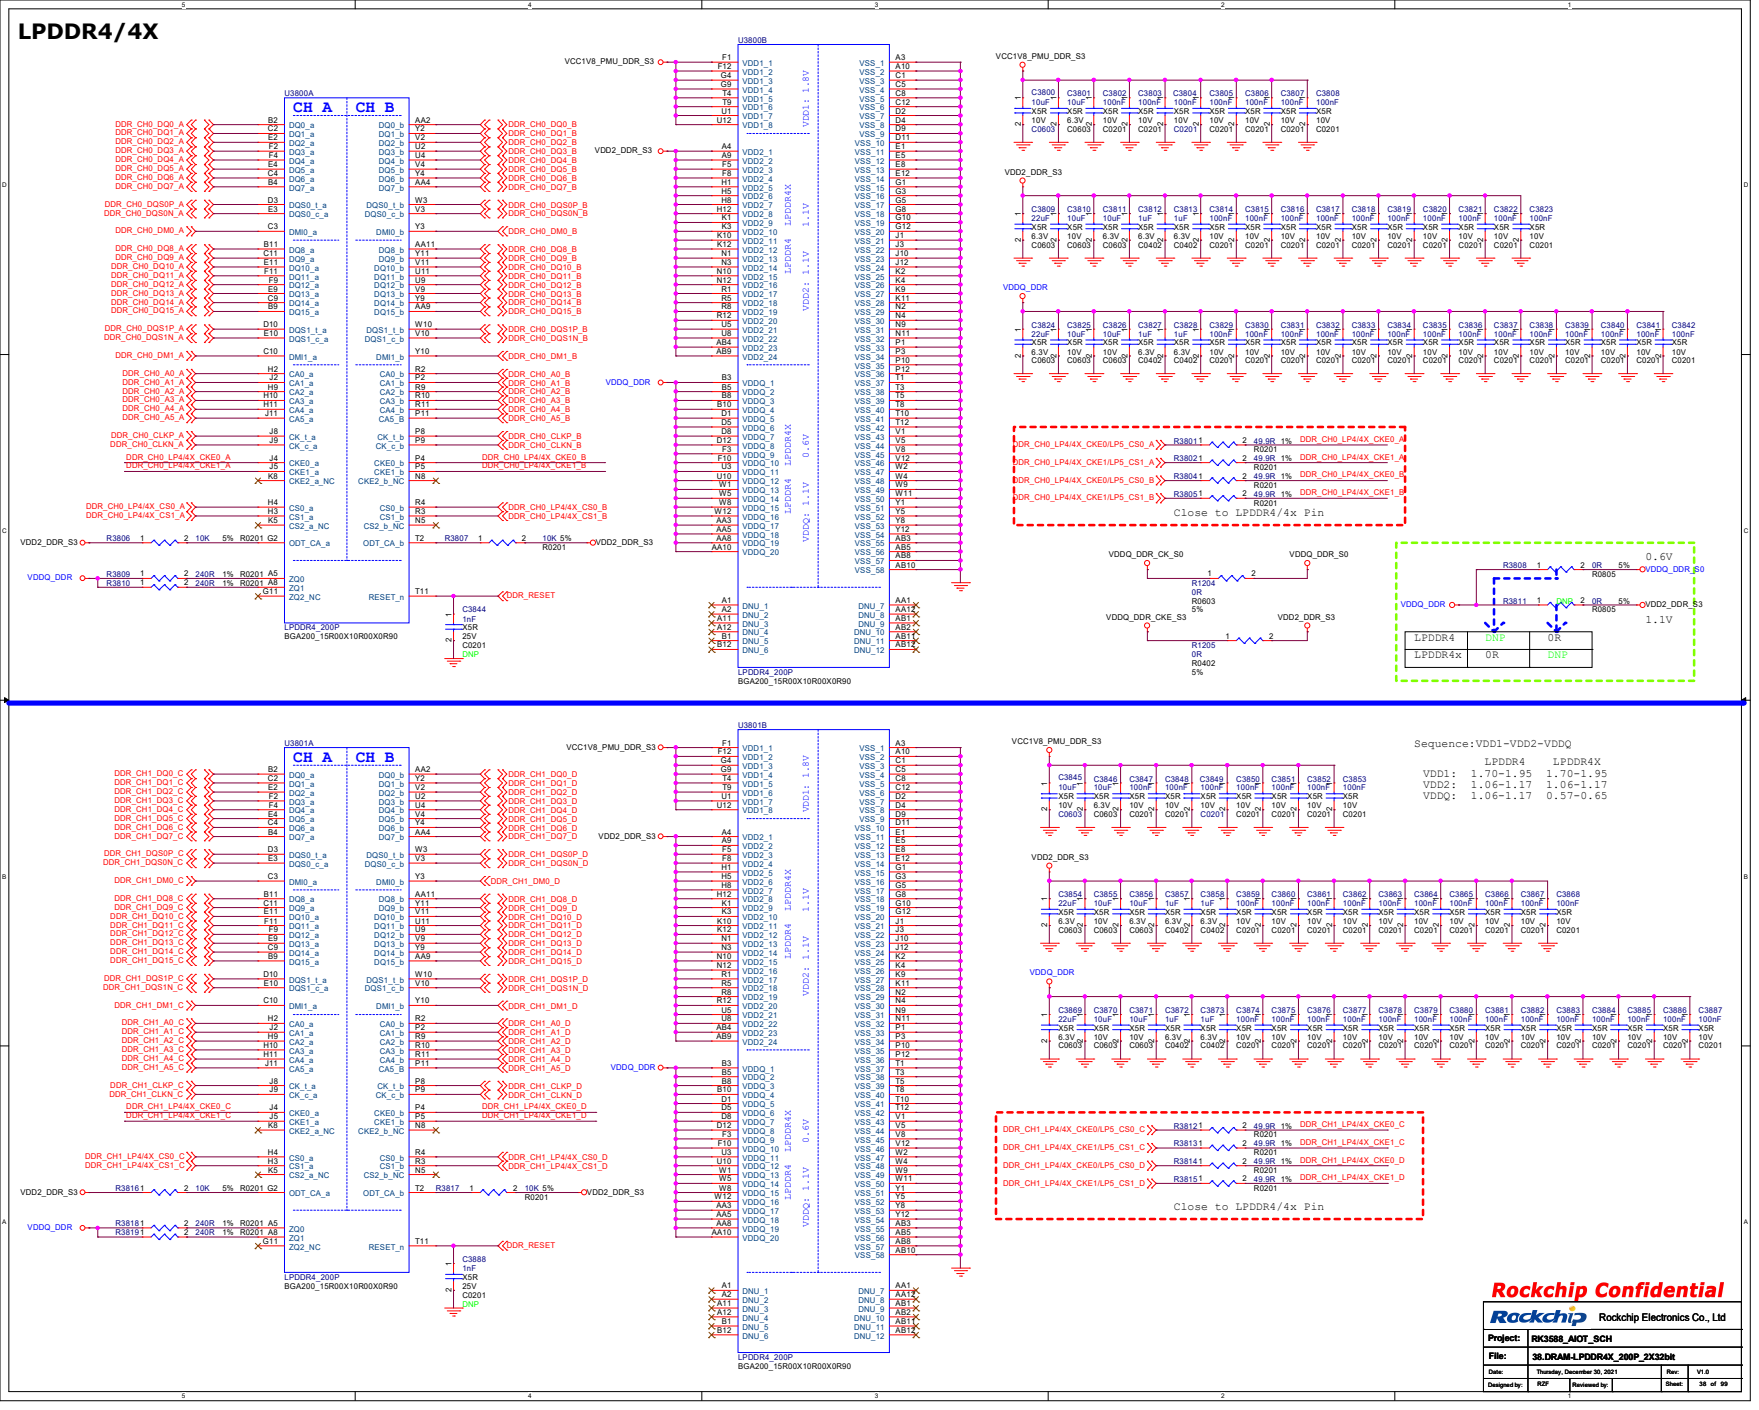
[picture p28: page 28]

# LPDDR5

# VDDQ_DDR_S0 VDD2H_DDR_S3 VDD2H_DDR_S3

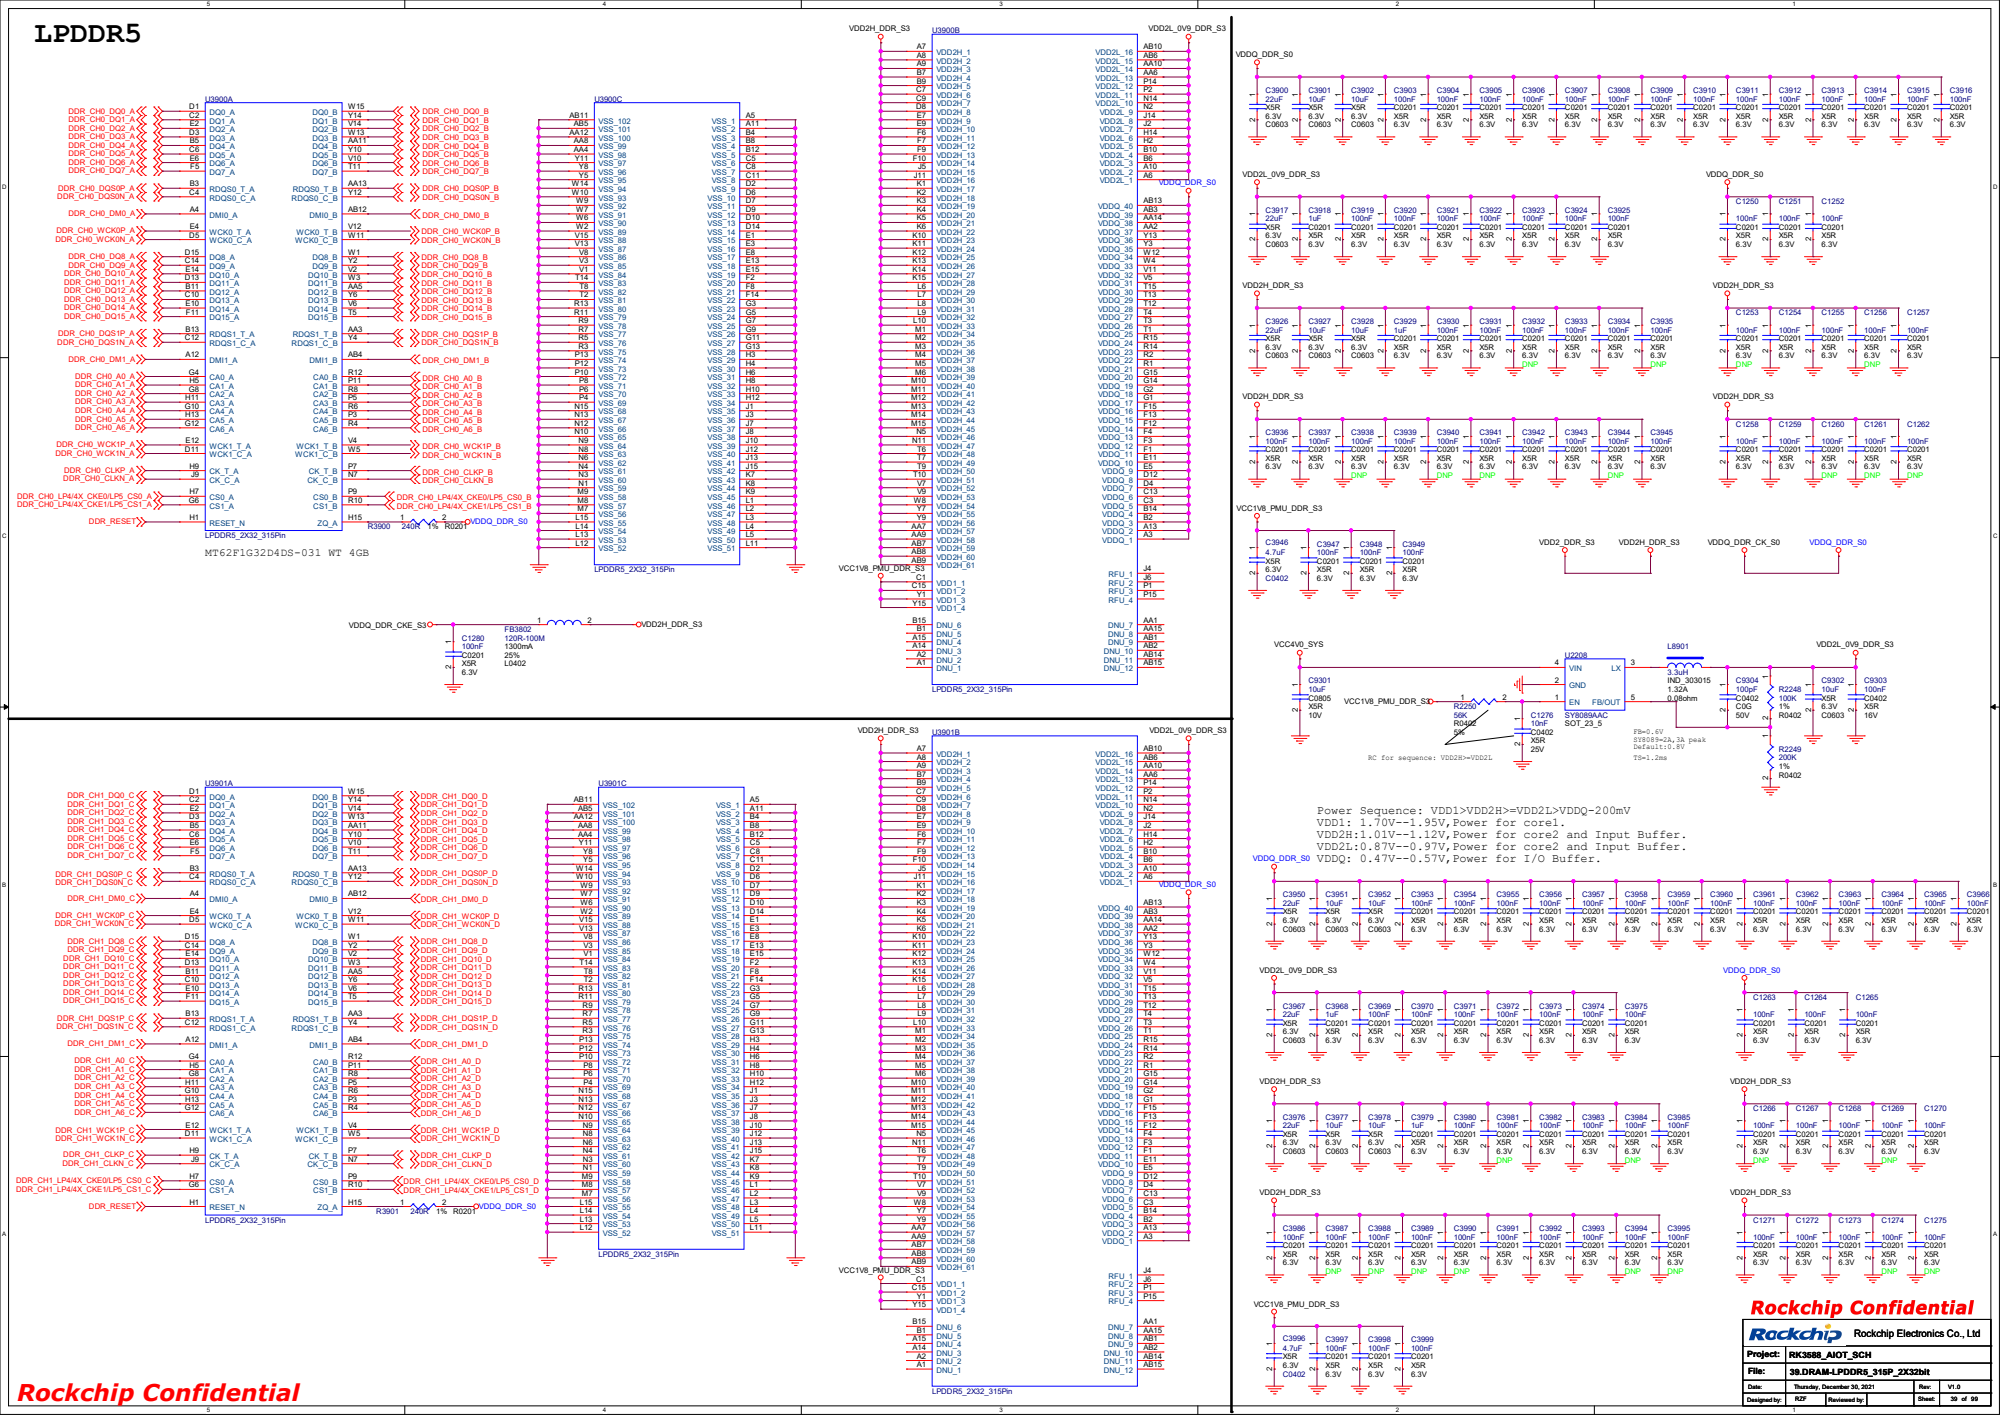
[picture p29: page 29]

Power Sequence: VDD1>VDD2H>=VDD2L>VDDQ-200mV
VDD1: 1.70V--1.95V,Power for core1.
VDD2H:1.01V--1.12V,Power for core2 and Input Buffer.
VDD2L:0.87V--0.97V,Power for core2 and Input Buffer.

# eMMC FLASH

## VCC_1V8_S3

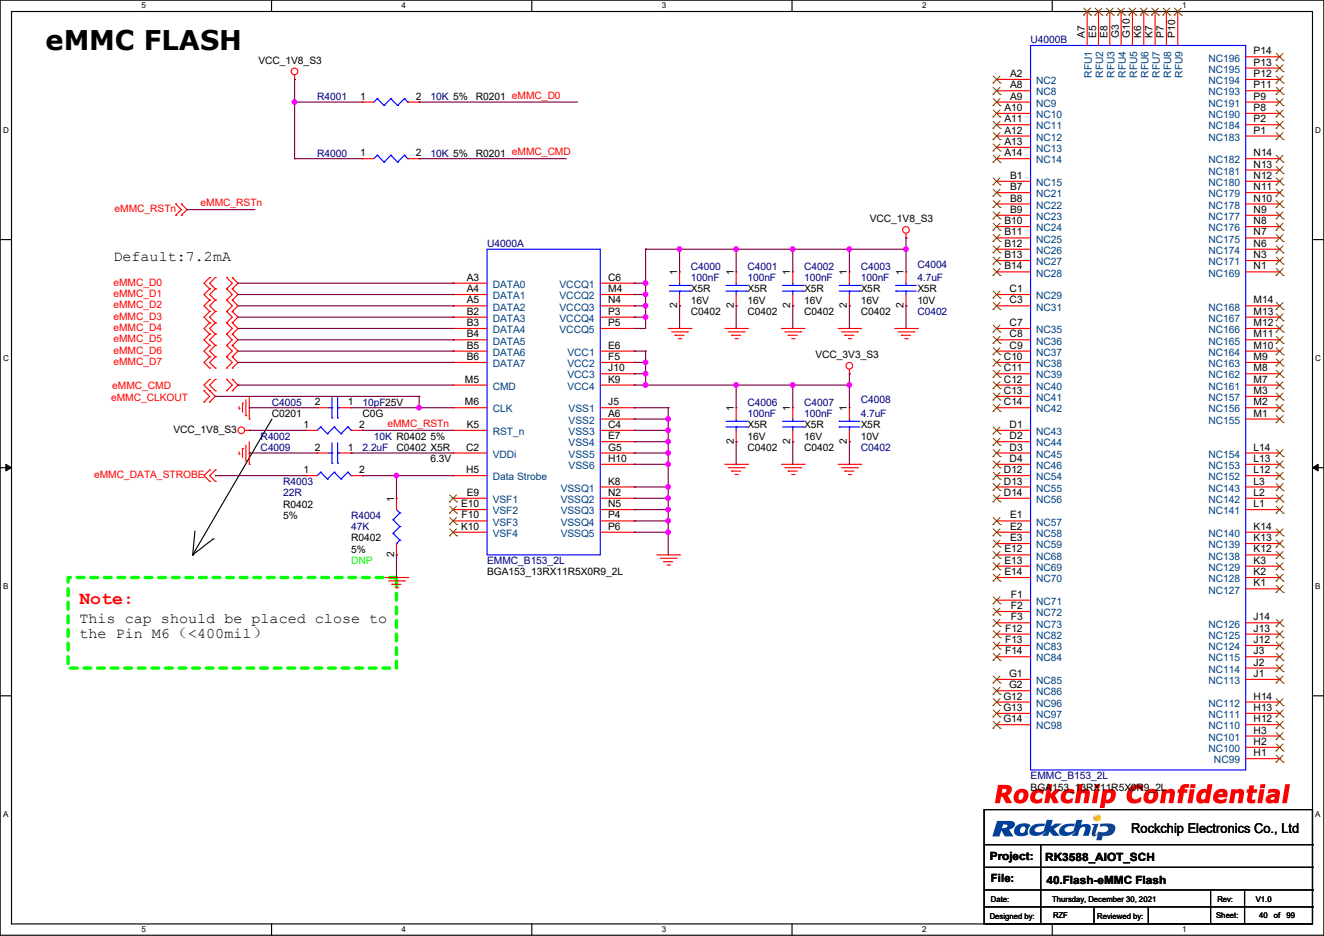
[picture p30: page 30]

NC127 K1 NC128 K2 NC129 K3 RFU⁶ K⁶ RFU⁷ K⁷

Note:
This cap should be placed close to
the Pin M6（<400mil）

# TF CARD

## For discharge

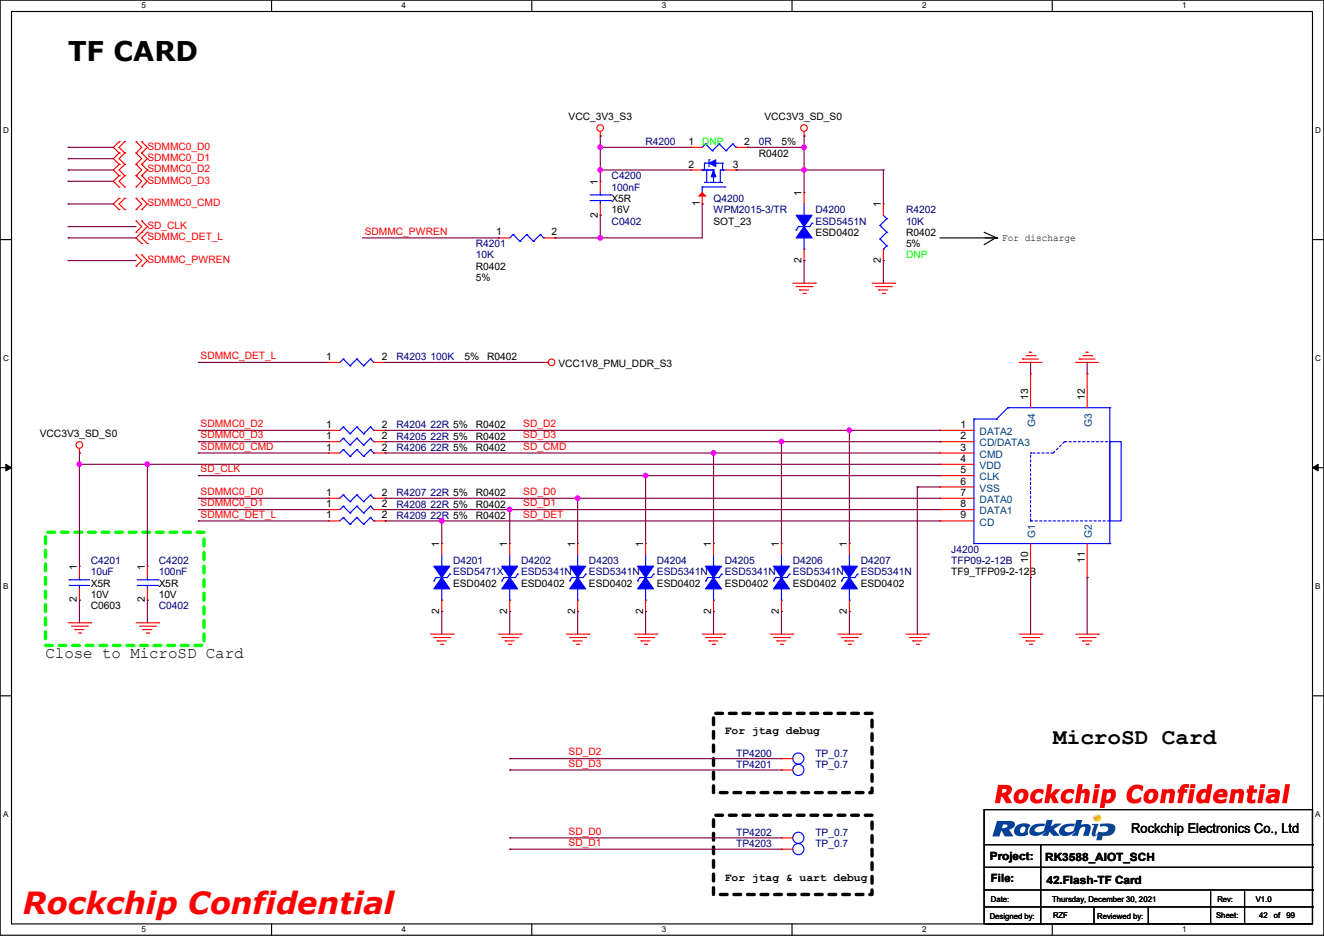
[picture p31: page 31]

Close to MicroSD Card

For jtag & uart debug

# SPI NOR OR NAND Flash

## FSPI_D0

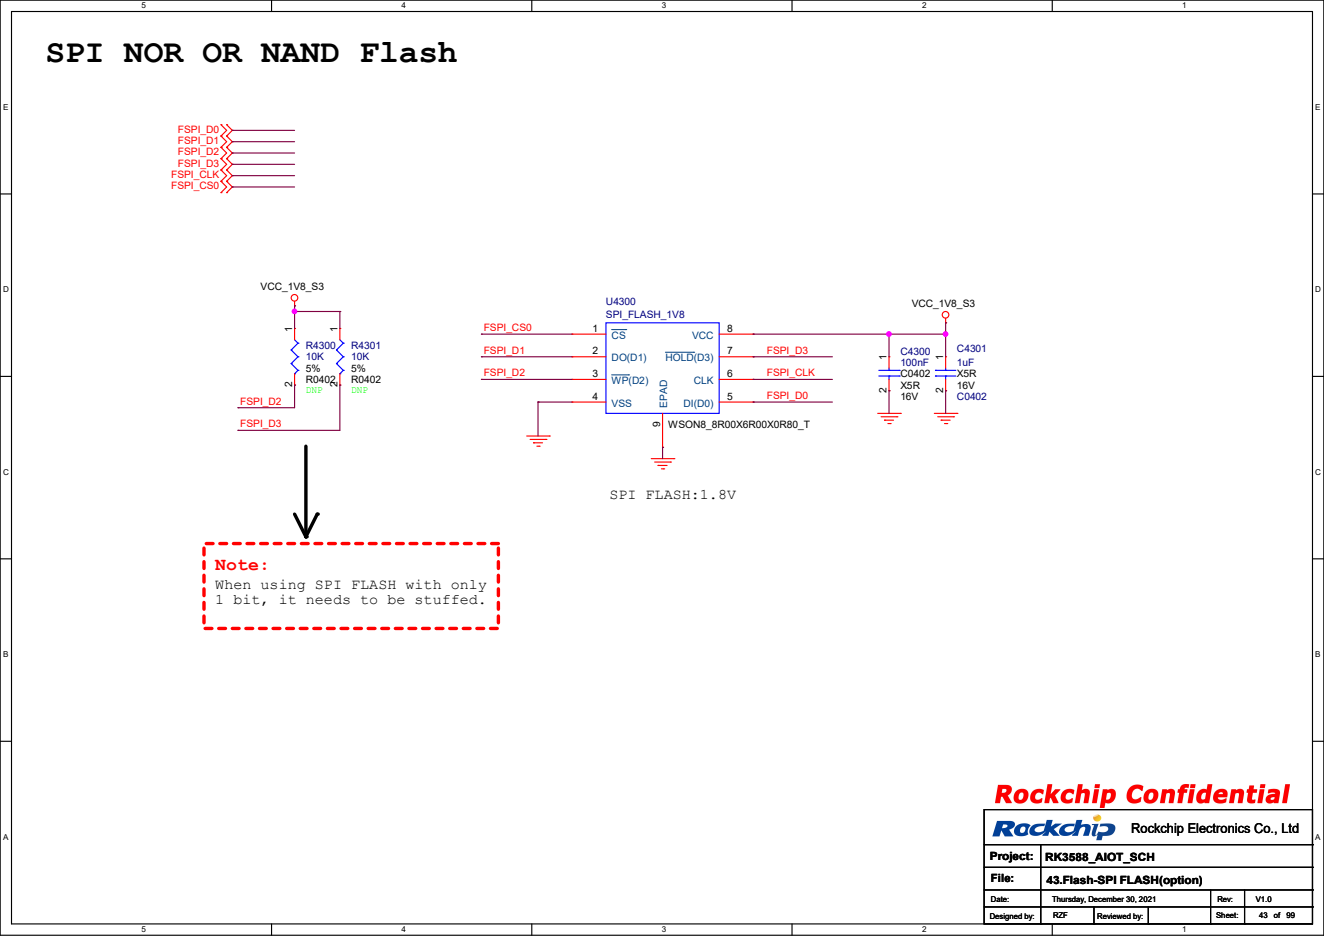
[picture p32: page 32]
SPI FLASH:1.8V; VCC_1V8_S3; FSPI_D1 FSPI_D2 FSPI_D3 FSPI_CLK FSPI_CS0; Project:; File: Date:; Rockchip Electronics Co., Ltd; RZF; 99 V1.0 Project:; DNP; 1 2 U4300 SPI_FLASH_1V8; WSON8_8R00X6R00X0R80_T; VCC 8 CS 1; VSS 4; CLK 6; HOLD(D3) 7 EPAD; FSPI_CS0; FSPI_D1; FSPI_D2; FSPI_CLK; FSPI_D0; FSPI_D3

Note:
When using SPI FLASH with only
1 bit, it needs to be stuffed.

RK3588_AIOT_SCH
43.Flash-SPI FLASH(option)

# VI-Camera D/CPHY0_RX

## NOTE:For Sony SENSOR,SYNC Mode

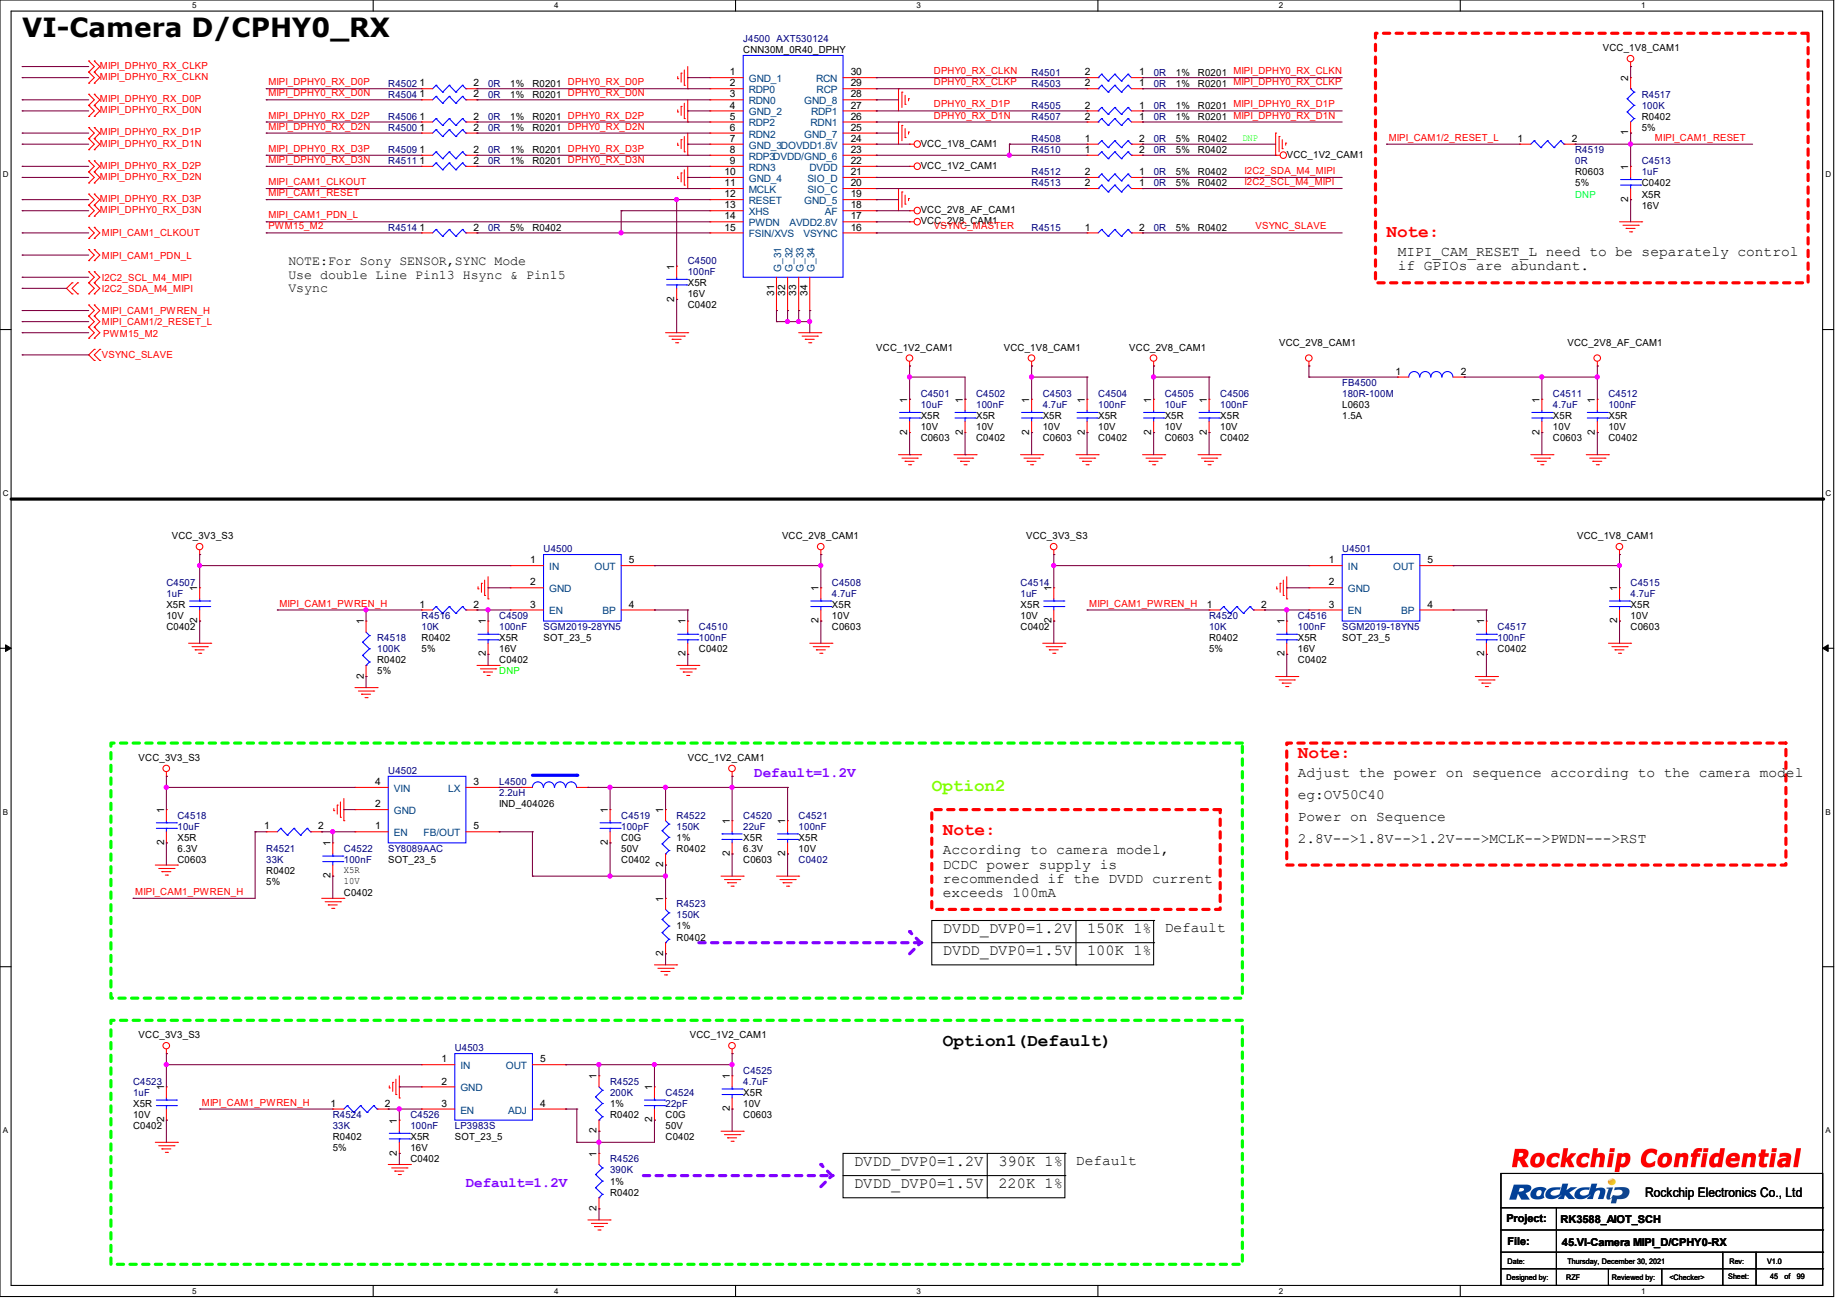
[picture p33: page 33]

Note:
MIPI_CAM_RESET_L need to be separately control
if GPIOs are abundant.

Use double Line Pin13 Hsync & Pin15
Vsync

Adjust the power on sequence according to the camera model
Power on Sequence
2.8V-->1.8V-->1.2V--->MCLK-->PWDN--->RST

According to camera model,
DCDC power supply is
recommended if the DVDD current
exceeds 100mA
DVDD_DVP0=1.5V

# VI-Camera D/CPHY1_RX

## MIPI_CAM_RESET_L need to be separately control

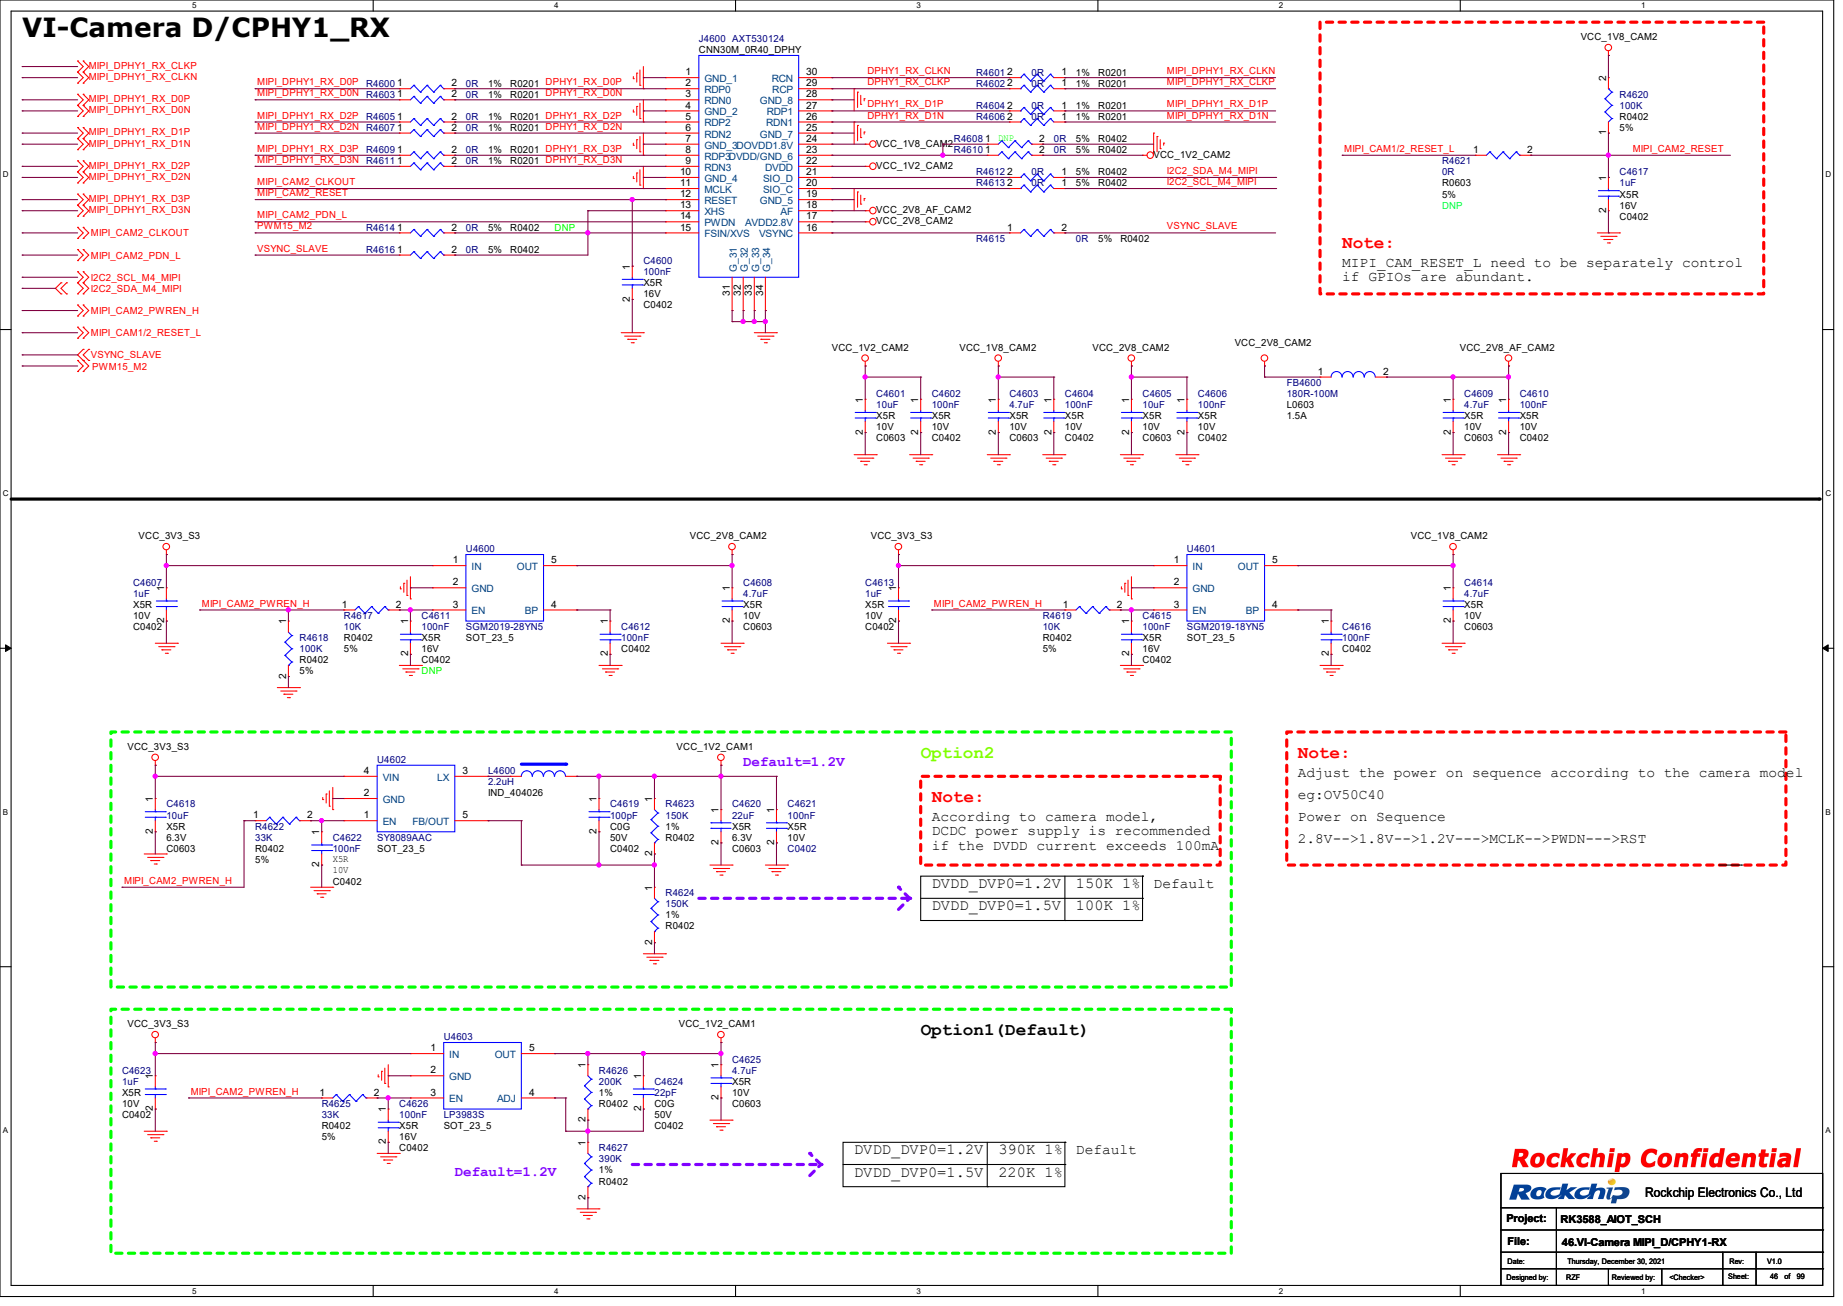
[picture p34: page 34]

if GPIOs are abundant.

Note:
Adjust the power on sequence according to the camera model
Power on Sequence
2.8V-->1.8V-->1.2V--->MCLK-->PWDN--->RST

According to camera model,
DCDC power supply is recommended
if the DVDD current exceeds 100mA

# MIPI-DPHY0_RX

## MIPI_CAM_RESET_L need to be separately control

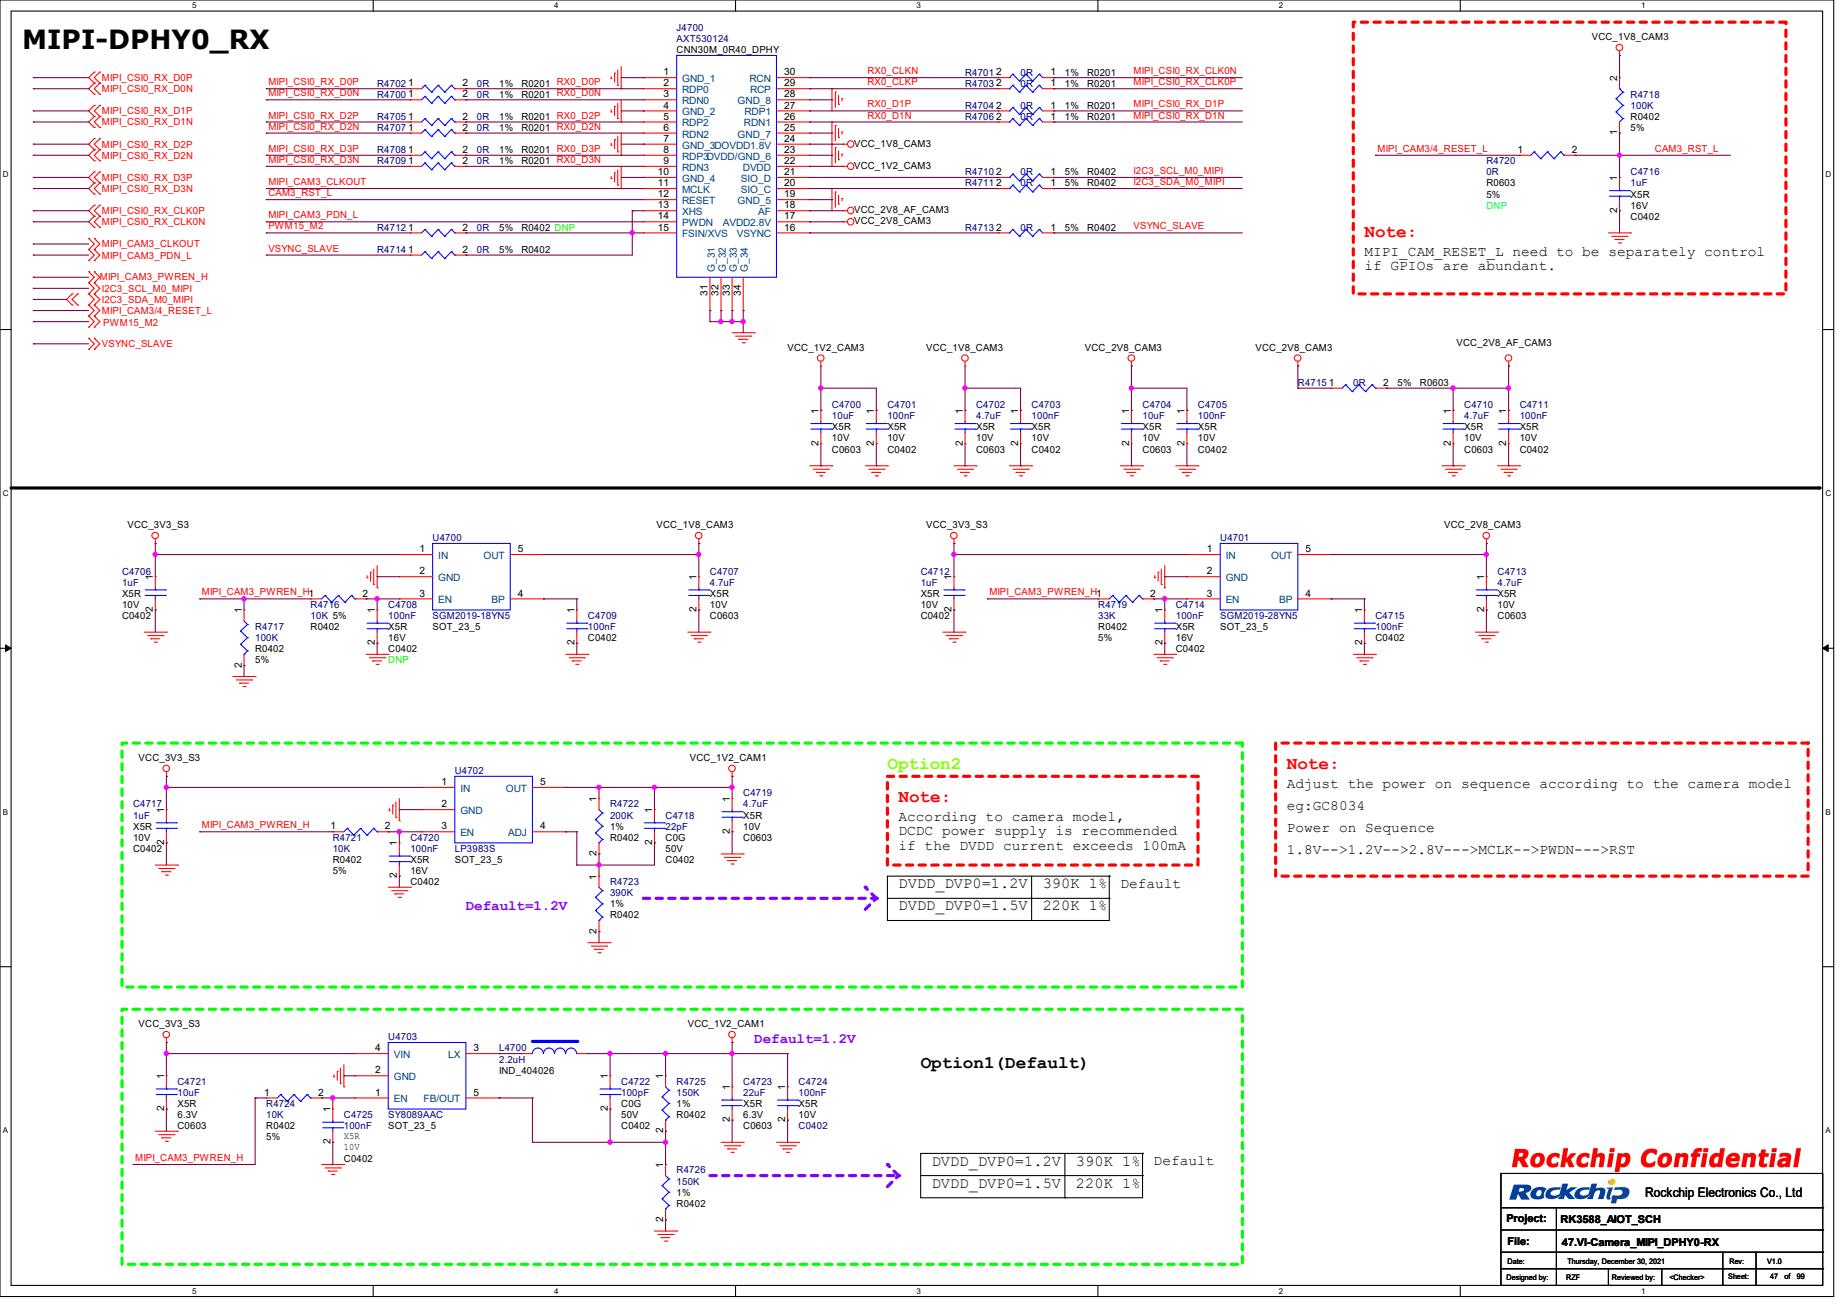
[picture p35: page 35]

if GPIOs are abundant.

Option2
Note:
According to camera model,
DCDC power supply is recommended
if the DVDD current exceeds 100mA

# MIPI-DPHY1_RX

## MIPI_CAM_RESET_L need to be separately control

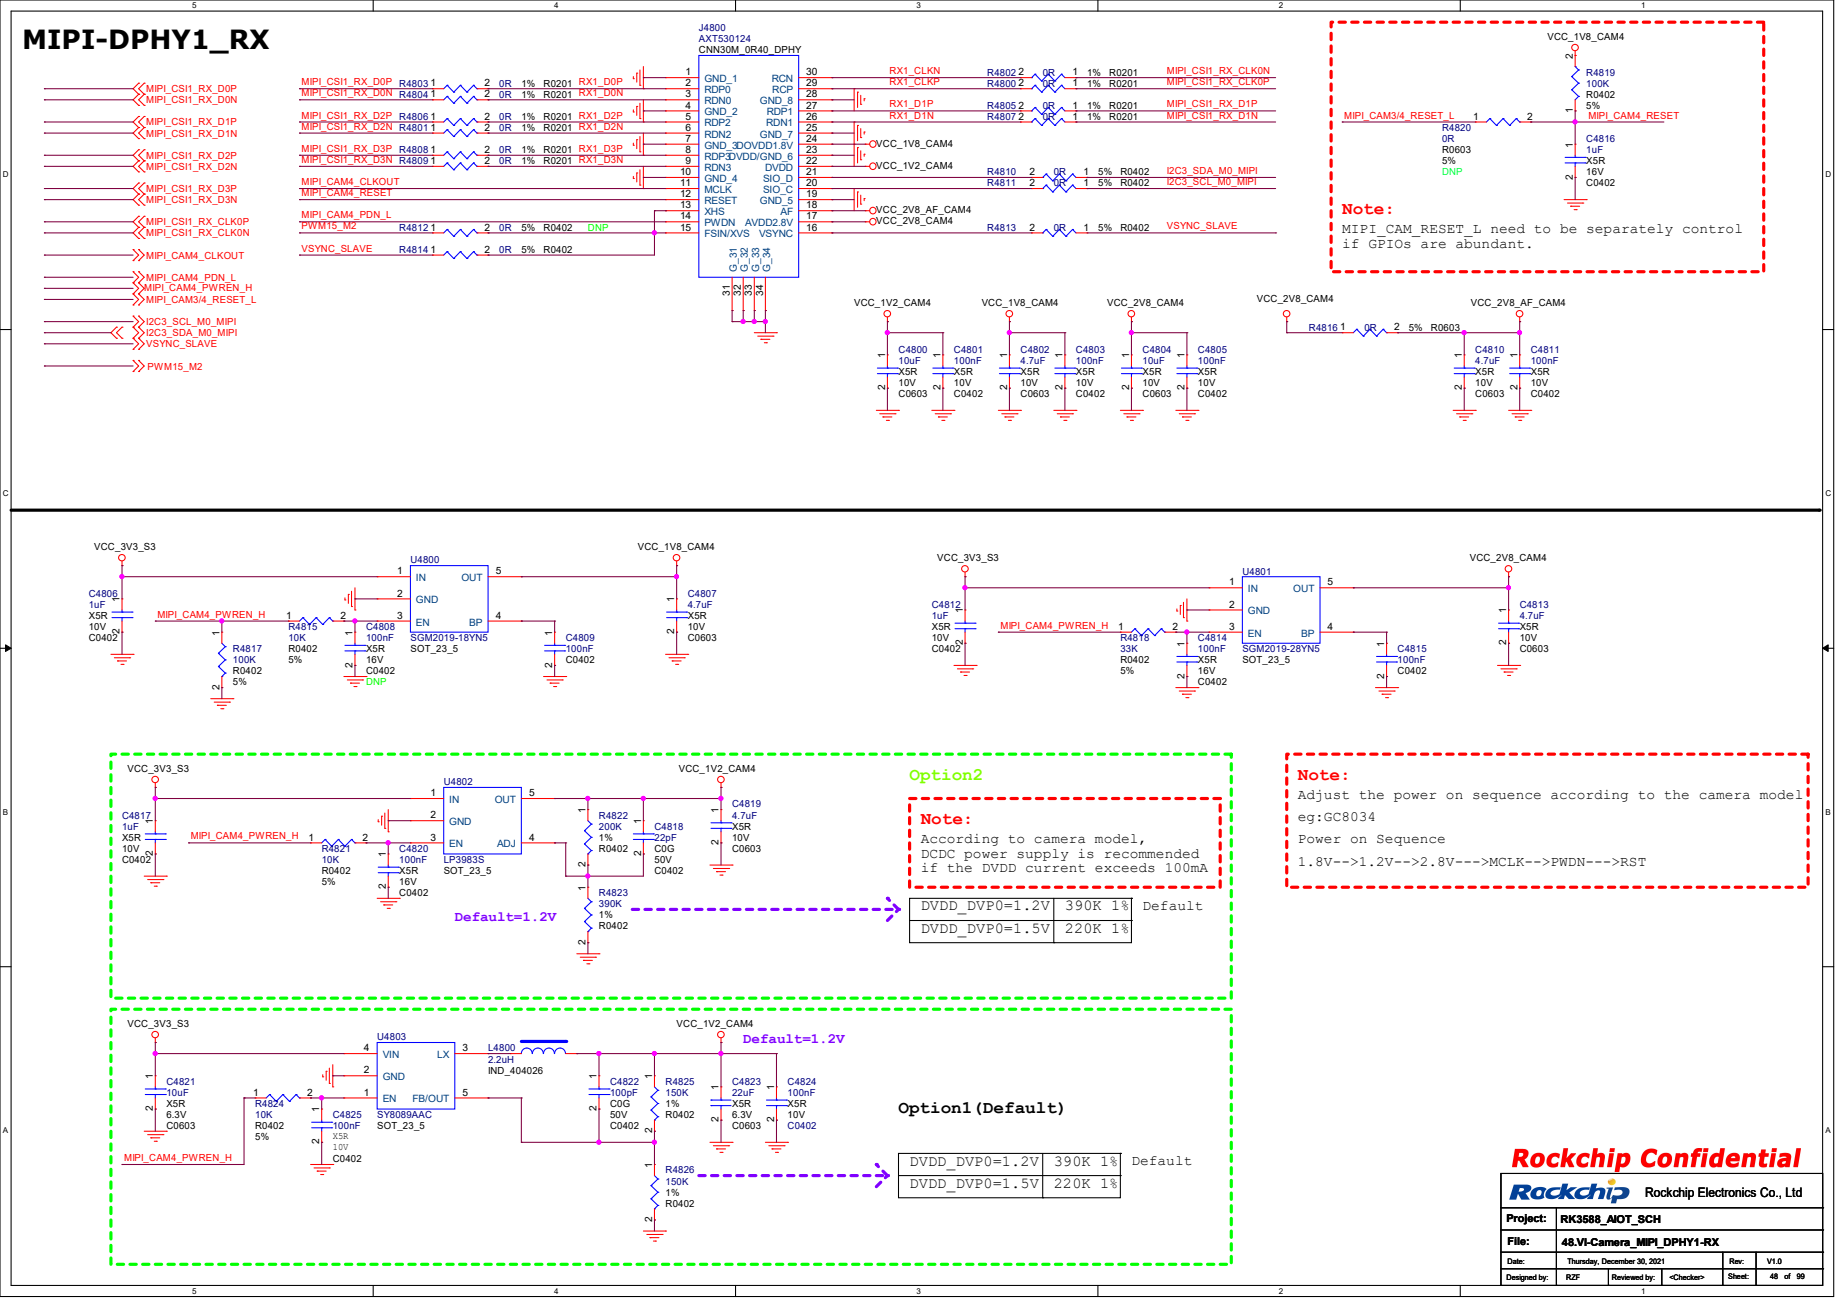
[picture p36: page 36]

if GPIOs are abundant.

Note:
Adjust the power on sequence according to the camera model
Power on Sequence
1.8V-->1.2V-->2.8V--->MCLK-->PWDN--->RST

According to camera model,
DCDC power supply is recommended
if the DVDD current exceeds 100mA

# HDMI2.0 RX

## VCC5V_HDMIRX_PORT

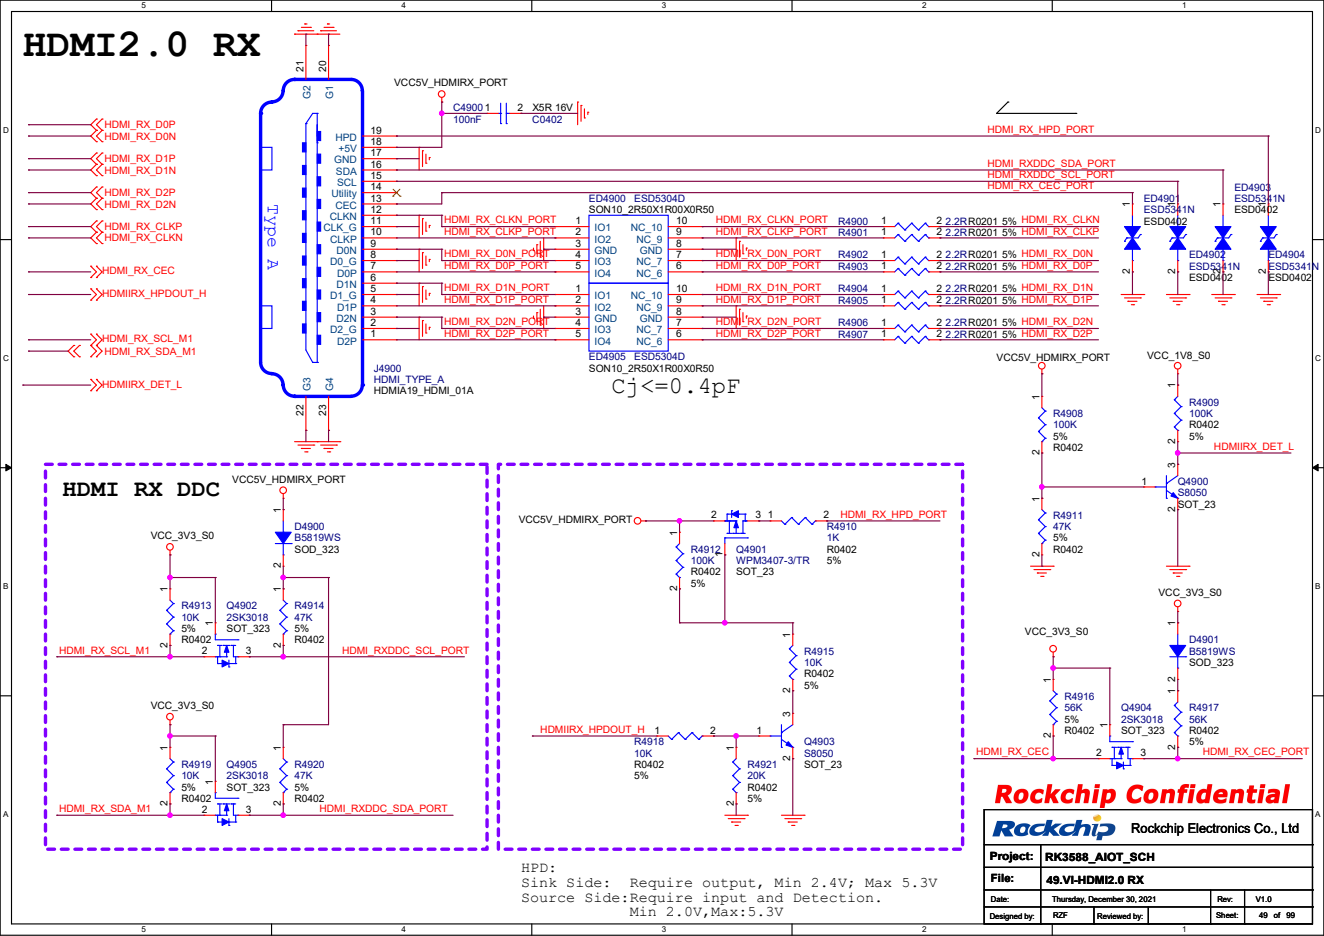
[picture p37: page 37]

HPD:
Sink Side: Require output, Min 2.4V; Max 5.3V
Source Side:Require input and Detection.

# HDMI TX DDC

# HDMI TX eARC

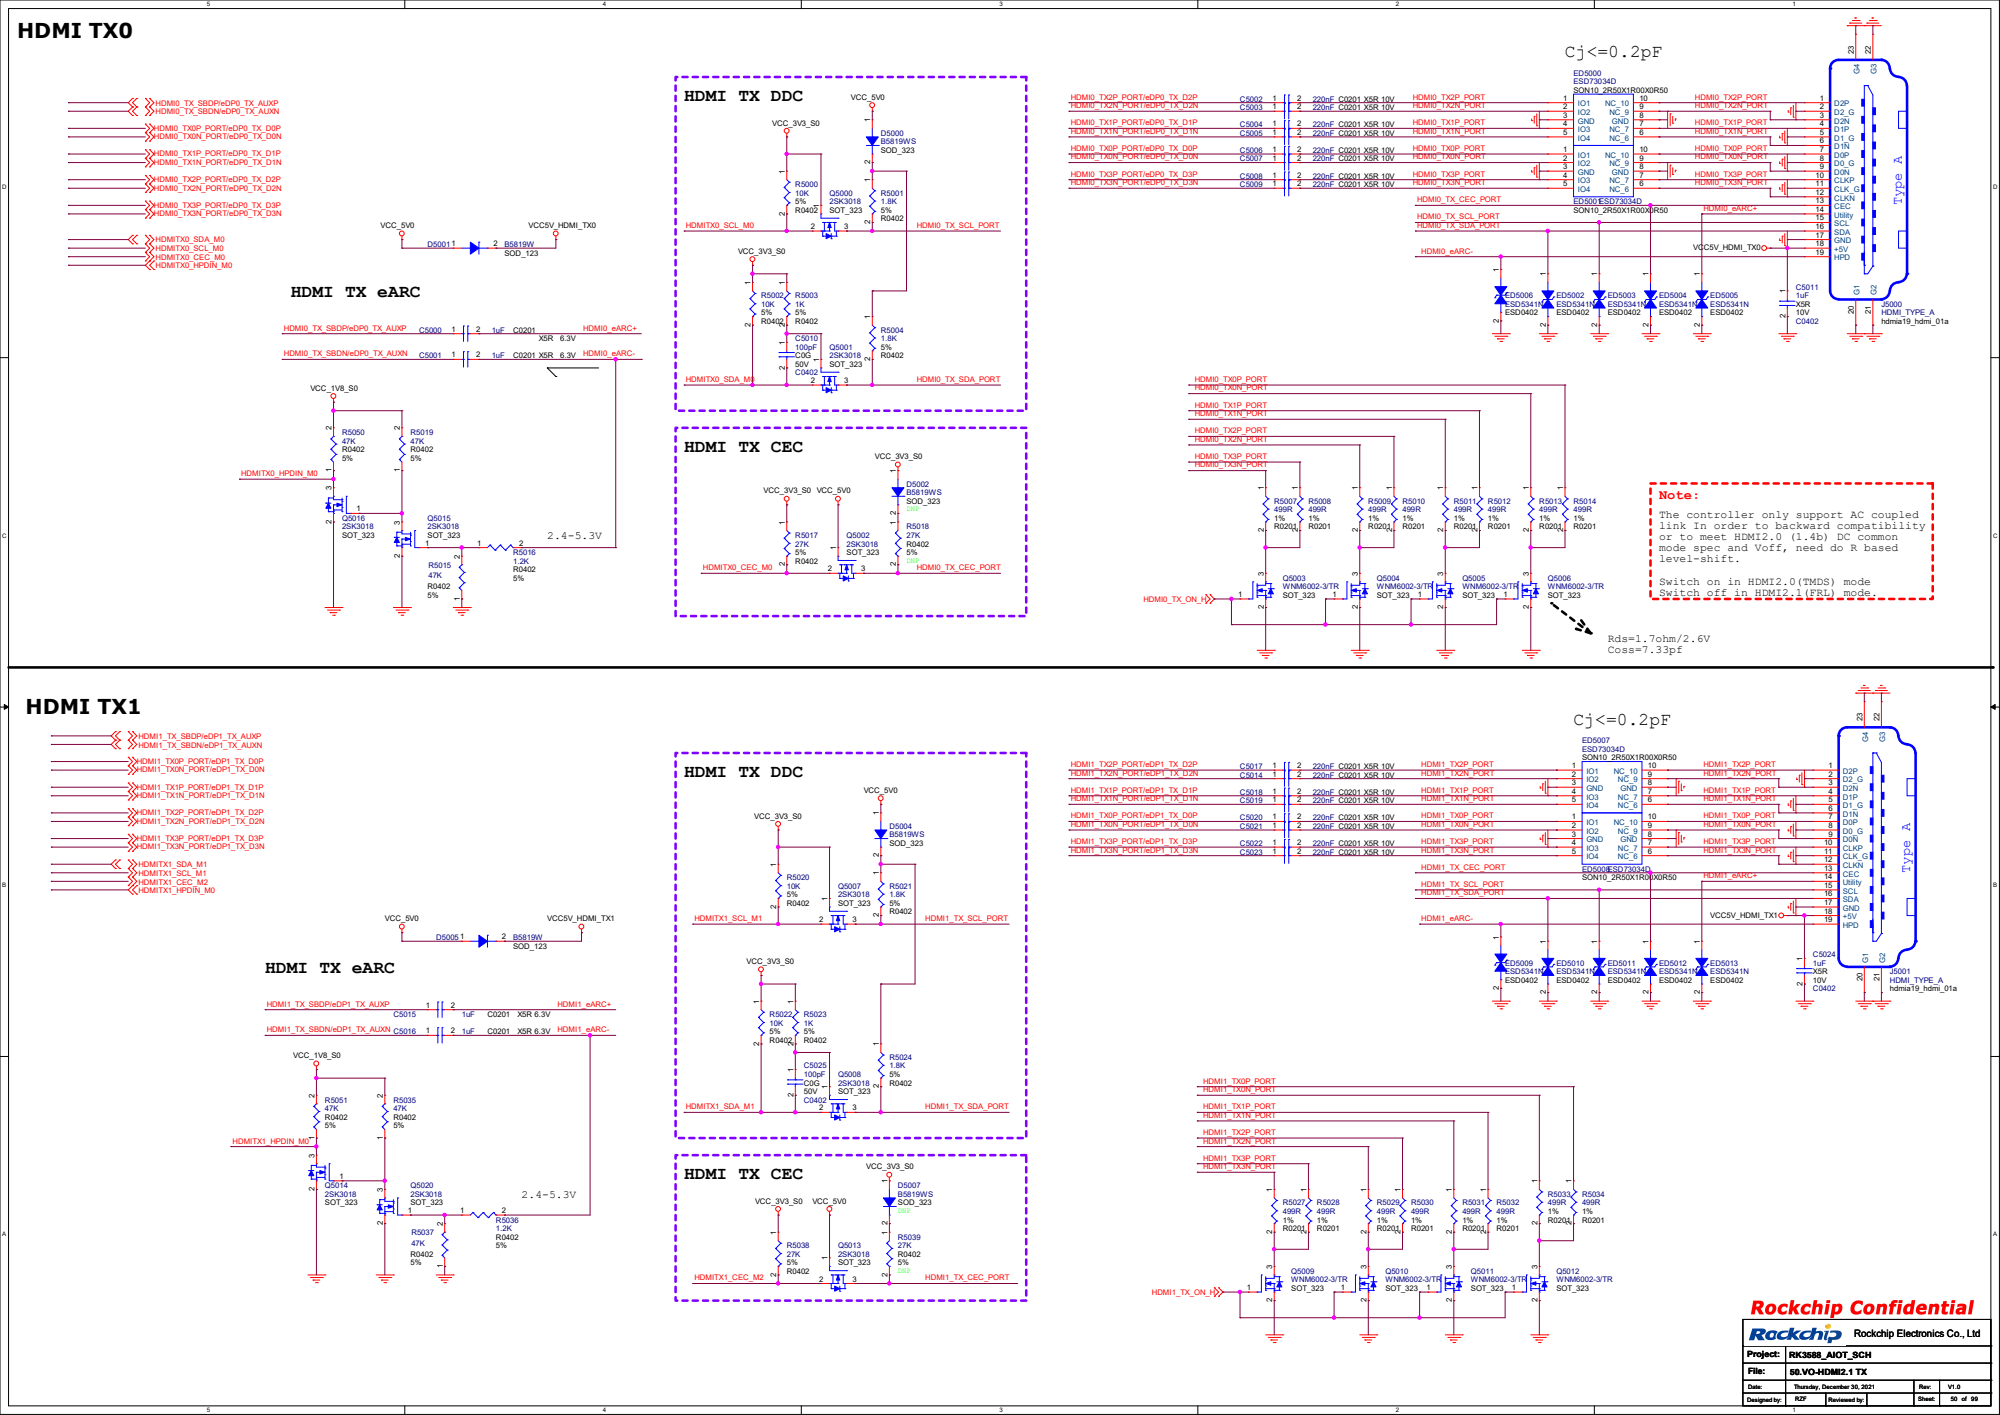
[picture p38: page 38]

Note: The controller only support AC coupled

link In order to backward compatibility
or to meet HDMI2.0 (1.4b) DC common
mode spec and Voff, need do R based
level-shift.
Switch on in HDMI2.0(TMDS) mode
Switch off in HDMI2.1(FRL) mode.

# Single-MIPI0 LCM

## VCC3V3_LCD

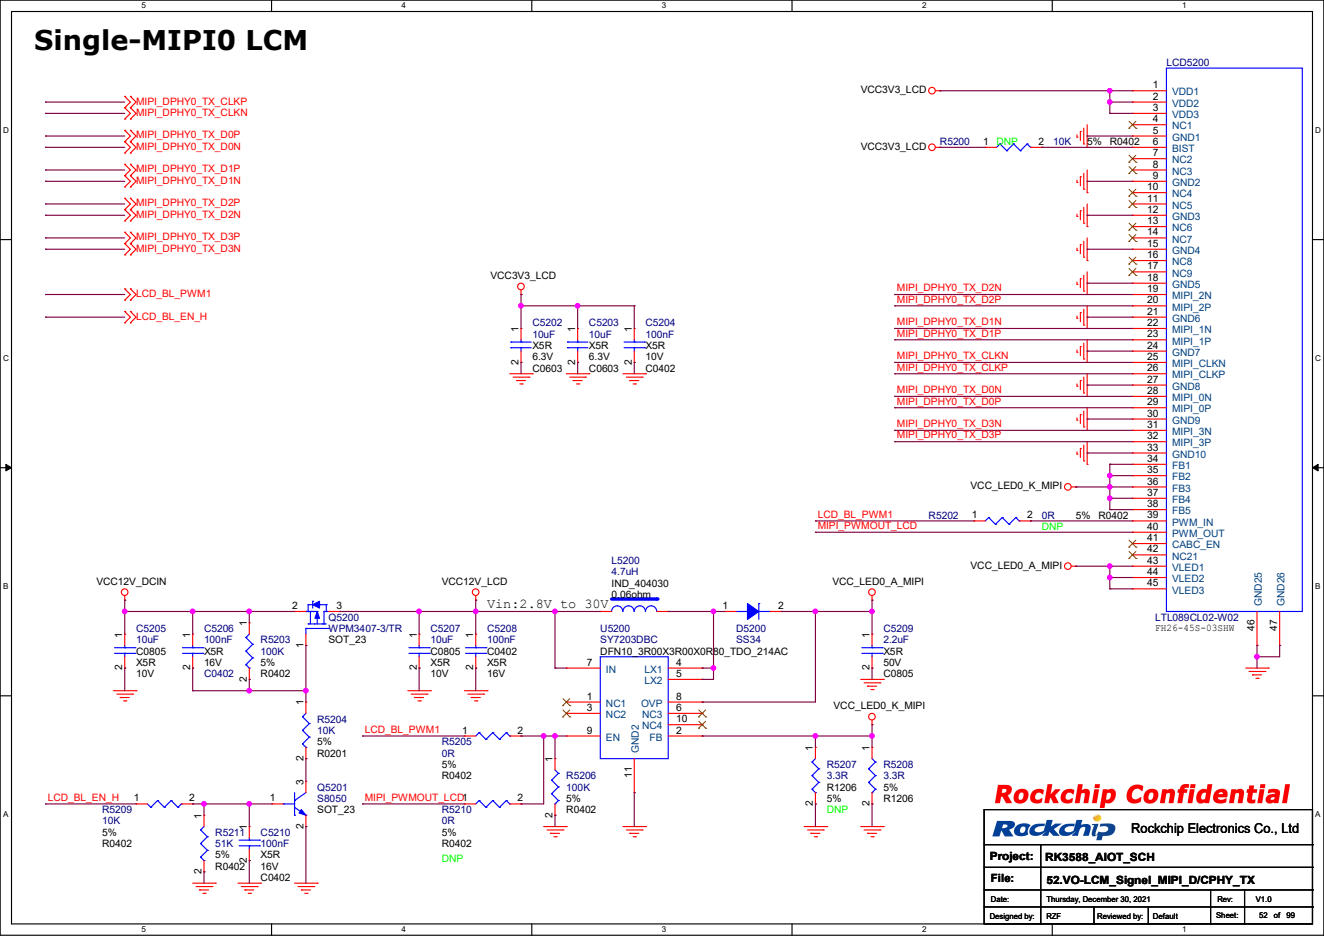
[picture p39: page 39]

# Dual-MIPI LCM

## VCC_LED0_A_DMIPI

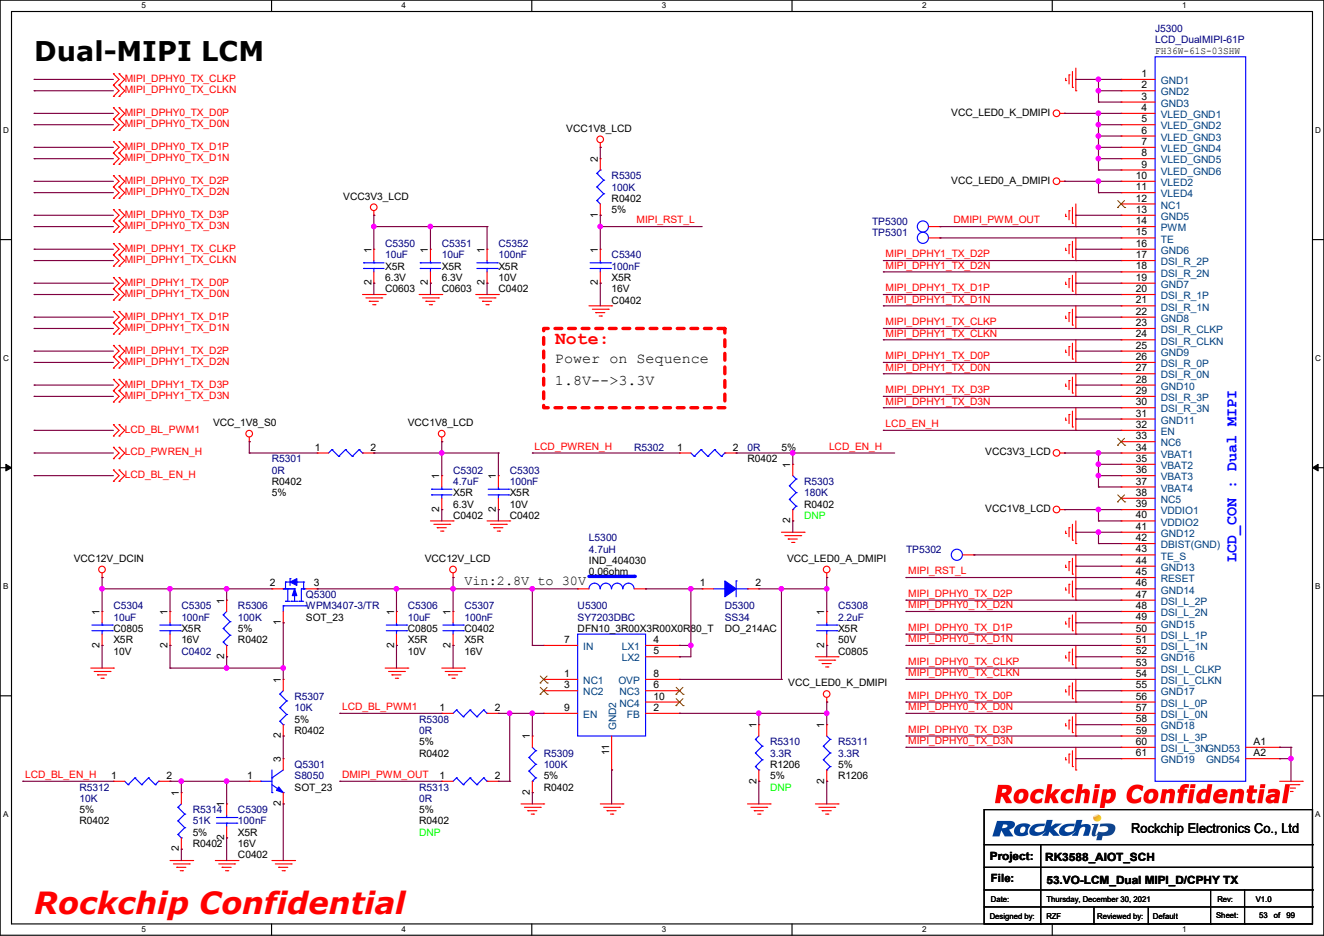
[picture p40: page 40]

# eDP LCD

## VCC3V3_LCD

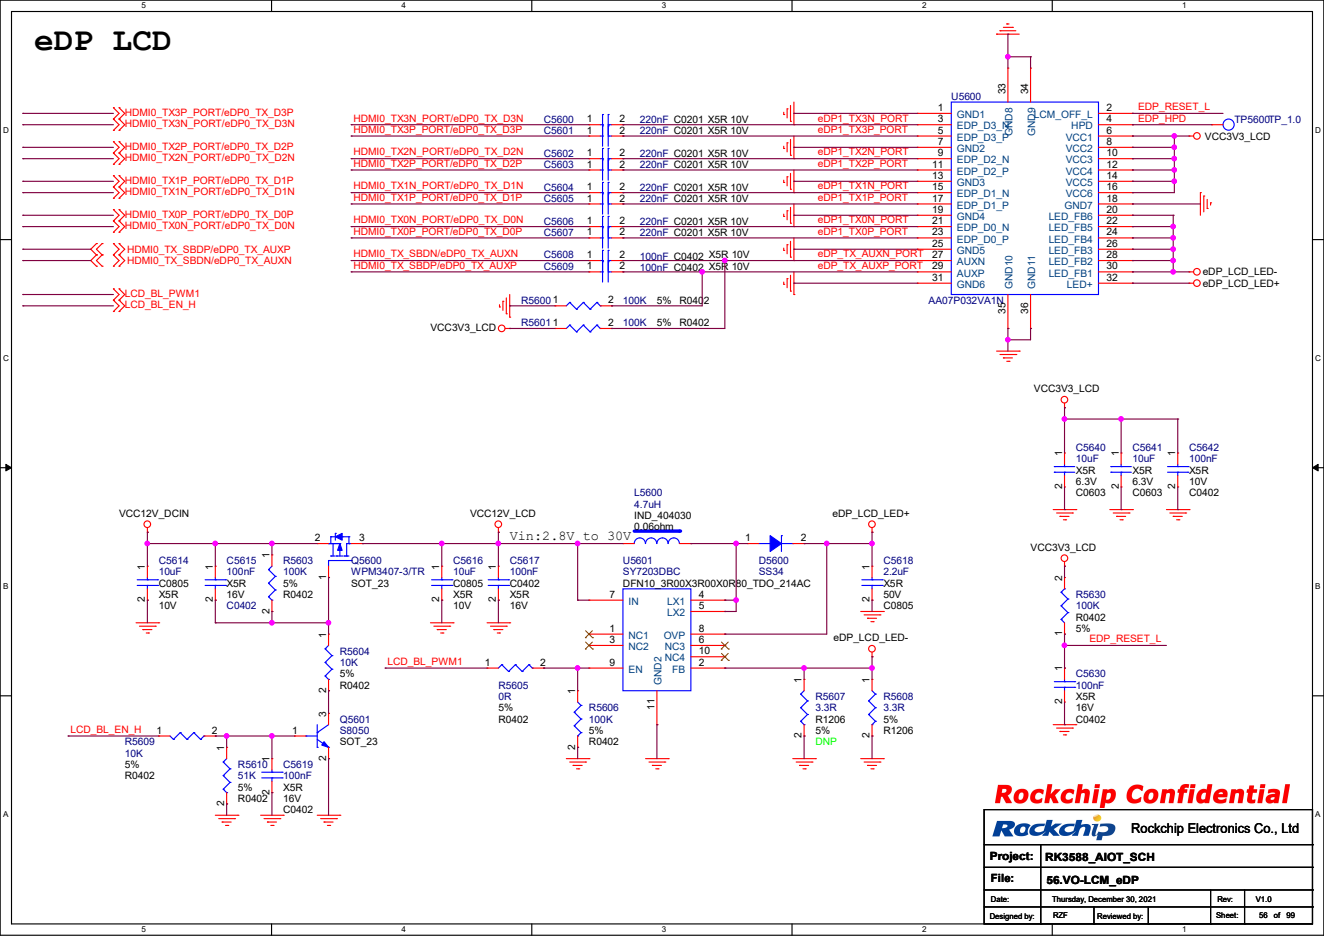
[picture p41: page 41]

# DisplayPort TX

## DP1_TX3P

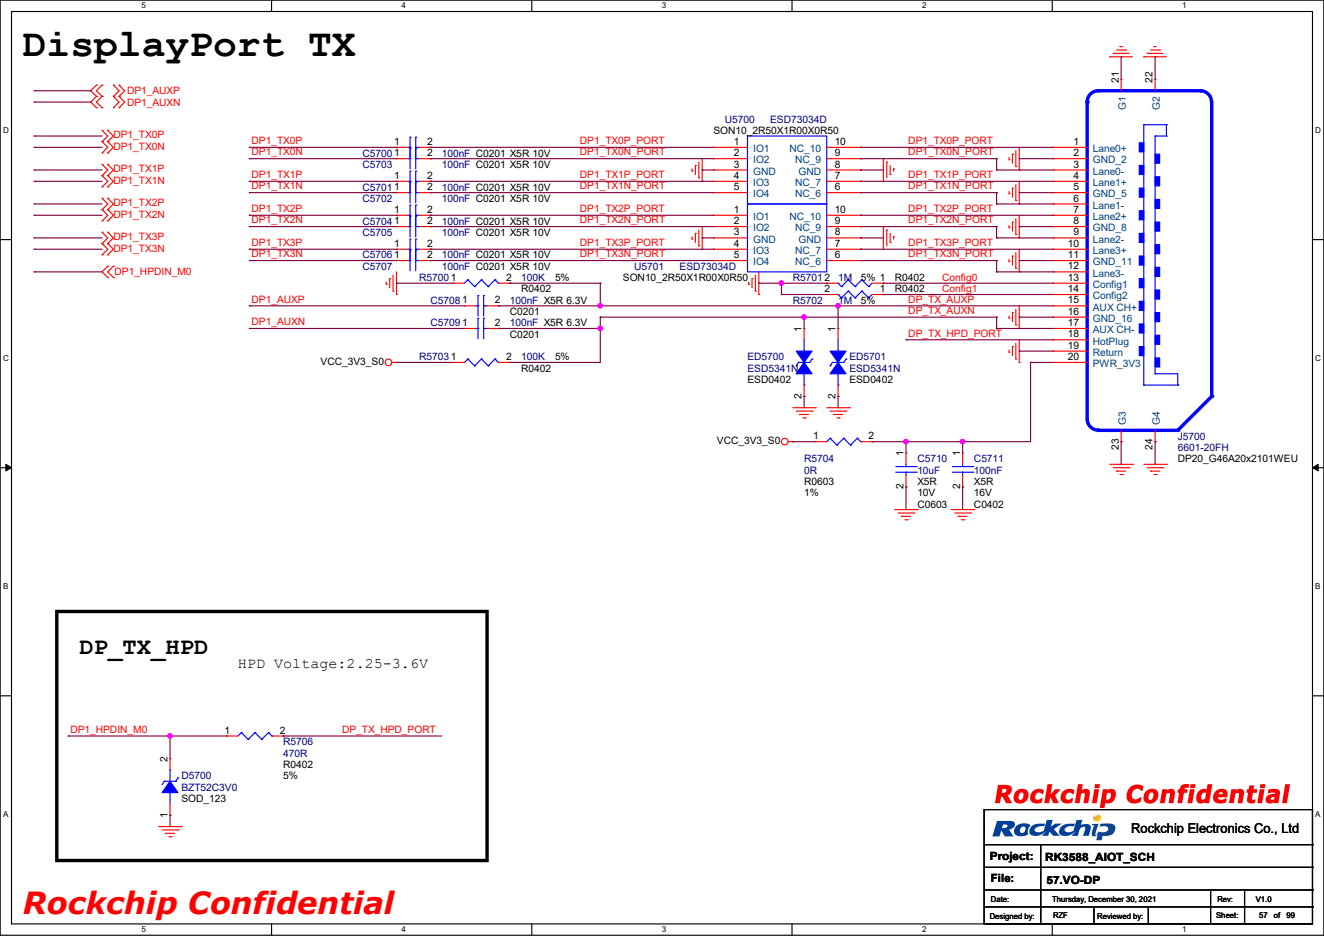
[picture p42: page 42]

C0201 | DP_TX_AUXN | | GND_16 16

DP_TX_HPD_PORT | AUX CH- 17

# VGA OUTPUT

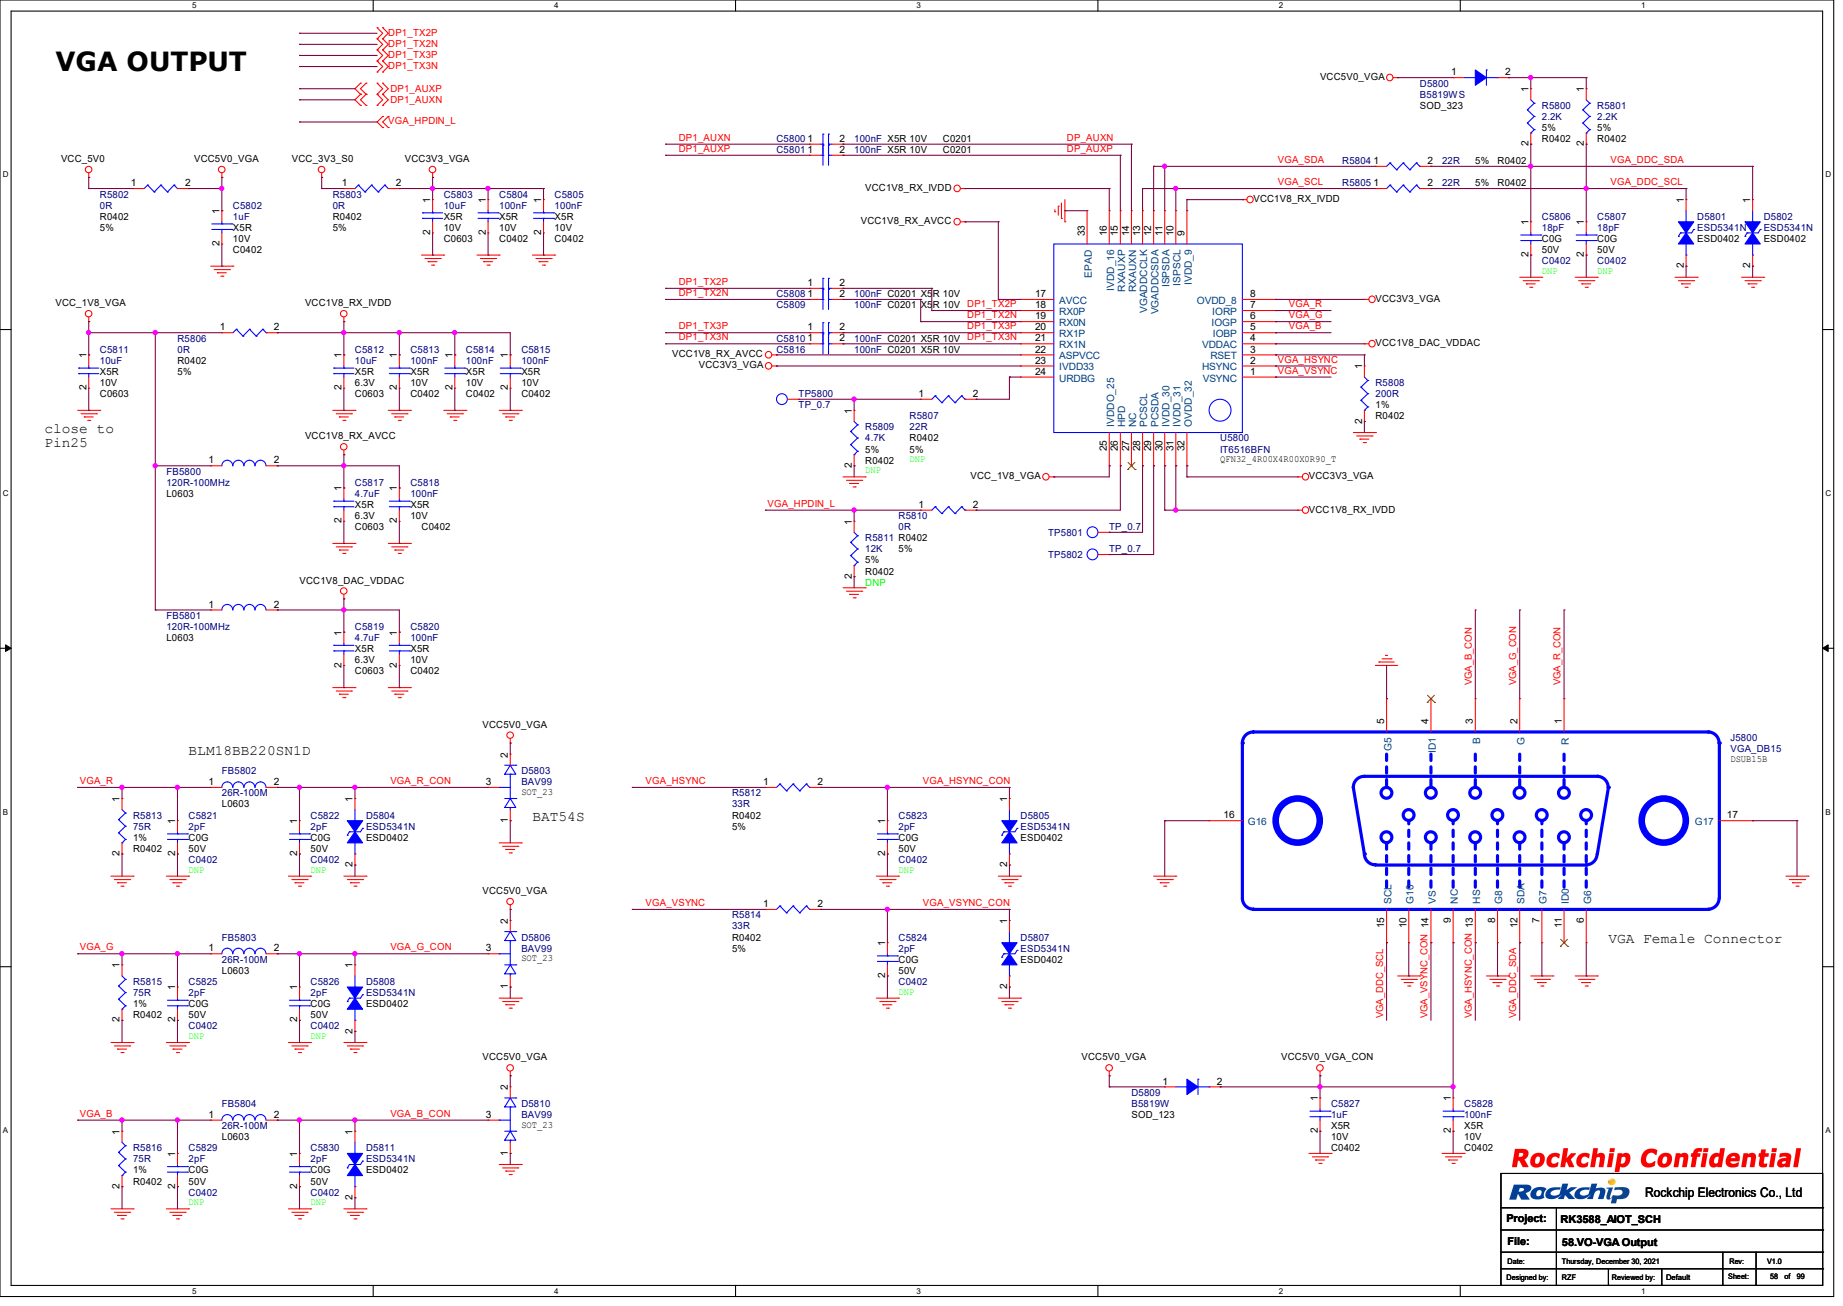
[picture p43: page 43]

9 ISPSCL 10 ISPSDA 11 VGADDCSDA 12 VGADDCCLK 13 RXAUXN 14 RXAUXP 15 IVDD_16 16 AVCC 17 RX0P 18 RX0N 19 RX1P 20 RX1N 21 ASPVCC 22

IOGP 6
IOBP 5
QFN32_4R00X4R00X0R90_T VSYNC 1 HSYNC 2 RSET 3 VDDAC 4

9 G10 10 ID0 11 SDA 12 HS 13 VS 14 SCL 15 G16 16 G17 C5822 17

# Touch Panel connector

## I2C5_SCL_M0_TP

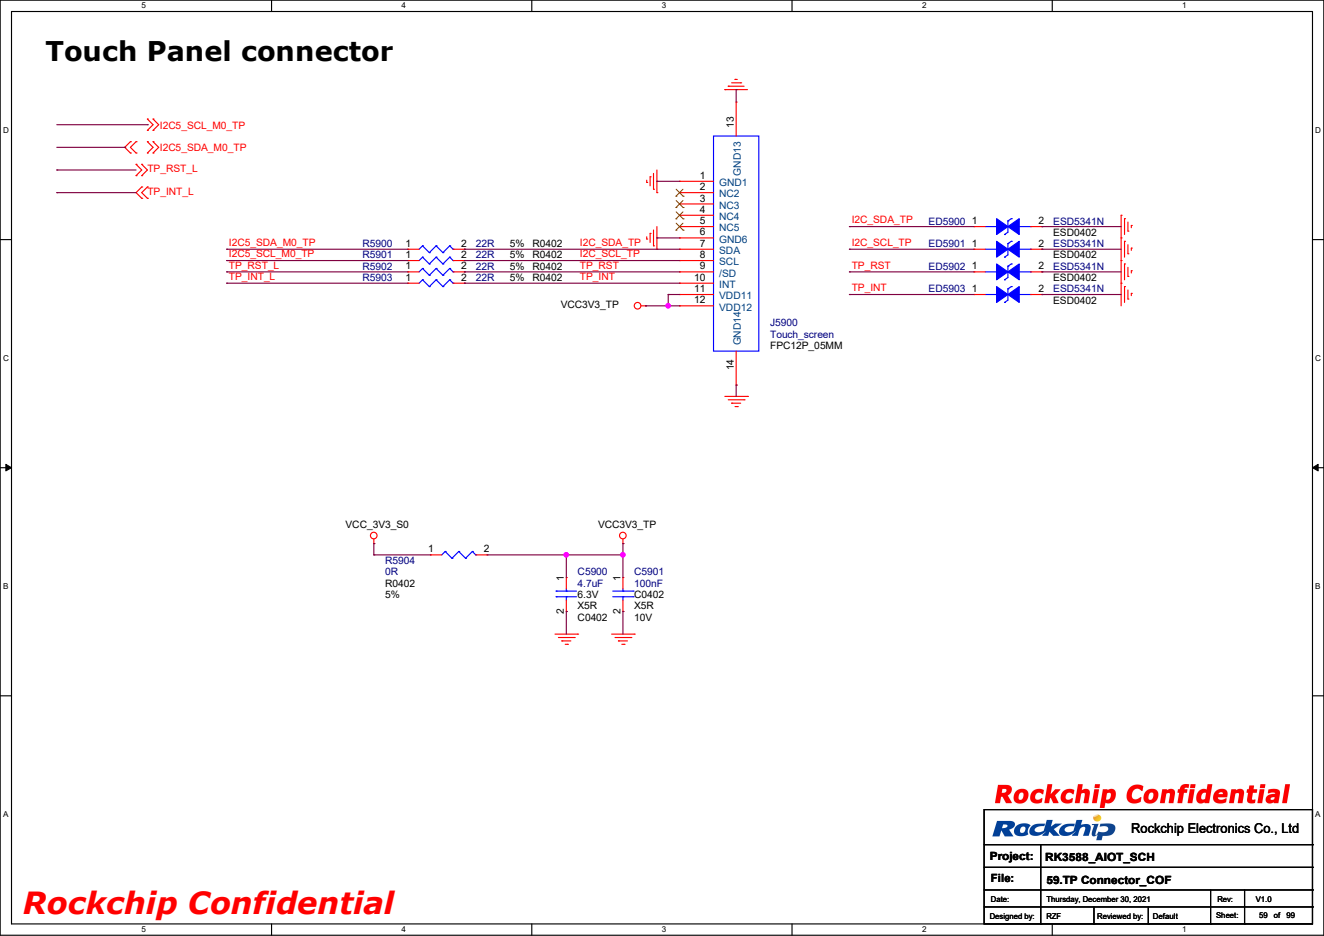
[picture p44: page 44]

# 50 Ohm RF trace

# Note:

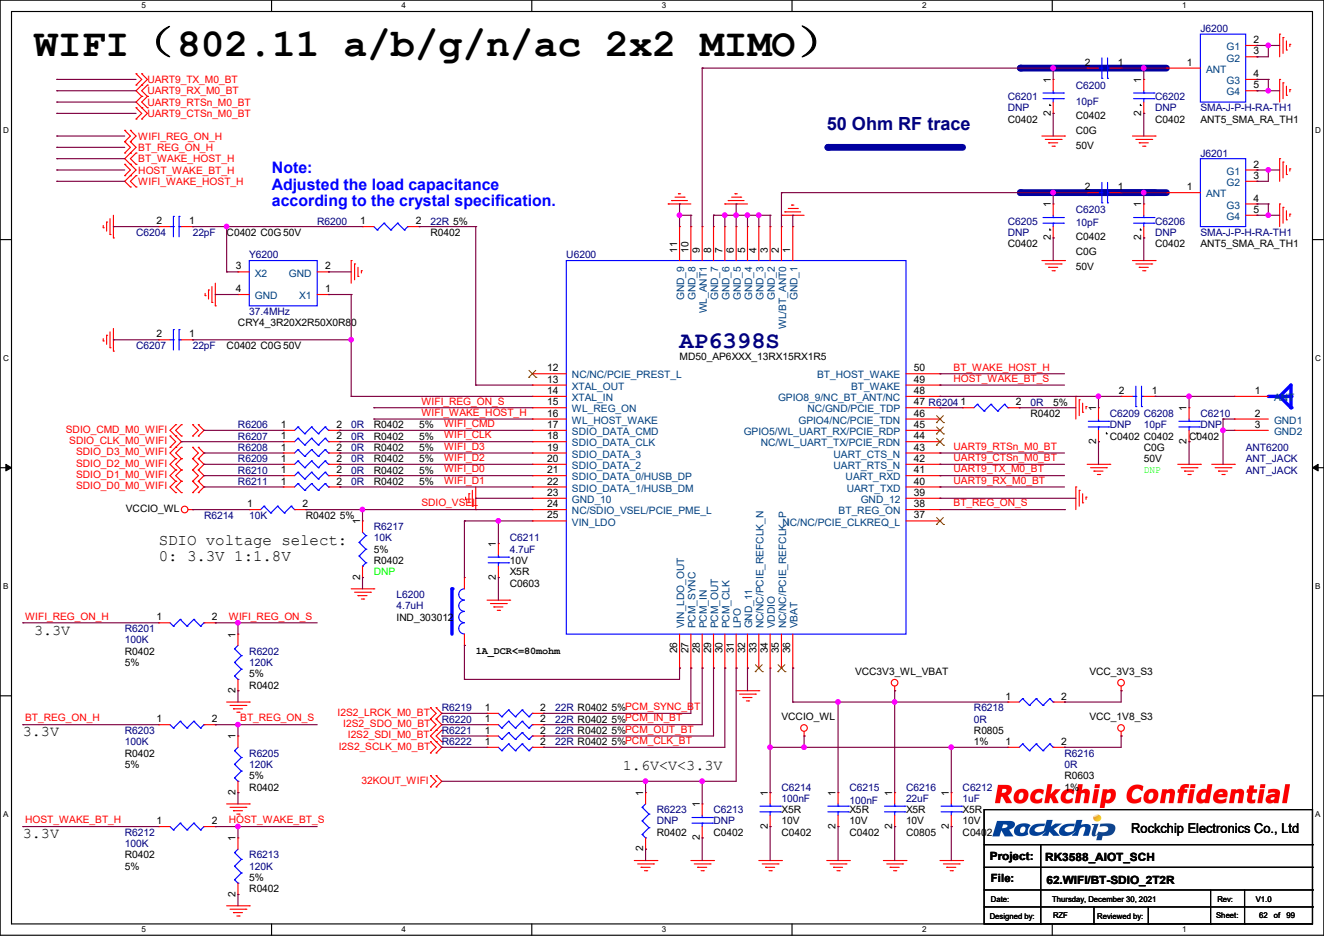
[picture p45: page 45]

Adjusted the load capacitance
according to the crystal specification.

2 NC/NC/PCIE_CLKREQ_L 37 NC/NC/PCIE_REFCLK_P 35

GPIO5/WL_UART_RX/PCIE_RDP 45 GPIO4/NC/PCIE_TDN 46 NC/GND/PCIE_TDP 47 GPIO8_9/NC_BT_ANT/NC 48 BT_WAKE 49 BT_HOST_WAKE 50

# 50 Ohm RF trace

# PCIe WIFI6/BT Module-2T2R

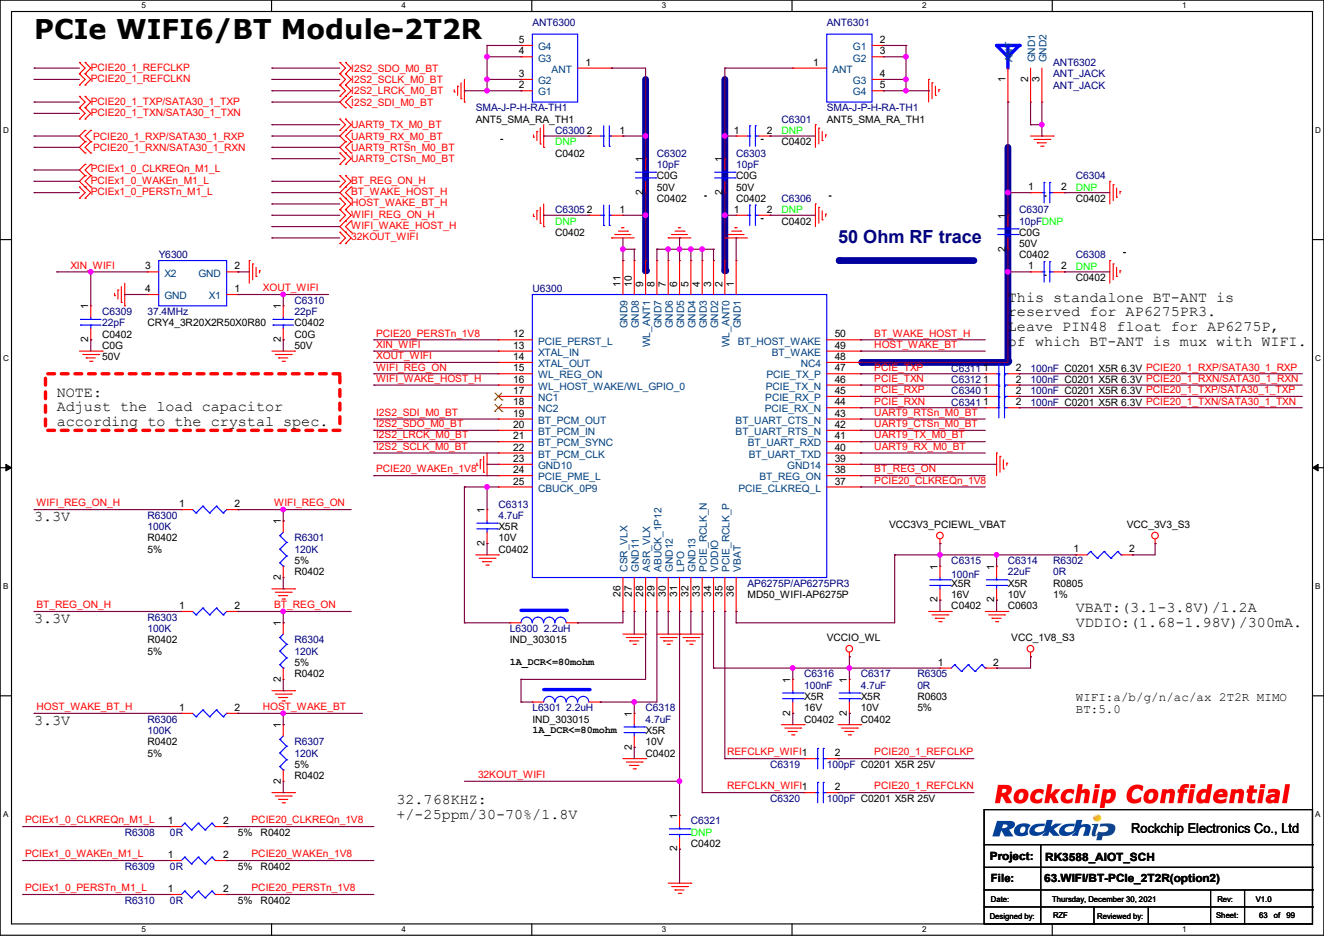
[picture p46: page 46]

NOTE:
Adjust the load capacitor
according to the crystal spec.

WIFI:a/b/g/n/ac/ax 2T2R MIMO

# RMII

## High-tension

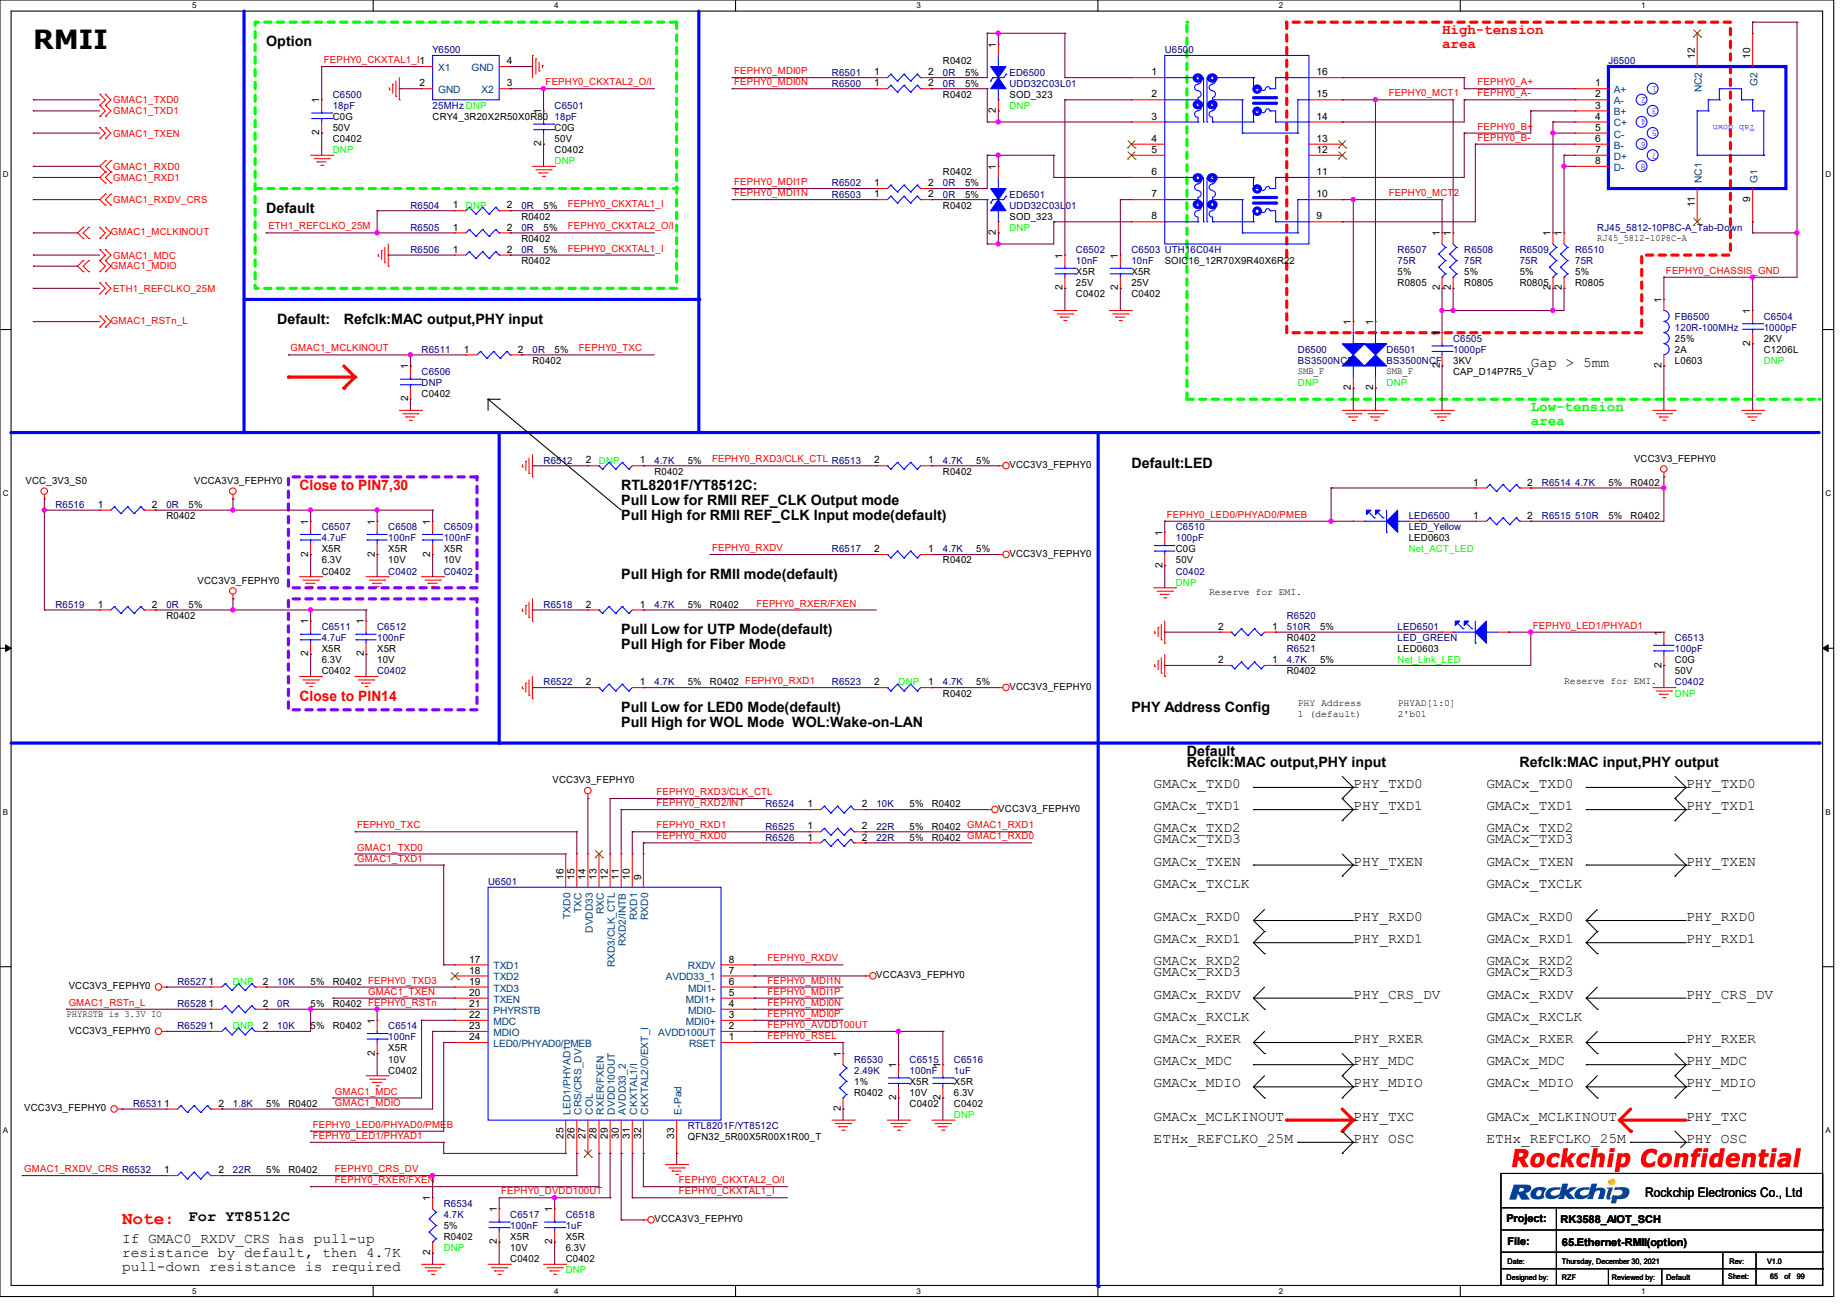
[picture p47: page 47]

Refclk:MAC output,PHY input

RTL8201F/YT8512C:
Pull Low for RMII REF_CLK Output mode
Pull High for RMII REF_CLK Input mode(default)

Pull High for RMII mode(default)

Pull Low for UTP Mode(default)
Pull High for Fiber Mode

Pull Low for LED0 Mode(default)
Pull High for WOL Mode WOL:Wake-on-LAN

9 RXD1 10 RXD2/INTB 11 RXD3/CLK_CTL 12 RXC 13 DVDD33 14 TXC 15 TXD0 16 TXD1 17 TXD2 18 TXD3 19 TXEN 20 PHYRSTB 21 MDC 22 MDIO 23

Note: For YT8512C
If GMAC0_RXDV_CRS has pull-up
resistance by default, then 4.7K
pull-down resistance is required

## MAC <----- PHY

## 3.3Vpp

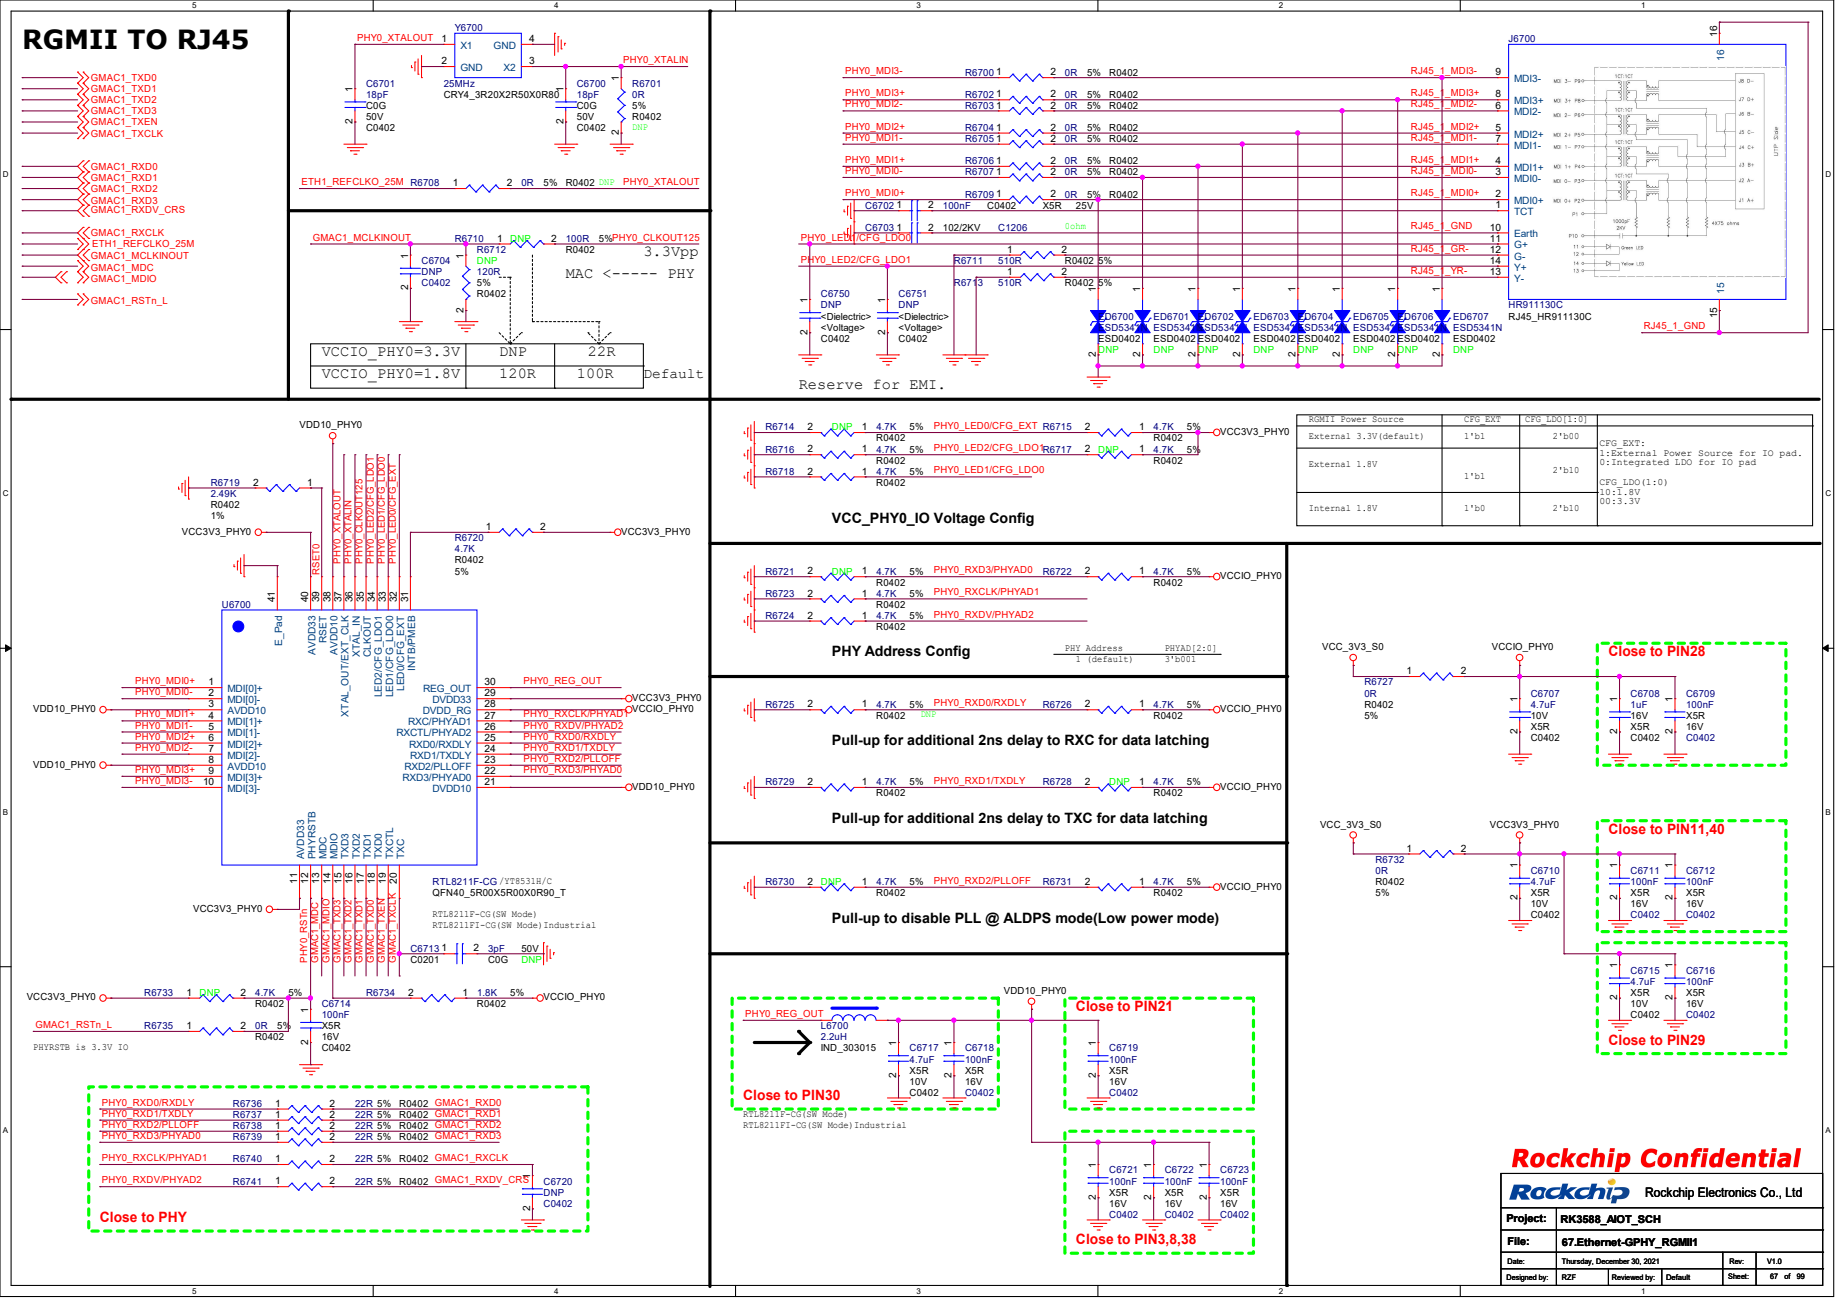
[picture p48: page 48]

Close to PIN28 RTL8211F-CG(SW Mode)

Pull-up for additional 2ns delay to RXC for data latching

Pull-up for additional 2ns delay to TXC for data latching RTL8211F-CG(SW Mode)

RTL8211FI-CG(SW Mode)Industrial

Pull-up to disable PLL @ ALDPS mode(Low power mode)

# PCIE TO RJ45

# 3.3V IO

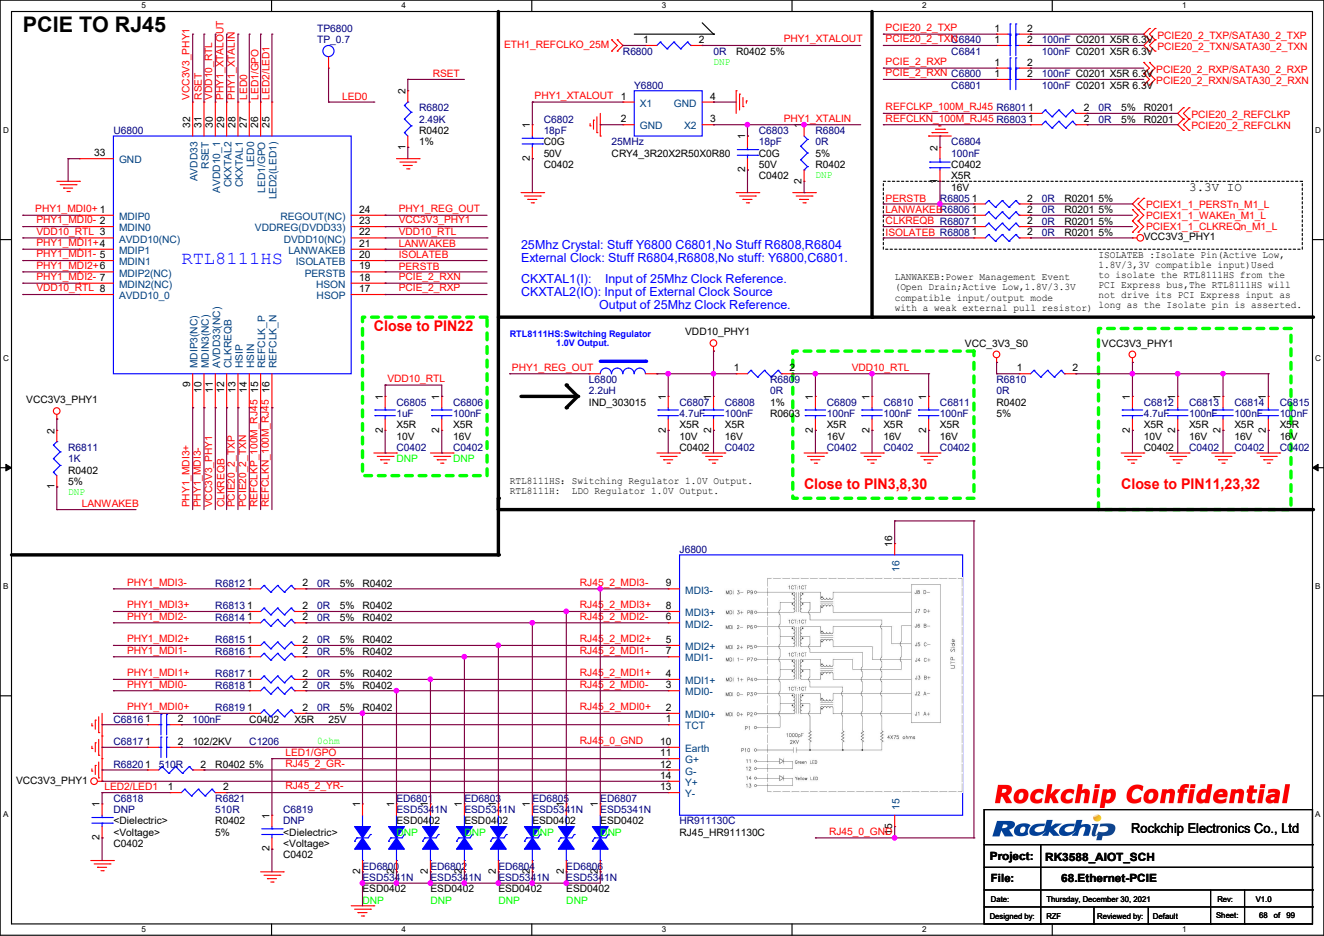
[picture p49: page 49]

VDDREG(DVDD33) 23 LED²⁽LED¹⁾ ²⁵

25Mhz Crystal: Stuff Y6800 C6801,No Stuff R6808,R6804
External Clock: Stuff R6804,R6808,No stuff: Y6800,C6801.
CKXTAL1(I): Input of 25Mhz Clock Reference.
CKXTAL2(IO): Input of External Clock Source

ISOLATEB :Isolate Pin(Active Low,
1.8V/3,3V compatible input)Used
to isolate the RTL8111HS from the
PCI Express bus,The RTL8111HS will
not drive its PCI Express input as
long as the Isolate pin is asserted.

LANWAKEB:Power Management Event
(Open Drain;Active Low,1.8V/3.3V
compatible input/output mode
with a weak external pull resistor)

Output of 25Mhz Clock Reference.

# CODEC ES8388

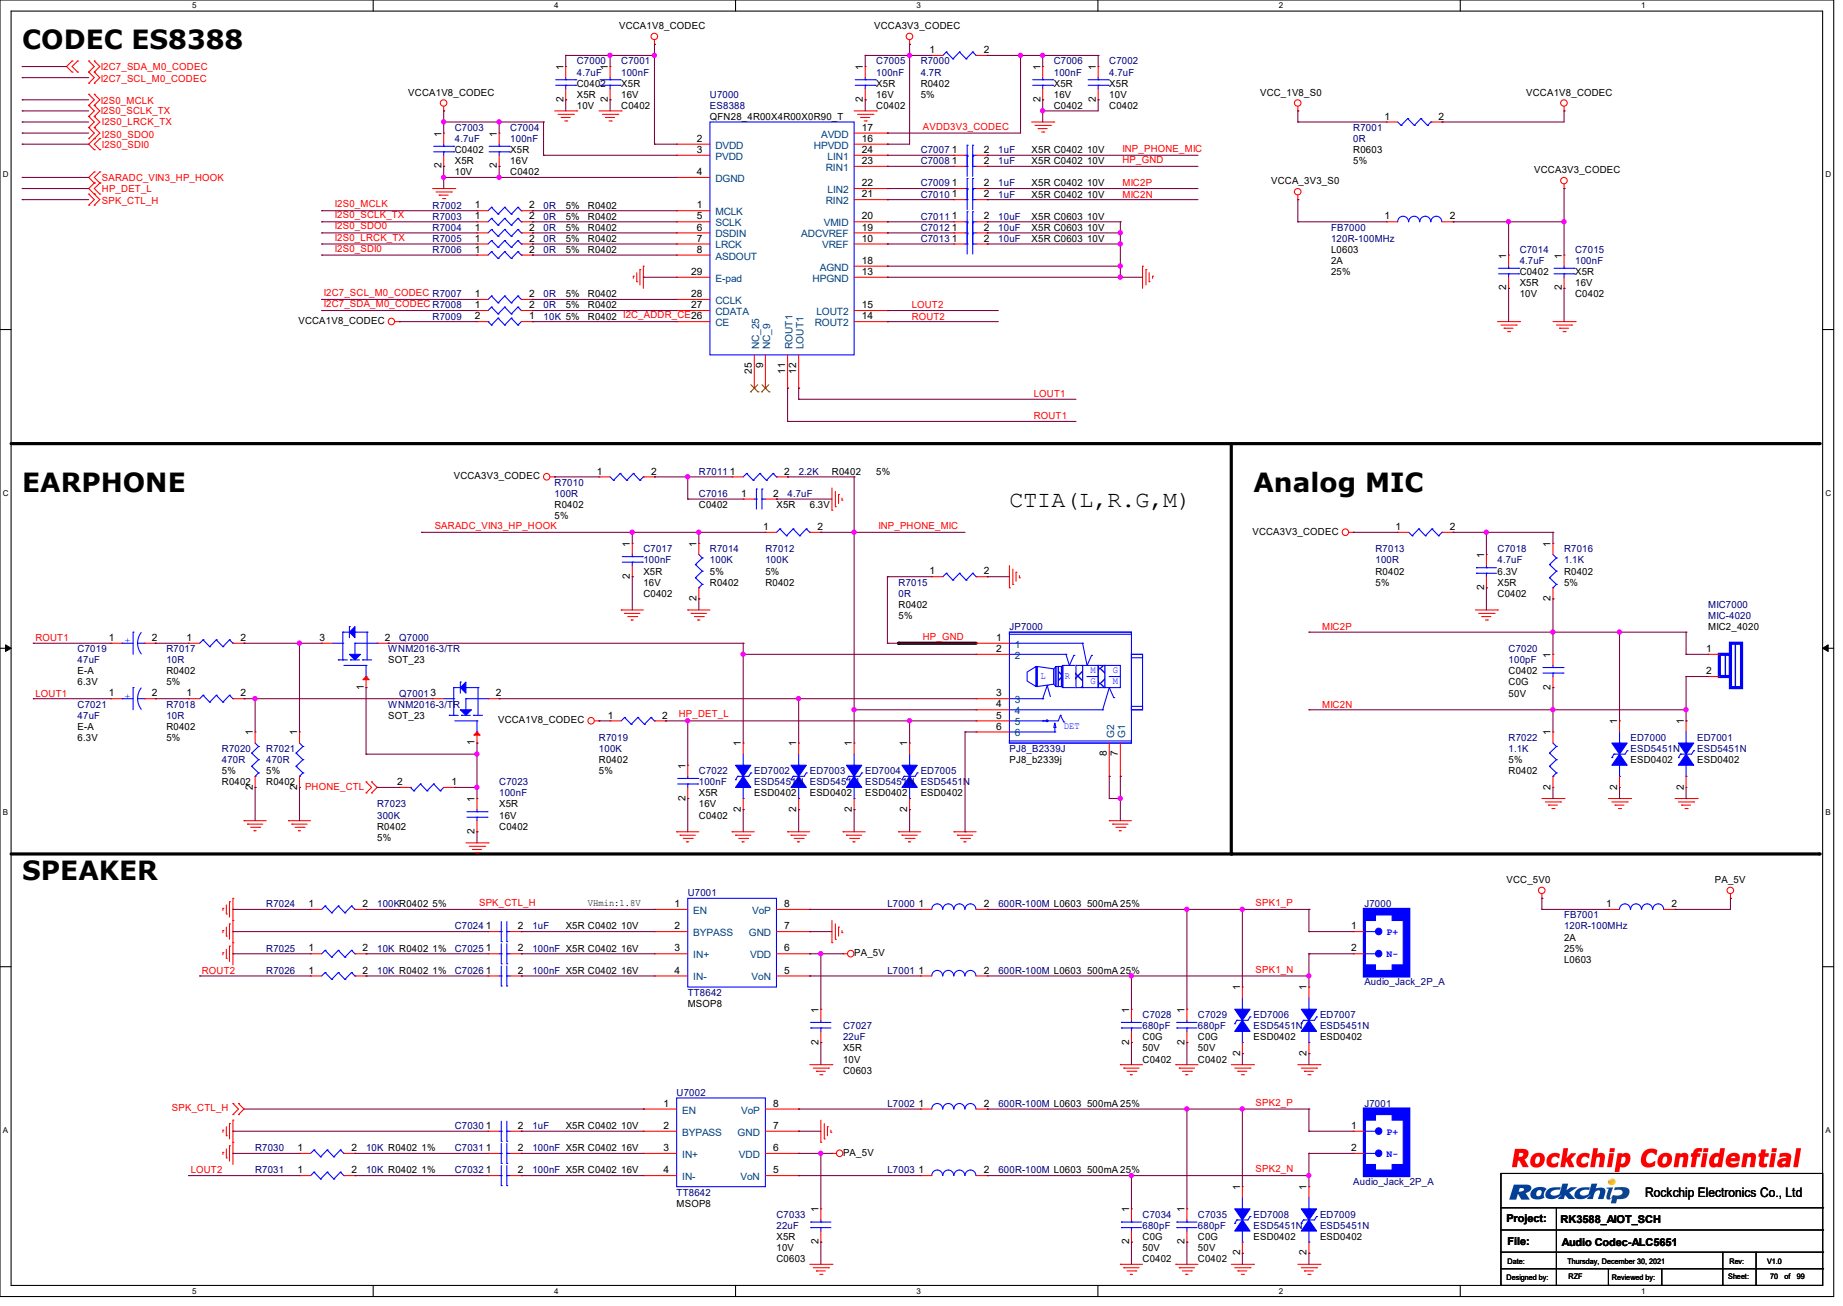
[picture p50: page 50]

1 2 U7000 ES8388 QFN28_4R00X4R00X0R90_T MCLK 1 DVDD 2 PVDD 3 DGND 4 SCLK 5 DSDIN 6

9 VREF 10 ROUT1 11 LOUT1 12 ROUT2 14 LOUT2 15 HPVDD 16 AVDD 17 AGND 18 ADCVREF 19 VMID 20 RIN2 21 LIN2 22

HP_DET_L | 4 4

# CODEC ALC5651

## close pin 9 close pin 18

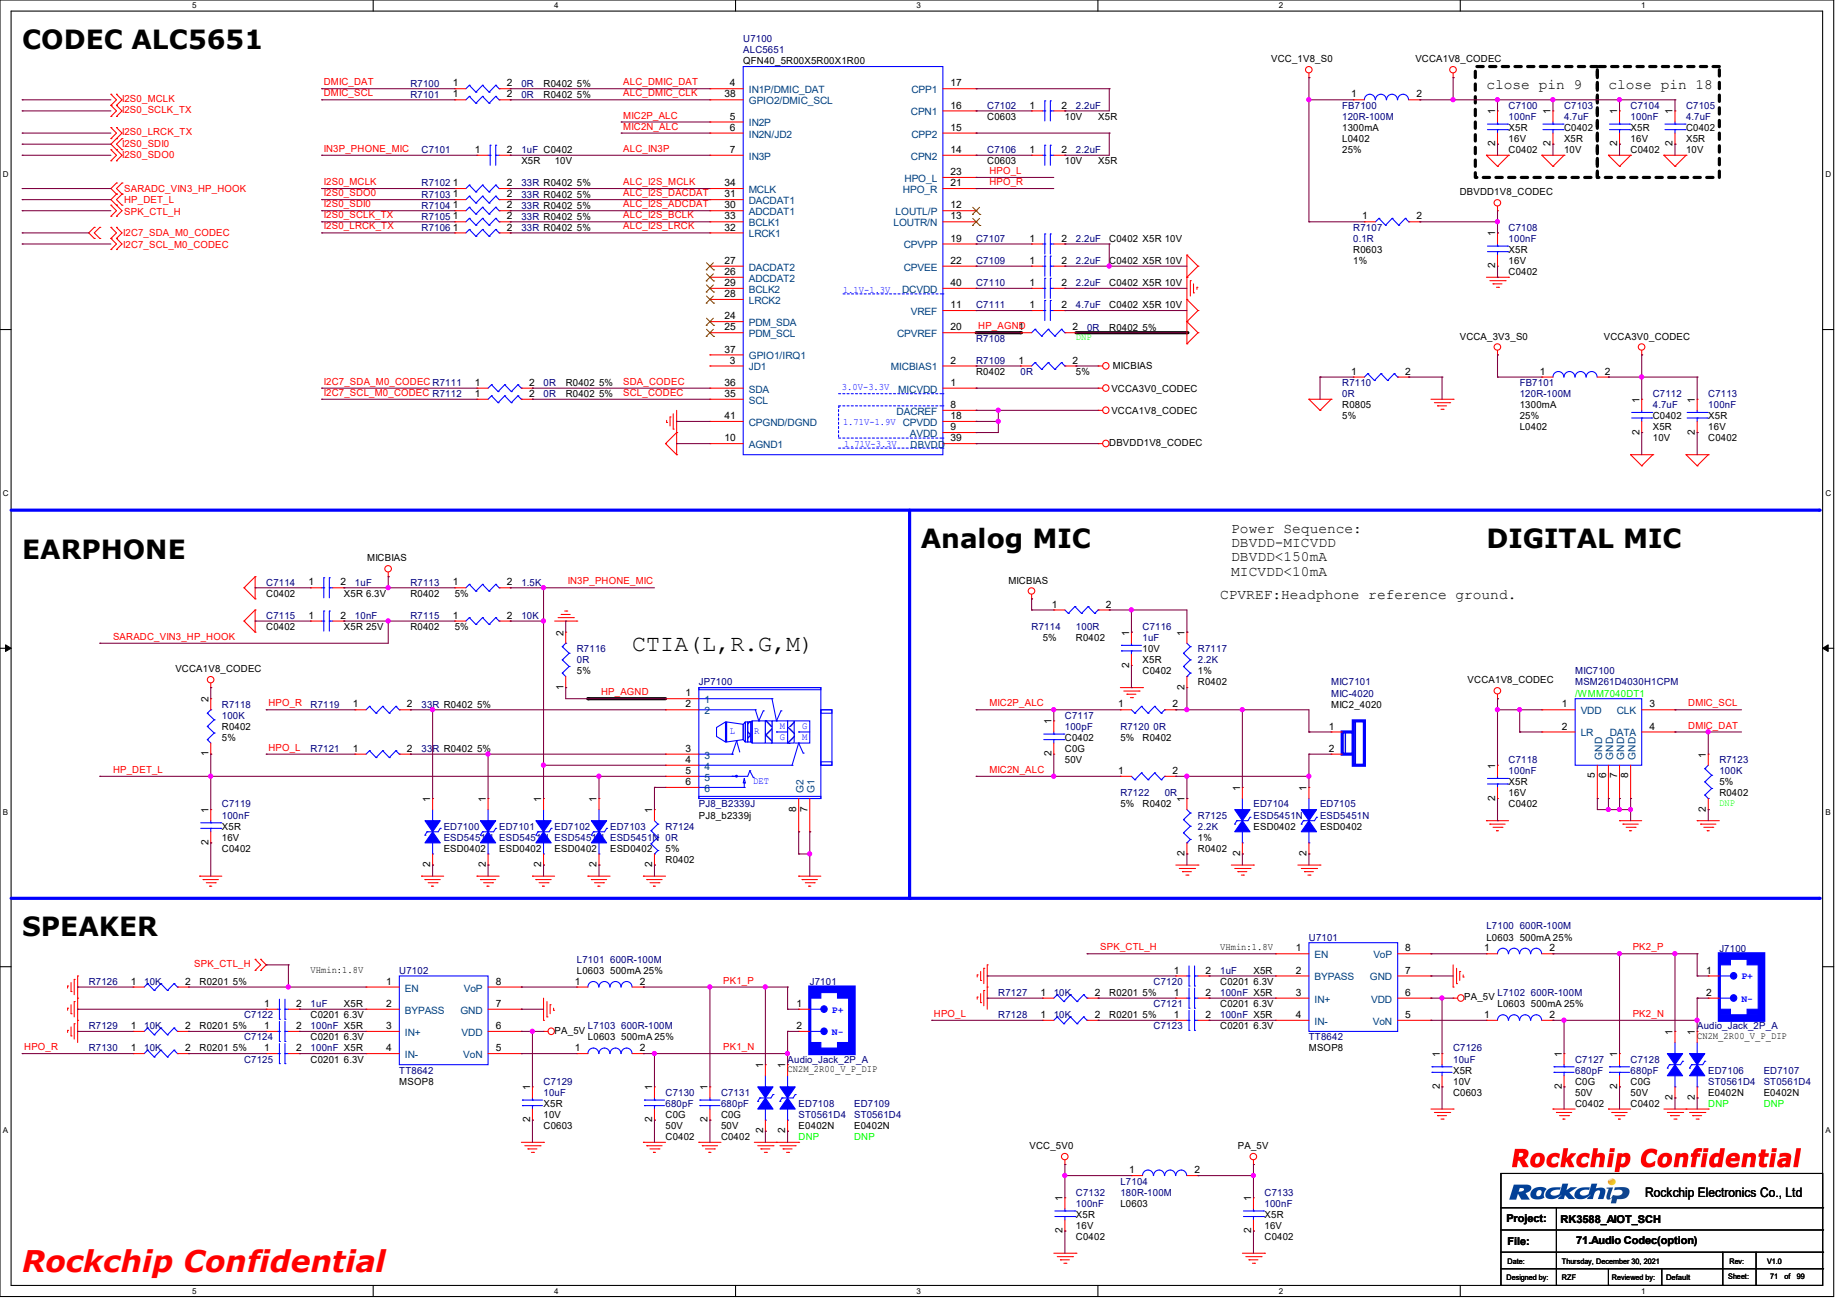
[picture p51: page 51]

LOUTR/N 13 CPN2 14 CPP2 15 CPN1 16 CPP1 17 CPVDD 18 CPVPP 19 CPVREF 20 HPO_R 21 CPVEE 22 HPO_L 23 PDM_SDA 24 PDM_SCL 25 ADCDAT2 26 DACDAT2 27

Power Sequence:
DBVDD-MICVDD
DBVDD<150mA
MICVDD<10mA
CPVREF:Headphone reference ground.

# PCIe3.0 x 4 Slot

# Option:

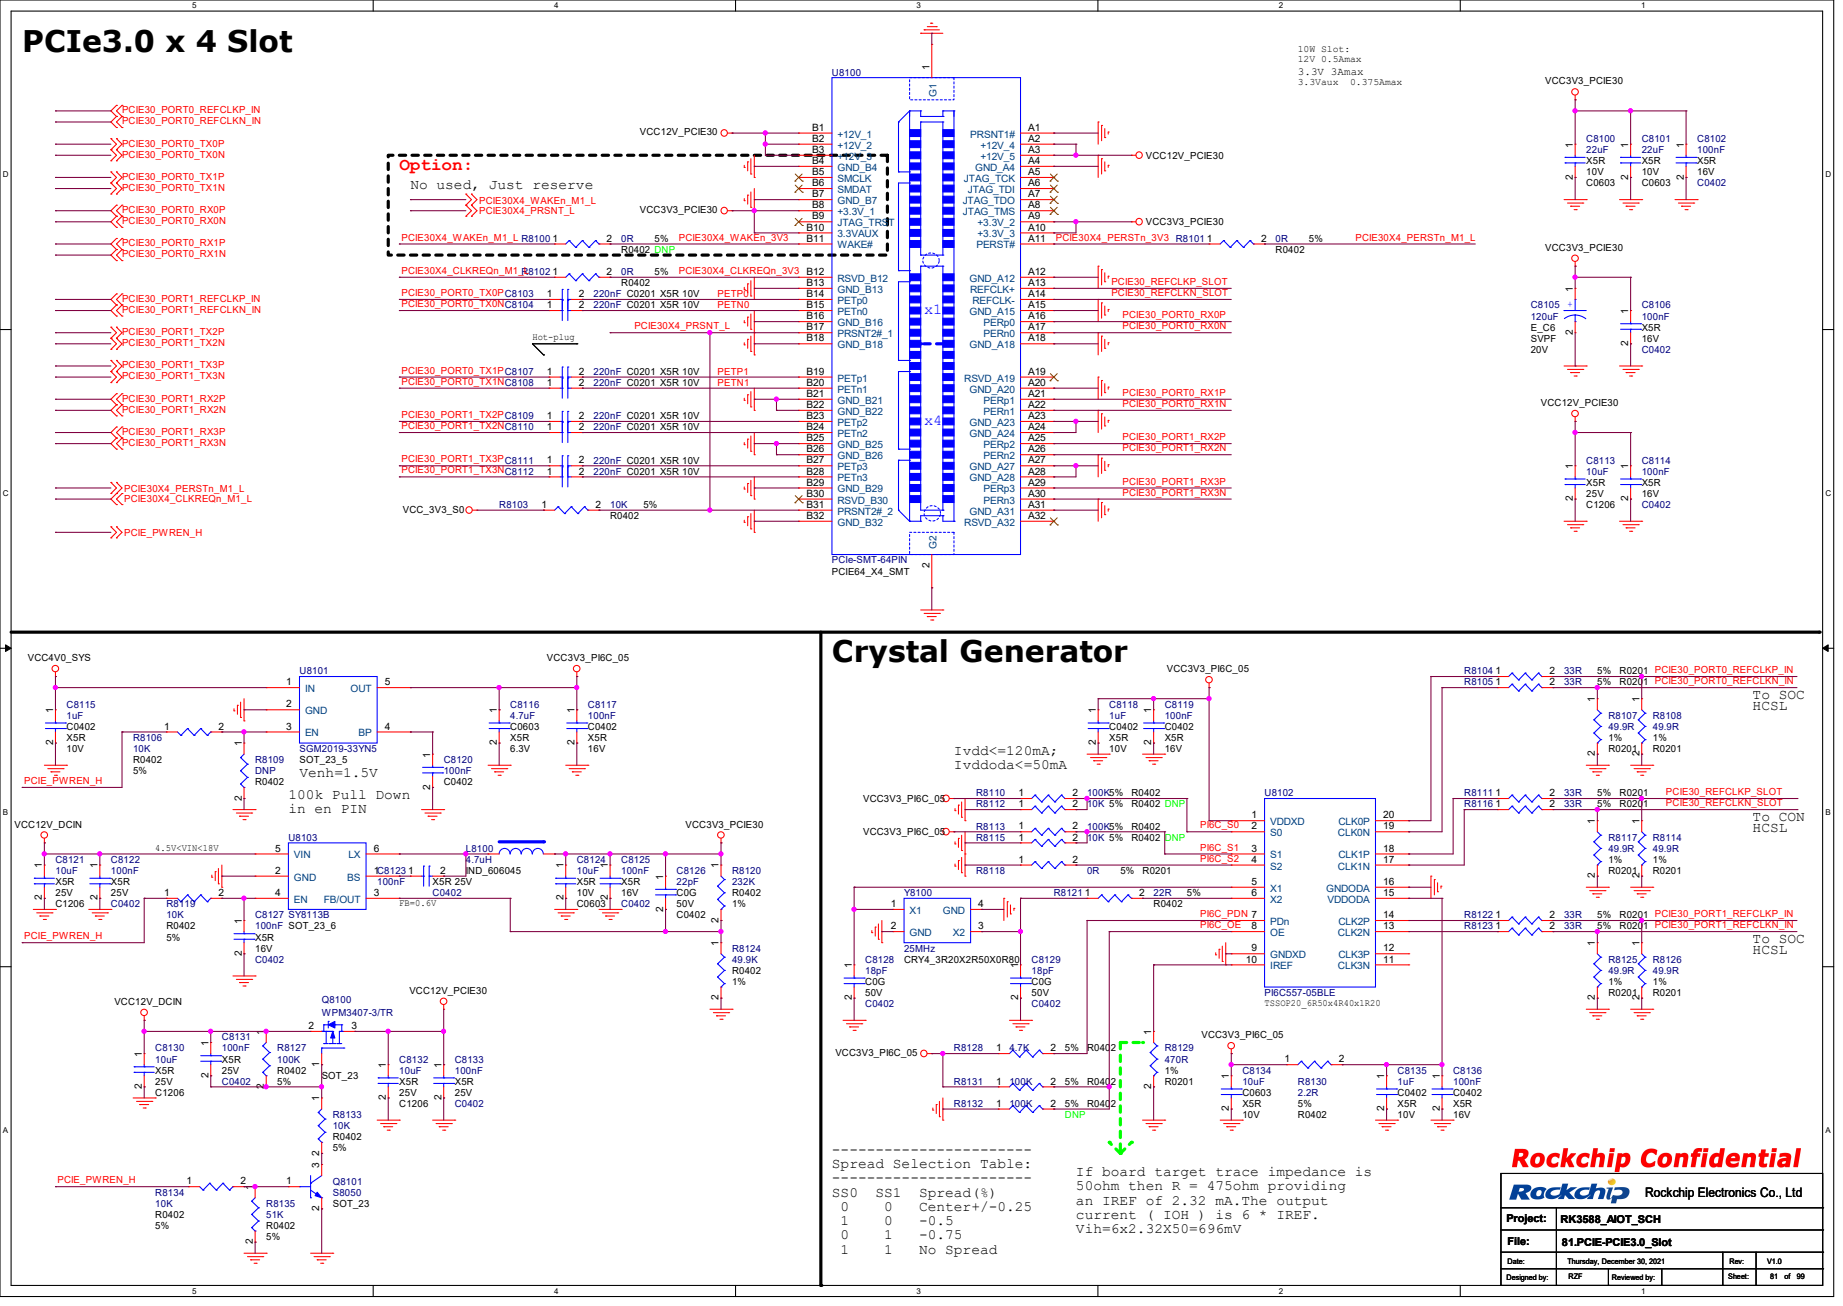
[picture p52: page 52]

No used, Just reserve

TSSOP20_6R50x4R40x1R20 VDDXD 1 S0 2 S1 3 S2 4 X1 5 X2 6 PDn 7 OE 8 GNDXD 9

A A If board target trace impedance is

50ohm then R = 475ohm providing
an IREF of 2.32 mA.The output
current ( IOH ) is 6 * IREF.
Vih=6x2.32X50=696mV

# SATA3.0

## PCIE20_0_TXP/SATA30_0_TXP

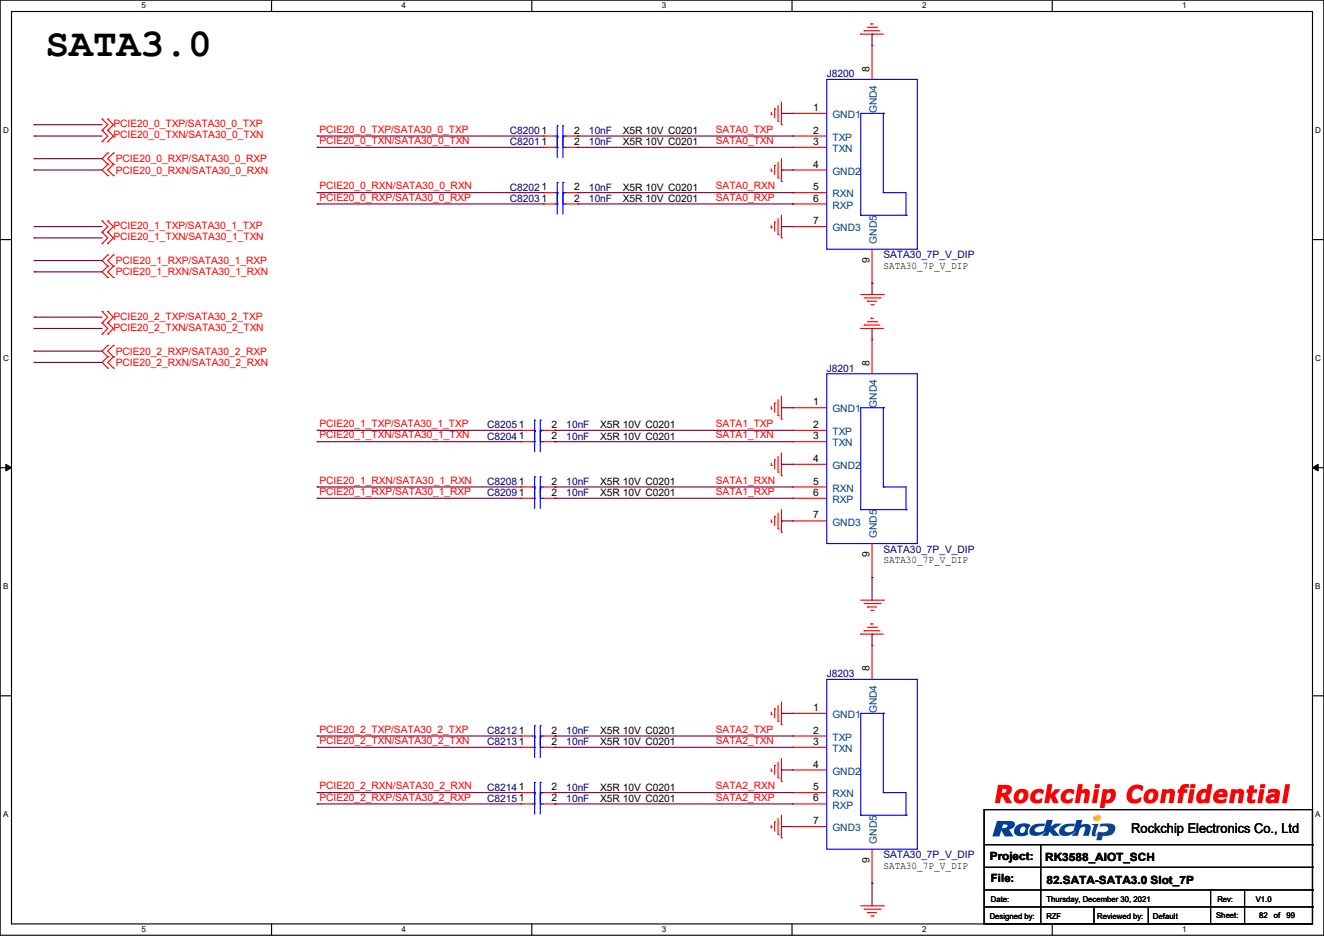
[picture p53: page 53]

# SATA PM

## Need a gpio for the

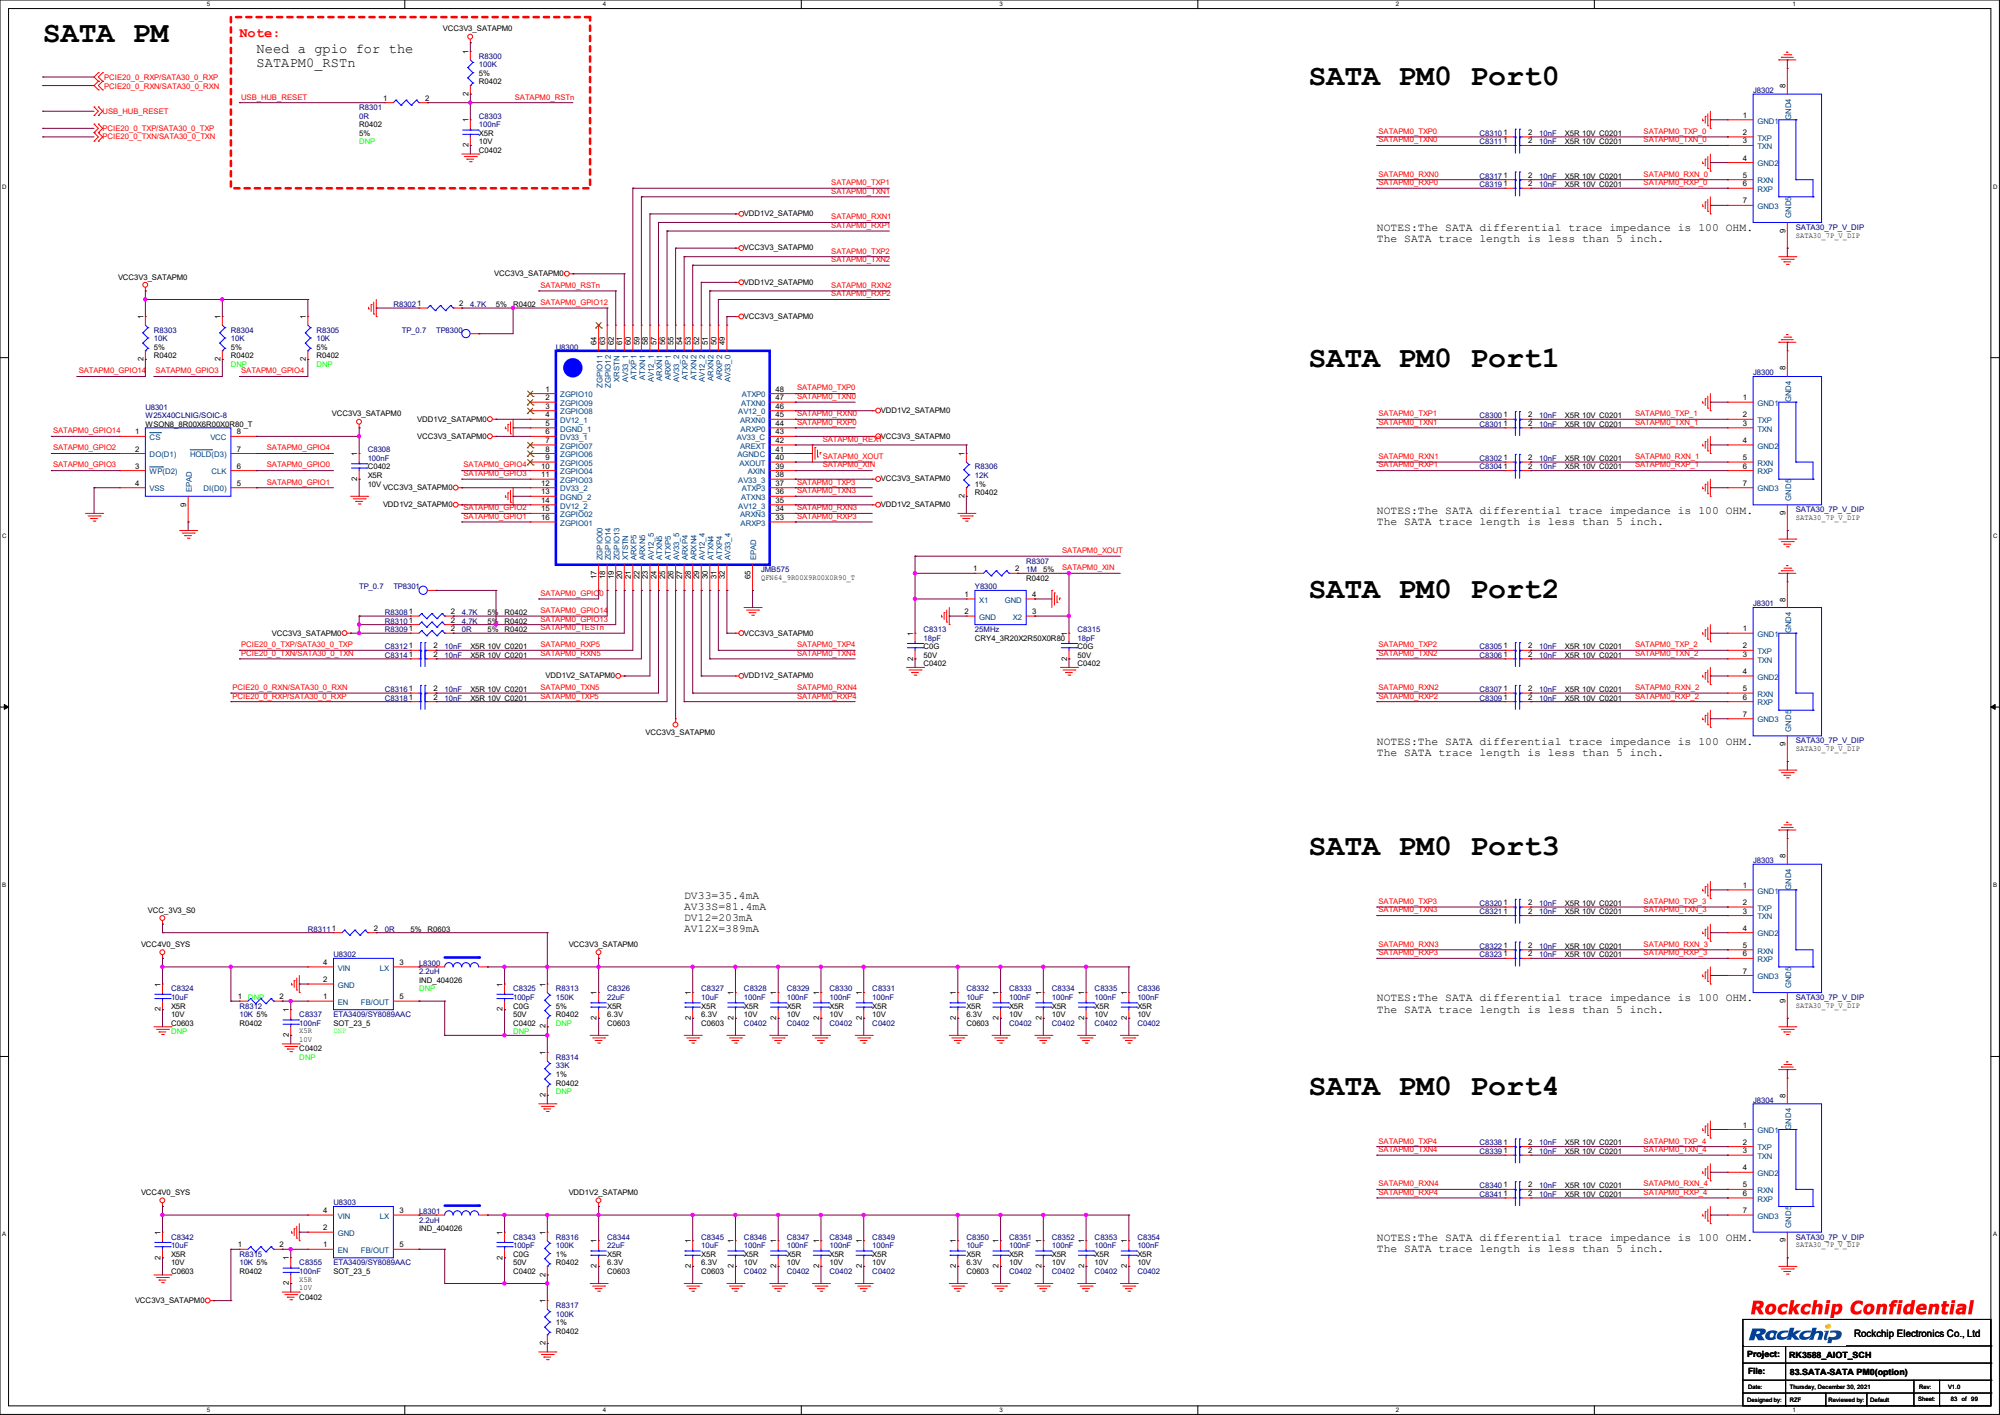
[picture p54: page 54]

SATA PM0 Port0 NOTES:The SATA differential trace impedance is 100 OHM.

The SATA trace length is less than 5 inch.

SATA PM0 Port1 NOTES:The SATA differential trace impedance is 100 OHM.

SATA PM0 Port2 NOTES:The SATA differential trace impedance is 100 OHM.

SATA PM0 Port3 NOTES:The SATA differential trace impedance is 100 OHM.

SATA PM0 Port4 NOTES:The SATA differential trace impedance is 100 OHM.

# Gnd

## SMTS02046CTJ

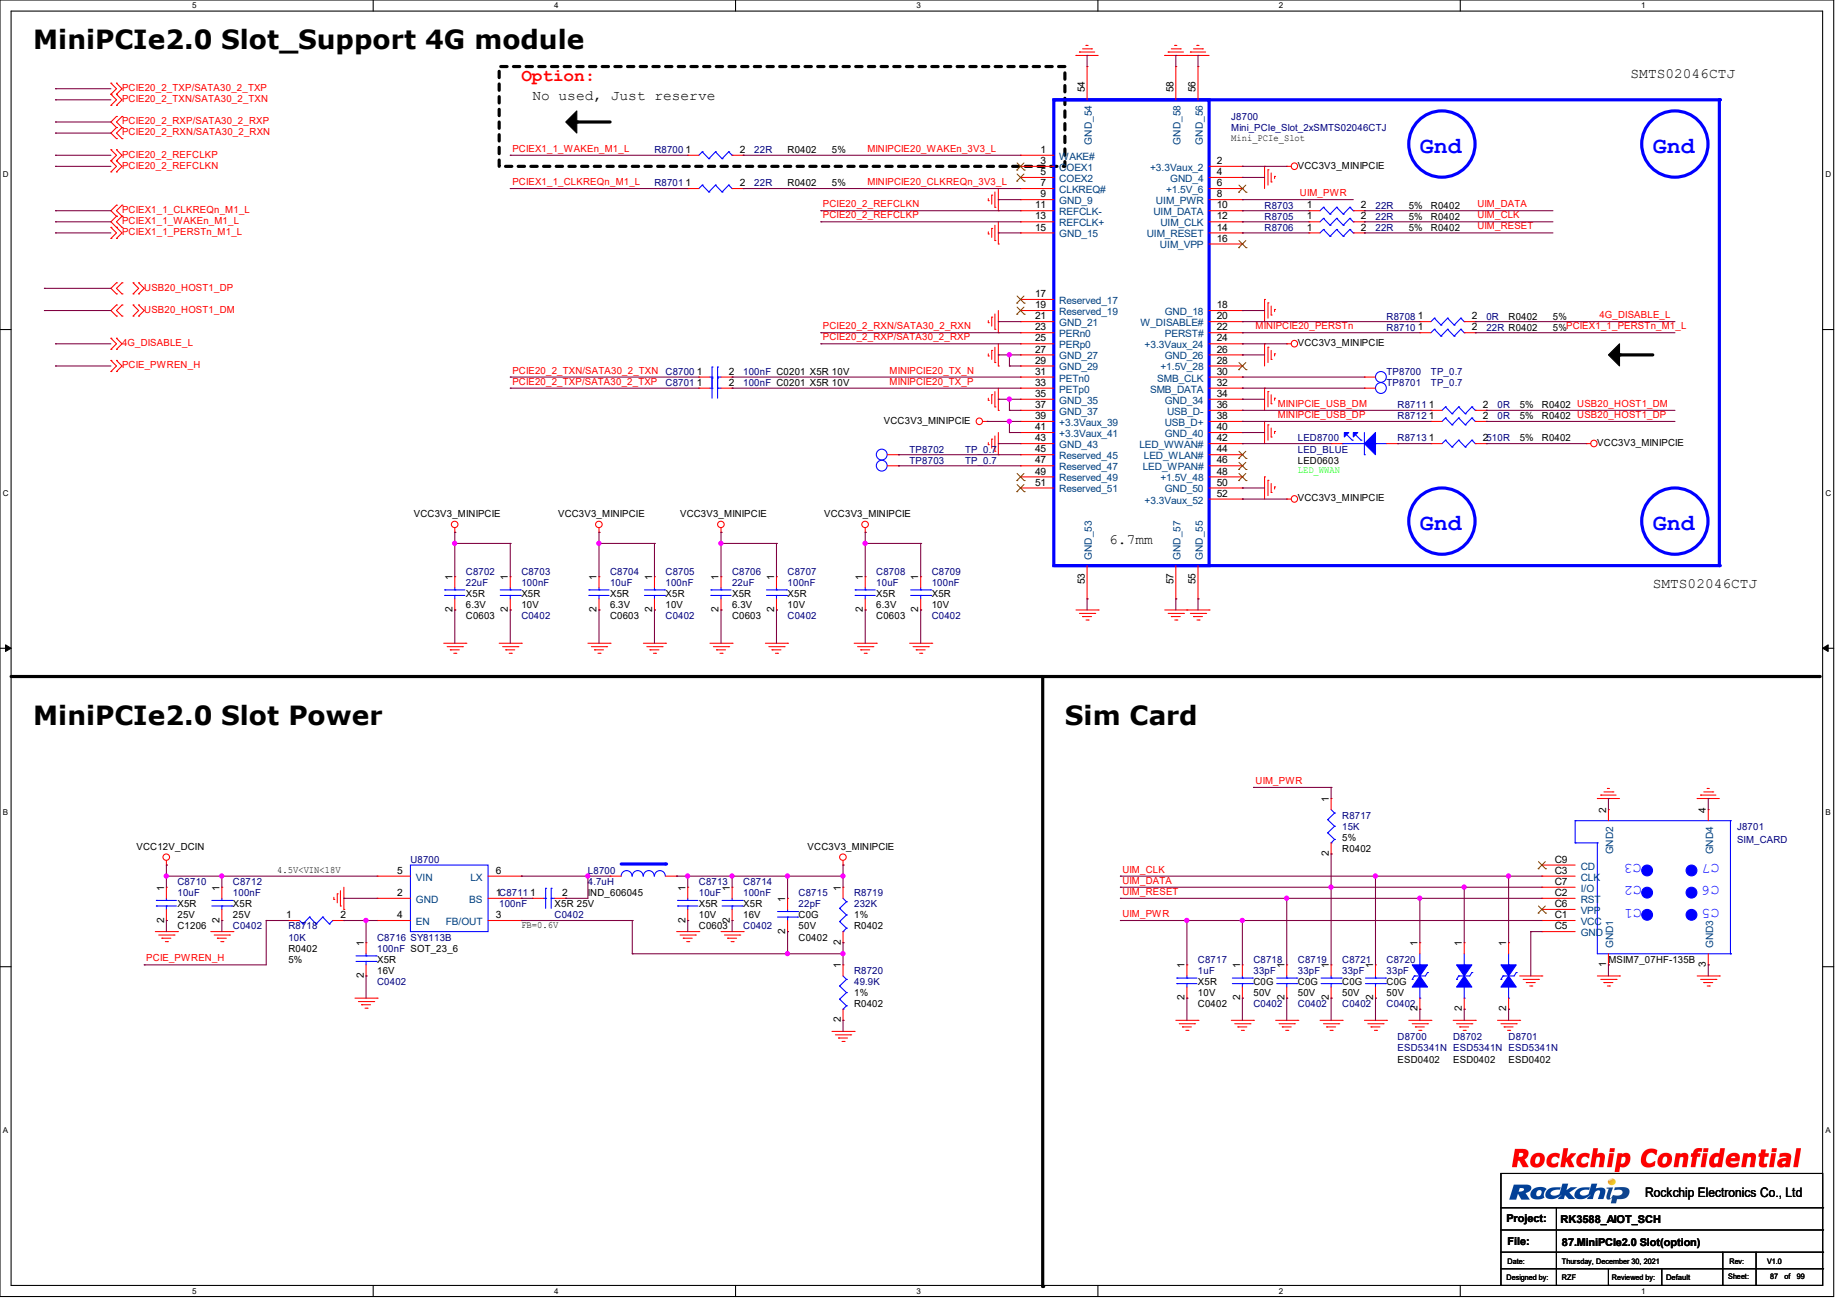
[picture p55: page 55]

Option:
No used, Just reserve

VCC C1 RST C2 CLK C3 GND C5 VPP C6

# M.2_PCIe3.0 x 2Lanes

# 75 GND_76

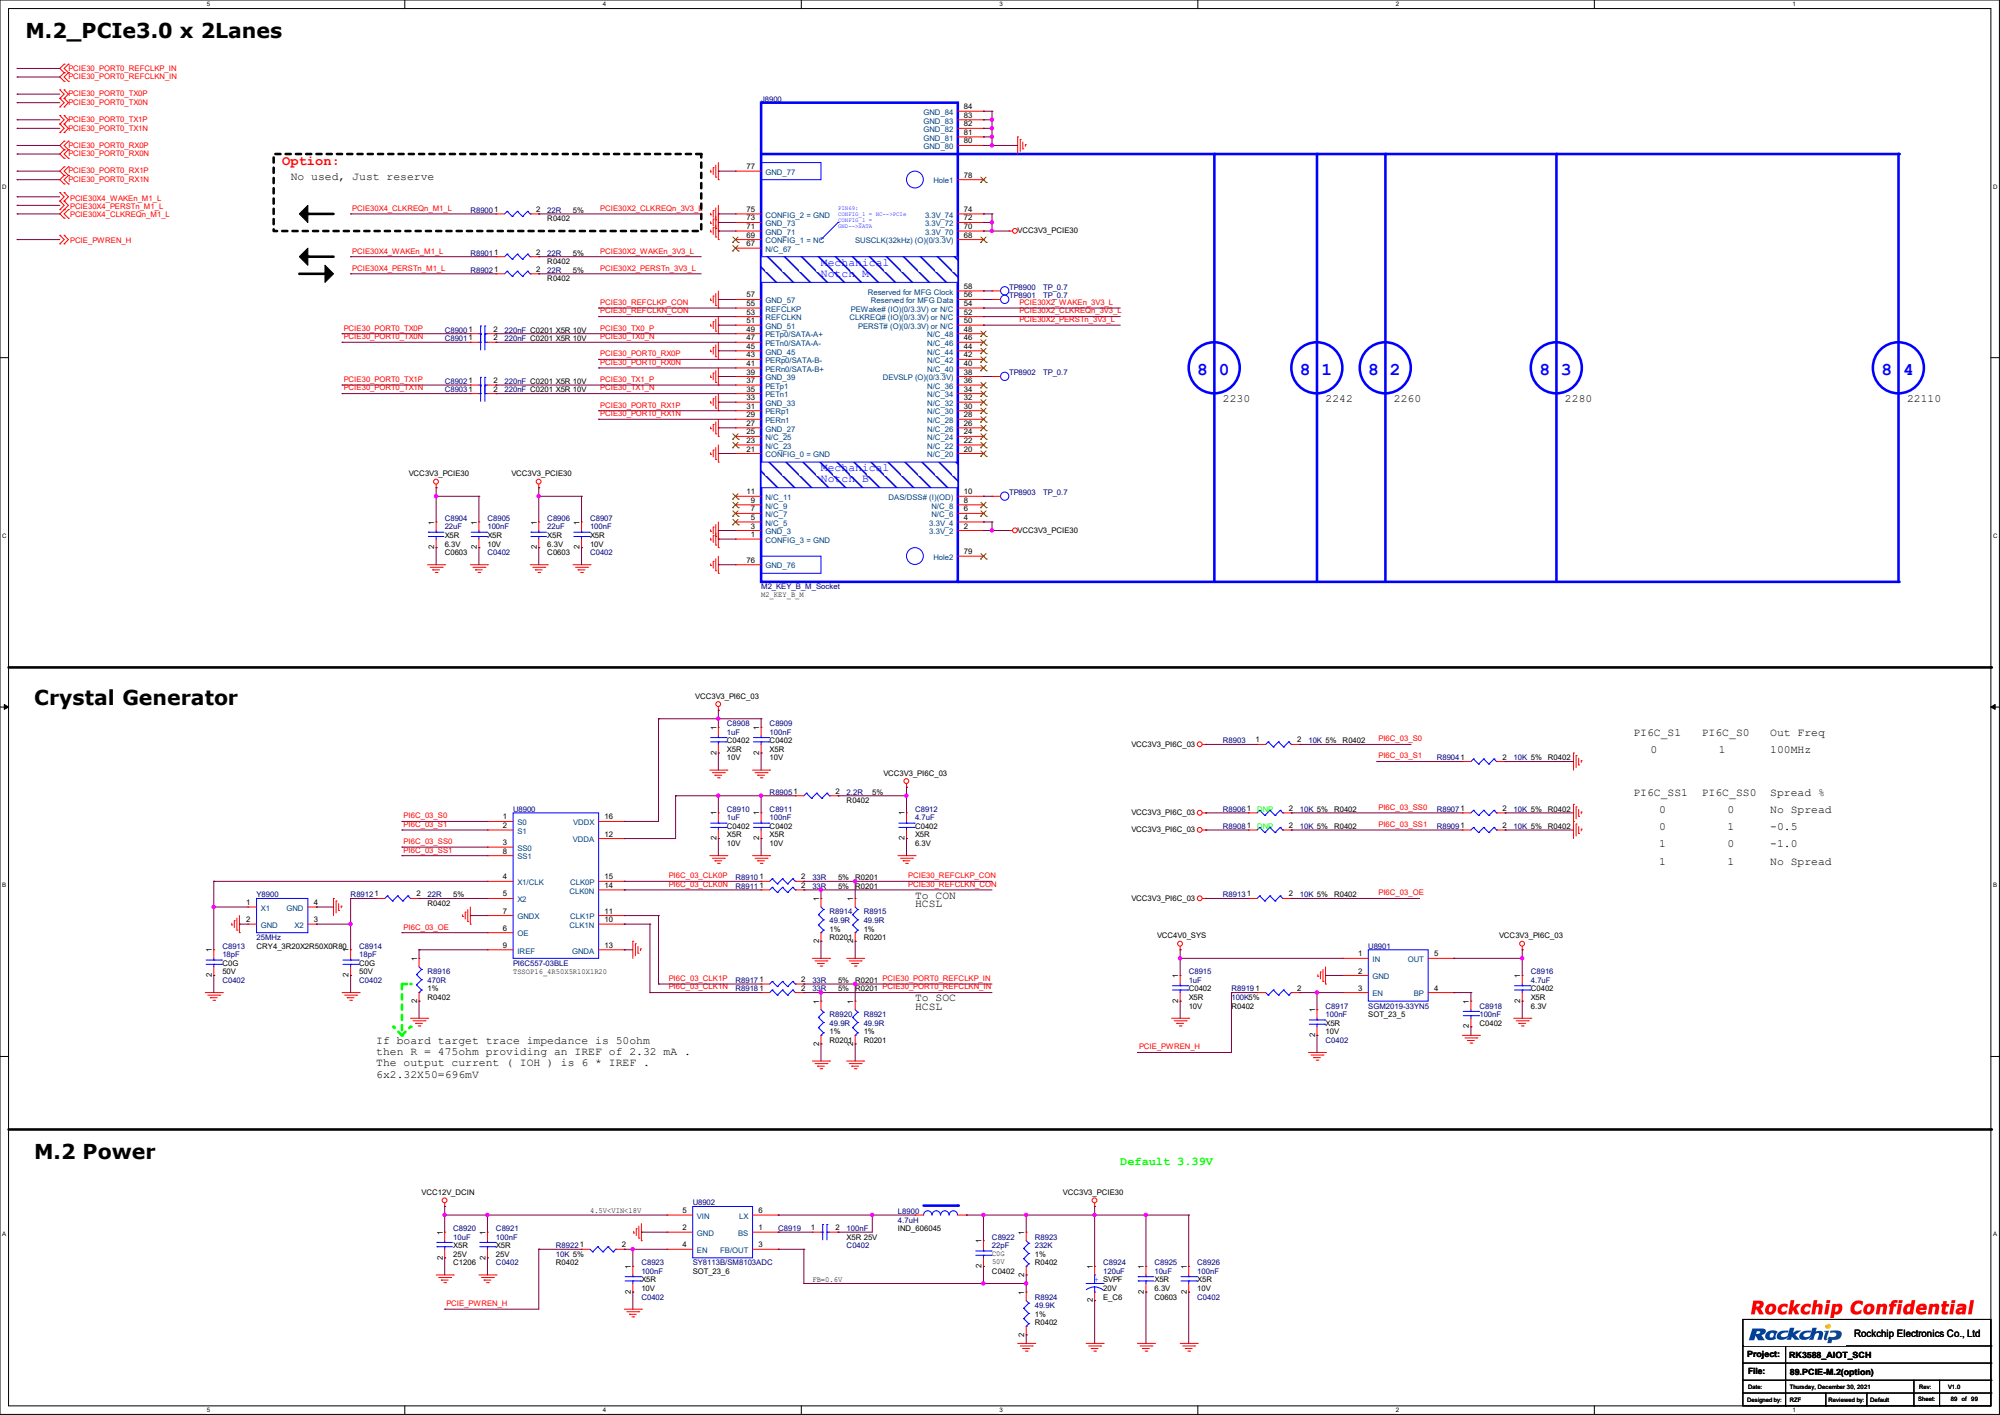
[picture p56: page 56]

Option: No used, Just reserve

If board target trace impedance is 50ohm
then R = 475ohm providing an IREF of 2.32 mA .
The output current ( IOH ) is 6 * IREF .

# Ambient Light+Proximity Sensor

# Sensor

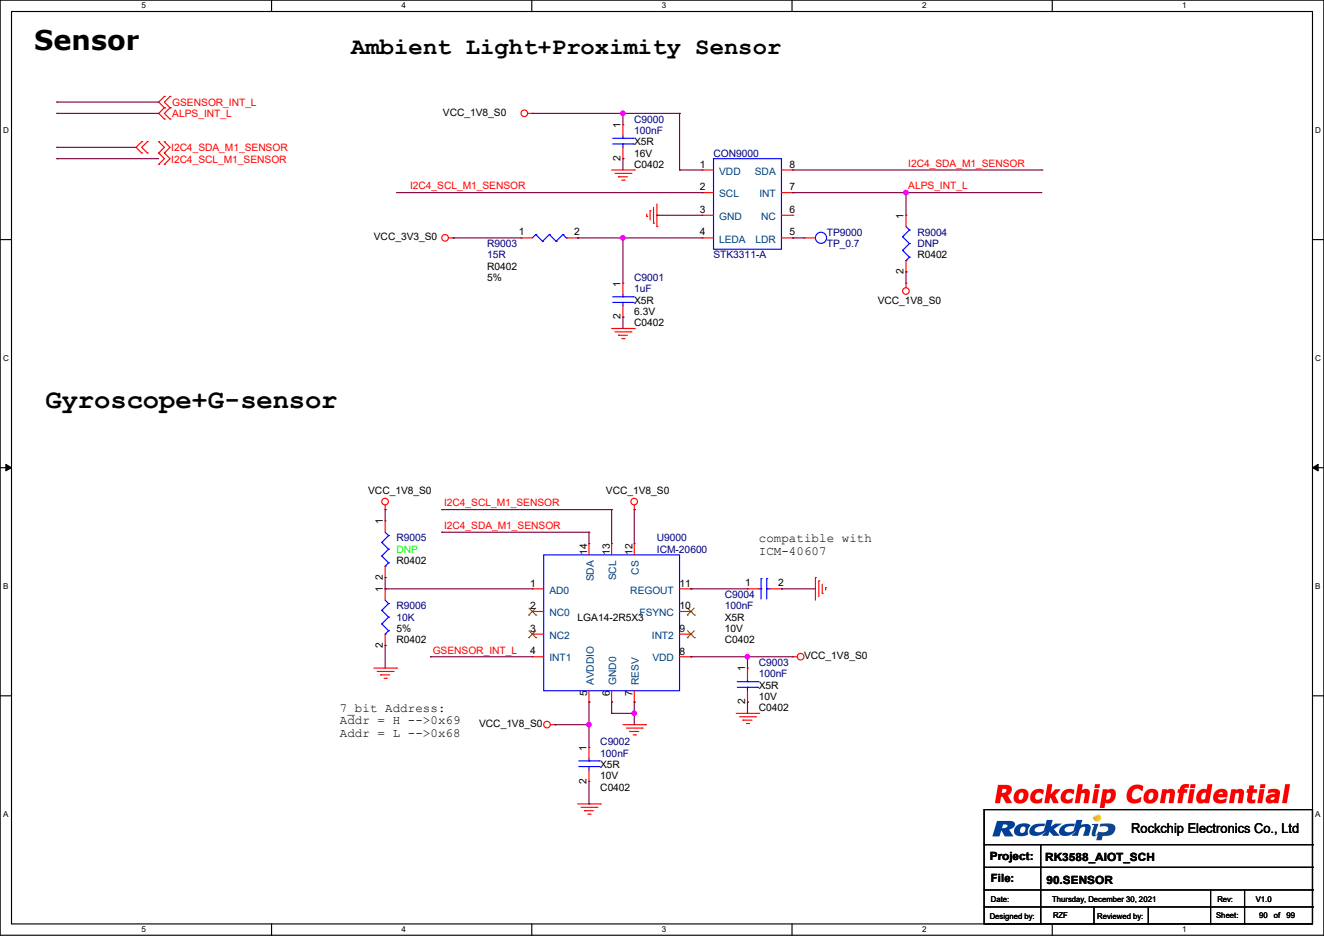
[picture p57: page 57]

REGOUT 11 CS ¹² AVDDIO

# KEY

# ADC=945

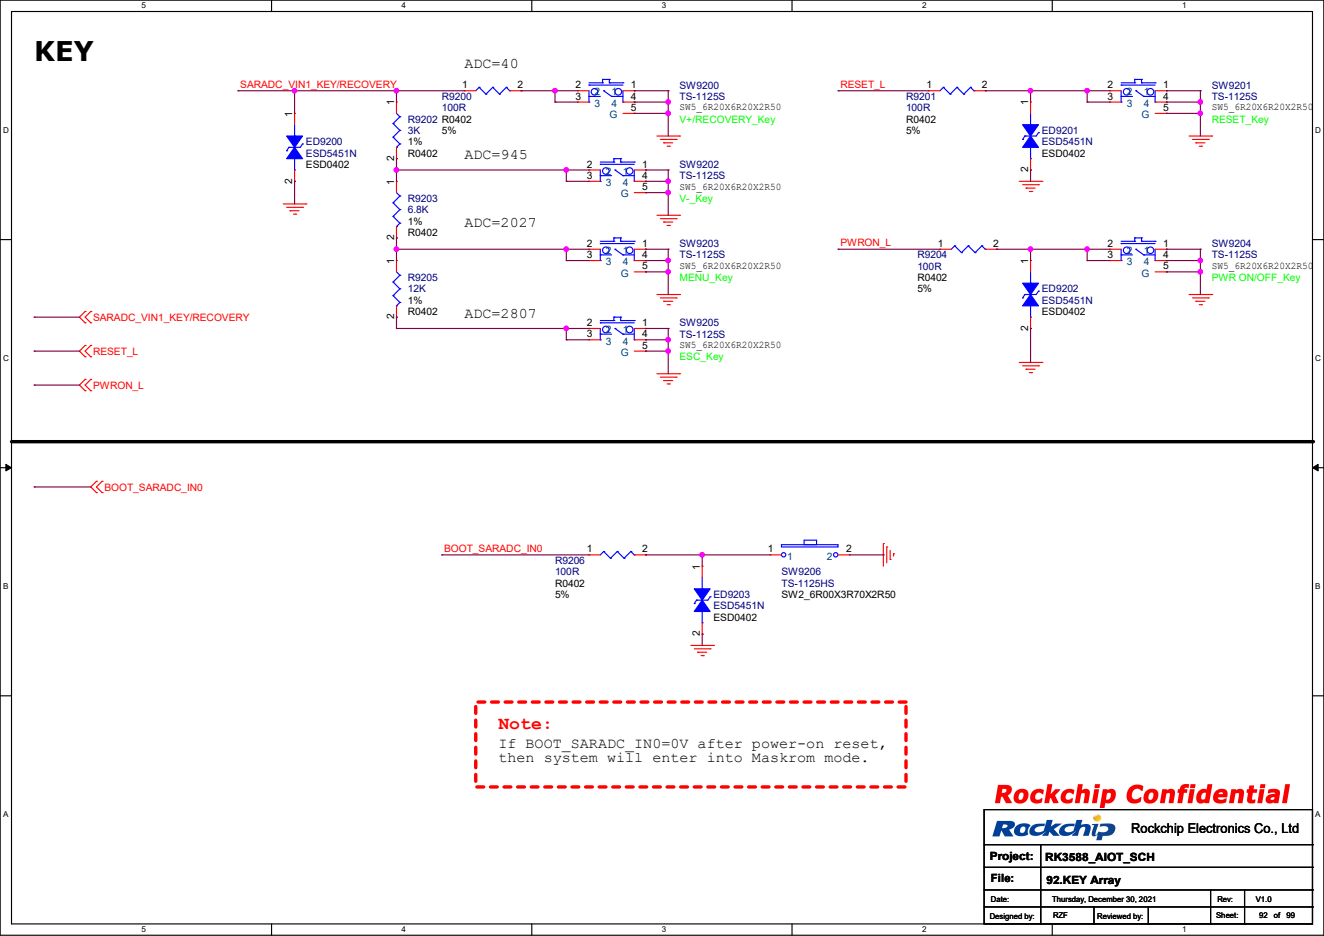
[picture p58: page 58]

Note:
If BOOT_SARADC_IN0=0V after power-on reset,
then system will enter into Maskrom mode.

# UART TO USB(DEBUG)

## VCC_3V3_S3

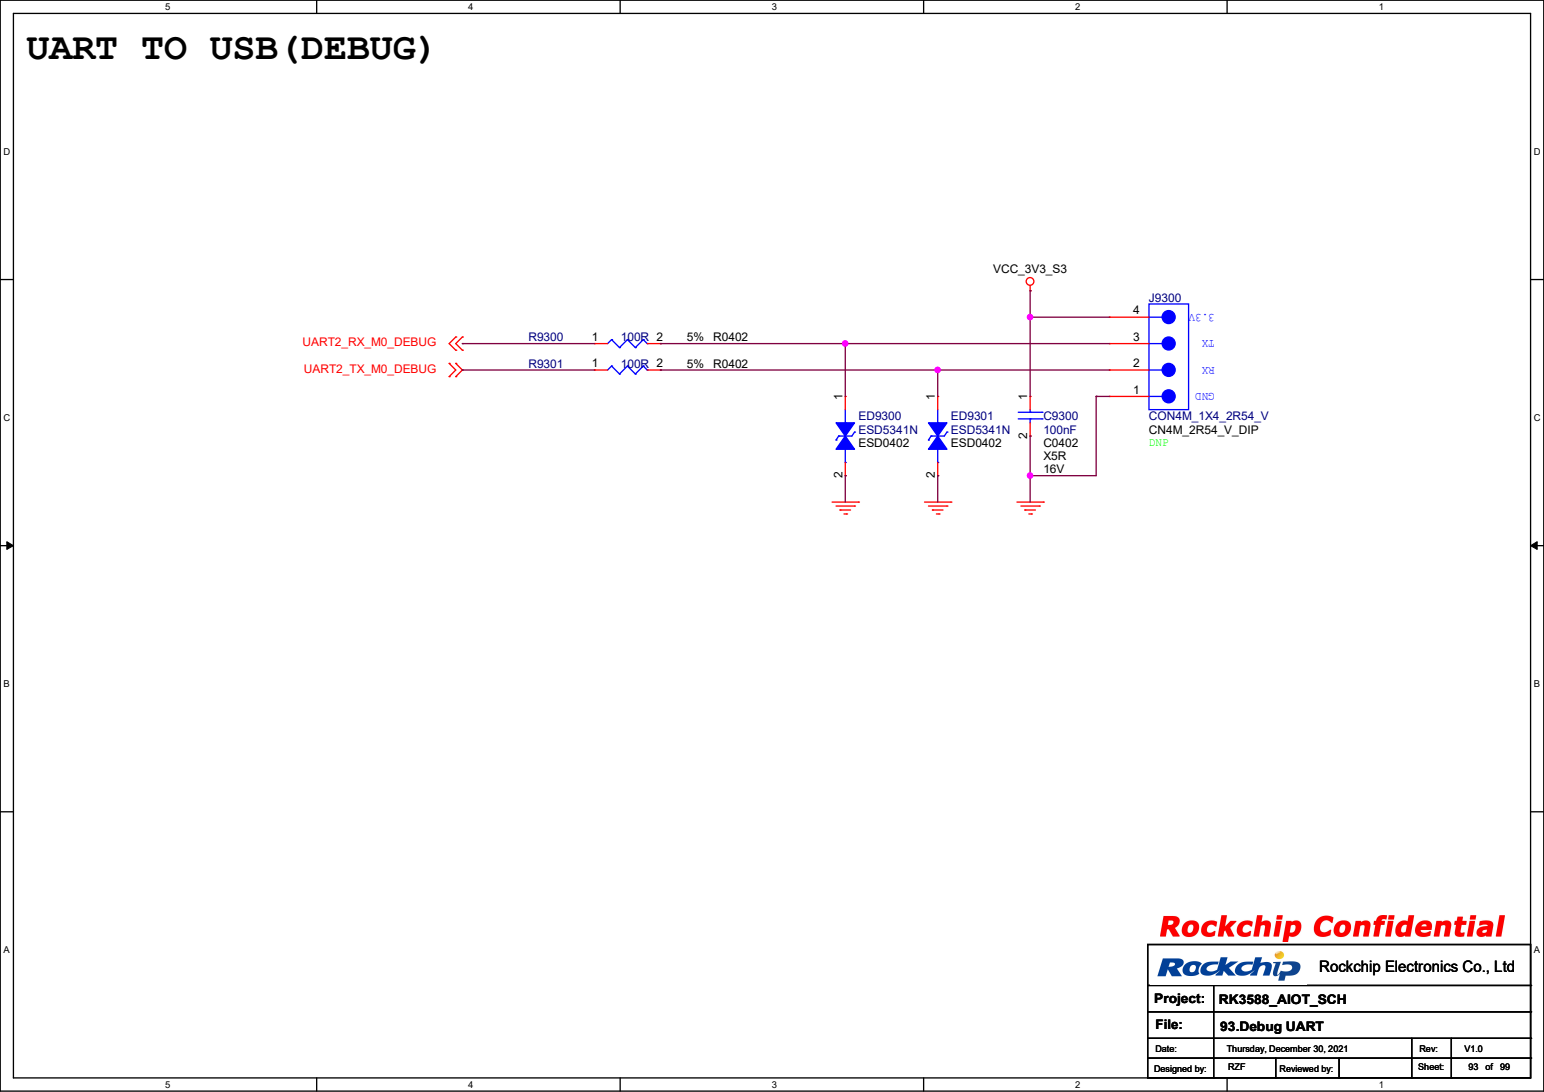
[picture p59: page 59]
UART2_TX_M0_DEBUG; UART2_RX_M0_DEBUG; Project:; File: Date:; Rockchip Electronics Co., Ltd; 93.Debug UART; RK3588_AIOT_SCH; RZF; 99 V1.0 Project:; ED9300 ESD5341N ESD0402; ESD5341N ESD0402; CON4M_1X4_2R54_V CN4M_2R54_V_DIP DNP

TOP Mark | BOTTOM Mark

# Mark

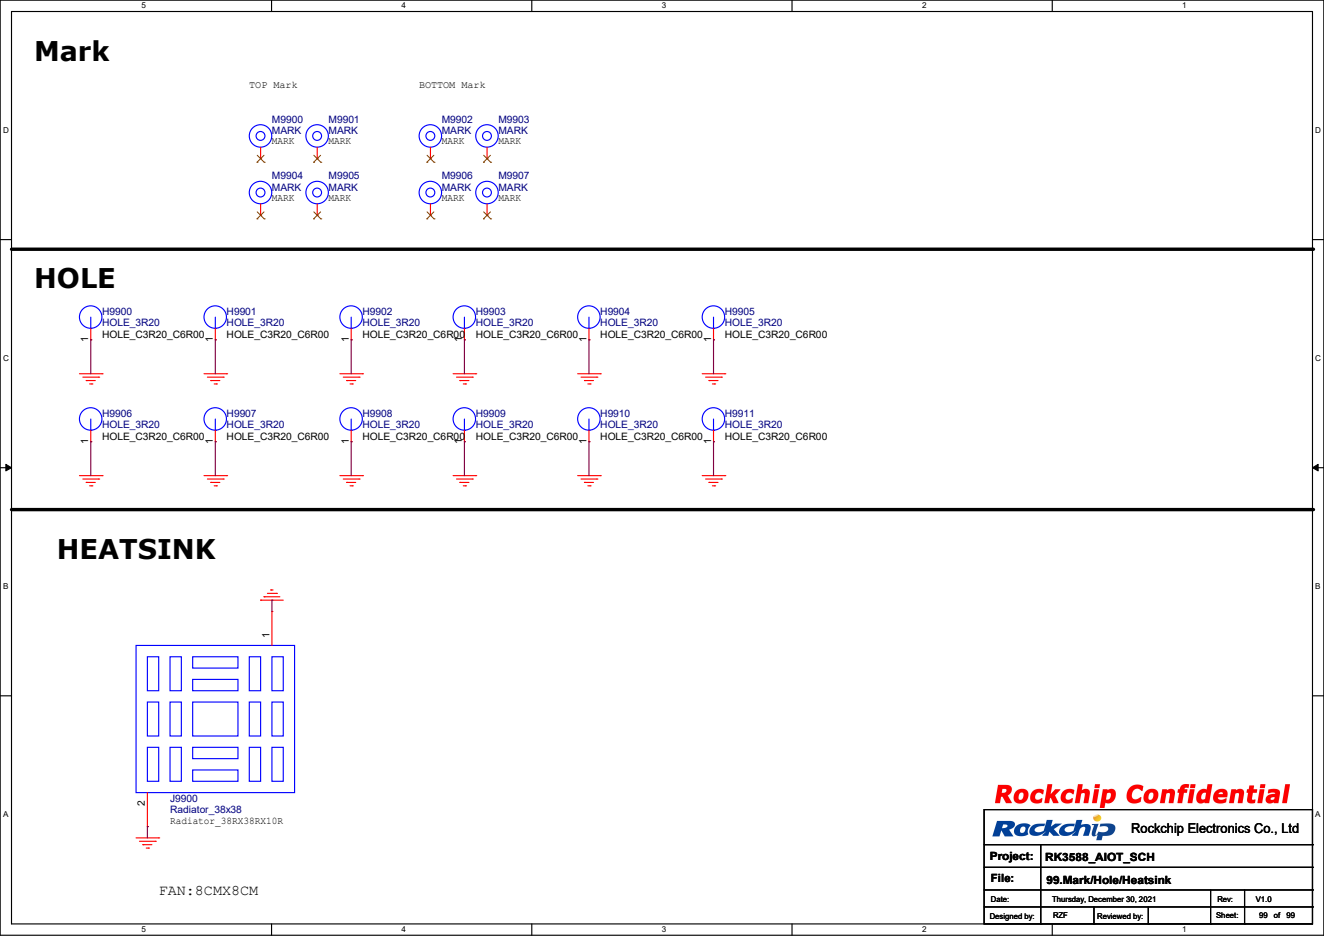
[picture p60: page 60]
HOLE; HEATSINK; FAN:8CMX8CM; Project:; File: Date:; Rockchip Electronics Co., Ltd; RZF; 99 V1.0 Project:; M9907 MARK MARK H9906; HOLE_3R20 HOLE_C3R20_C6R00; 1 M9900 MARK; MARK; H9907 HOLE_3R20 HOLE_C3R20_C6R00; 1 H9901 HOLE_3R20 HOLE_C3R20_C6R00; H9911 HOLE_3R20 HOLE_C3R20_C6R00; M9905 MARK; MARK M9904 MARK MARK; J9900 Radiator_38x38 Radiator_38RX38RX10R; H9909 HOLE_3R20 HOLE_C3R20_C6R00; 1 H9904 HOLE_3R20 HOLE_C3R20_C6R00; 1 H9903 HOLE_3R20 HOLE_C3R20_C6R00; H9900 HOLE_3R20 HOLE_C3R20_C6R00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

RK3588_AIOT_SCH
99.Mark/Hole/Heatsink
