1847123212/RK3588_hdk/(list of files, drawings)

Other design files:
RK3588/01_Official Release/02_DDR Template/01_H1R6_V10_20211229/RK3588_Template_LP4XD200P232SD8_41R0X41R0_2133MHz_H1R6_V10_20211229.DSN
RK3588/01_Official Release/02_DDR Template/01_H1R6_V10_20211229/RK3588_Template_LP4XD200P232SD8_41R0X41R0_2133MHz_H1R6_V10_20211229.pcb
RK3588/01_Official Release/02_DDR Template/02_H1R0_V10_20211230/RK3588_Template_LP4XD200P232SD8_41R0X41R0_2133MHz_H1R0_V10_20211230.DSN
RK3588/01_Official Release/02_DDR Template/02_H1R0_V10_20211230/RK3588_Template_LP4XD200P232SD8_41R0X41R0_2133MHz_H1R0_V10_20211230.pcb
